bitvalo34/trama3-ccviii/hardware/README.md

# Hardware previsto

Una BBB existente y una placa perforada soldable por nodo, tres transmisores y tres receptores de datos, salida y entrada de reloj. Dos PC817 en total. La BOM original conserva cantidades y presupuesto; no se registra ninguna compra nueva.

Aquí se incorporarán esquemas, distribución, netlist y evidencias en las tareas posteriores. No hay circuito validado para energizar. Las fronteras eléctricas y pines propuestos están en el [ADR-0001](../docs/decisiones/ADR-0001-frontera-nodos-y-reloj.md).

## Inspección de las placas

[T02: inspección y diagnóstico](inspecciones/T02-inspeccion-beaglebone.md). Inicio28/10/2026; ejecución física de Erwin y revisión técnica prevista de Adrián. Informe parcial, sin cambios de configuración.
