bitvalo34/trama3-ccviii/hardware/inventario/Pendientes_2026-11-08.md

# Materiales pendientes al 8 de noviembre de 2026

Esta actualización prevalece sobre las brechas provisionales de T03-conciliacion-materiales.md. No registra compras nuevas como recibidas ni modifica el tracker original.

## Lo que ya está cubierto

Erwin confirma recepción de todos los artículos y variantes del pedido electrónico; también dispone de las tres resistencias de 1 kΩ y dos de 10 kΩ que faltaban. Confirma dos fuentes de 5 V / 2.5 A y casi 2 m de alambre negro 22 AWG. Falta conocer el conector de las fuentes y comprobar tensión/polaridad bajo carga. No se prescriben otras fuentes automáticamente.

MaterialesMedios.docx confirma: 1 m de manguera de media pulgada, caja de resortes, cuatro abrazaderas de una pulgada, 24 tuercas M3 paso 0.5, más de 24 tornillos M3×16, tornillos para abrazaderas, 25 arandelas M3, 100 cinchos, nylon 0.5 mm, 24 armellas, cuatro escuadras de una pulgada, 1 m de PVC eléctrico de una pulgada, espuma y dos bases MDF de 300×200 mm. Las fotos respaldan presencia; no miden diámetro interior ni constante de resorte. No recomprar estos artículos sólo por no estar en el pedido electrónico.

Dos tramos de manguera de 30 cm consumen 60 cm; dos tramos ópticos de 30 cm consumen 60 cm. El metro comprado alcanza en longitud. Comprobar el diámetro interior real de la manguera de media pulgada al acoplar los extremos, sin bloquear el paso de sonido.

## Carrito propuesto por el usuario

| Artículo | Cantidad | Total Q |
|---|---:|---:|
| Kit 65 jumpers | 1 | 32.00 |
| Estaño 18 g 60/40 con flux | 1 | 22.00 |
| Tira hembra de 40 pines | 2 | 6.00 |
| Bornera de 3 vías | 6 | 18.00 |
| Bornera de 2 vías | 12 | 24.00 |
| Zócalo DIP28 estrecho | 2 | 5.00 |
| Placa perforada de una cara 9×15 cm | 2 | 30.00 |
| Total sin envío | | 137.00 |

Es una compra propuesta, no recibida. Erwin ya había mencionado zócalos: si conserva dos DIP28 estrechos de 7.62 mm, quitar este renglón evita duplicar Q5. El estaño también es reposición opcional si el existente alcanza. El kit65 no acredita tener conectores hembra: revisar los extremos.

## Compra residual concreta

Precios públicos consultados el 08/11/2026. No se hizo reserva ni compra. En DIY la ficha permite añadir al carrito, pero no expone número de unidades por variante; no confundirlo con cantidad de stock verificada. Tettsa y OXDEA sí publican disponibilidad. Portes no incluidos.

| Uso | Compra propuesta | Unitario Q | Total Q | Fuente y disponibilidad publicada |
|---|---|---:|---:|---|
| Completar M27 y distinguir positivos/señales del negro | 3 m de alambre unifilar 22 AWG, rojo o color distinto | 2.25 | 6.75 | [DIY alambre 22 AWG](https://www.electronicadiy.com/products/cable-para-protoboard), compra habilitada; confirmar venta por metro al seleccionar |
| M41, conexiones flexibles de actuadores | 2 m de cable multifilar 22 AWG, 1 m rojo y 1 m negro | 2.25 | 4.50 | [DIY cable multifilar por metro](https://www.electronicadiy.com/products/cable-para-protoboard-22awg), compra habilitada |
| Arnés desmontable de señales, si el kit65 es sólo macho-macho | 20 jumpers macho-hembra de 20 cm, paso 2.54 mm | 0.85 | 17.00 | [DIY jumper 20 cm](https://www.electronicadiy.com/products/jumper-20-cm), seleccionar pieza macho-hembra, compra habilitada |
| Conectar servo y arneses a placa | 2 tiras macho rectas de 40 pines, paso 2.54 mm | 3.00 | 6.00 | [DIY pin header](https://www.electronicadiy.com/products/pin-header-40-pines), precio publicado; confirmar variante macho al seleccionar |
| Separar las dos placas soldadas de la base | 8 separadores aislantes nylon M3×15 mm hembra-hembra | 2.00 | 16.00 | [Tettsa separador M3×15](https://tienda.tettsa.gt/producto/separador-plastico-m3x15mm/), ficha indexada muestra 56 disponibles |
| Tornillos cortos para el lado de la placa | 8 tornillos M3×6 mm | 0.50 | 4.00 | [Sigma tornillo M3×6](https://electronicasigma.com.gt/producto/tornillo-m3-x-6mm/), En stock |
| Aislar soldaduras de arneses | 2 m termoencogible negro 3 mm, contracción 2:1 | 3.00 | 6.00 | [OXDEA termoencogible 3 mm](https://oxdea.gt/product/tubo-termoencogible-por-metro-de-3mm-color-negro/), En Existencia |
| Sellar alrededor de los acoples y fijación auxiliar | 4 barras de silicón delgadas, sólo si hay pistola compatible | 1.50 | 6.00 | [Sigma silicón delgado](https://electronicasigma.com.gt/producto/barra-de-silicon-delgada/), En stock |
| Total de estos renglones | | | 66.25 | No incluye portes ni adaptadores aún no identificados |

Carrito Q137 + lista Q66.25 = Q203.25 antes de envío. Es un presupuesto de los renglones indicados, no certificación de montaje completo. Si el kit ya trae los conectores requeridos, descontar Q17. Si ya hay zócalos compatibles, descontar Q5 del carrito. Conservar arandelas existentes, no comprarlas de nuevo.

El alambre unifilar adicional se propone de 3 m porque «casi 2 m» no acredita dos metros completos; así supera la previsión original de 4 m. No confundir alambre rígido con cable multifilar para recorridos que se doblan. Las longitudes finales se verifican antes de cortar.

El montaje de las dos BBB requiere también soportes aislantes si no se tienen: se pueden añadir otros 8 separadores y 8 tornillos cortos (Q20 adicionales en las mismas referencias). No duplicarlos si ya están montadas en soportes. Para fijar al MDF, elegir longitud con su espesor real; no forzar tornillos largos hasta hacer tope dentro de un separador.

Si no hay pistola de silicón, existe [EMTOP ULGGU1401 de 20 W, 110–120 V, barra 11.2 mm, con dos barras de 150 mm](https://ferrecity.com.gt/producto/ulggu1401-pistola-p-silicon-20w-120v/) a Q54, con 221 unidades publicadas. Es alternativa a las barras delgadas de la tabla, que no son compatibles con esa pistola; no sumar ambos sin necesidad. Puede conseguirse prestada.

## Pendientes que no justifican comprar a ciegas

- **Fuentes:** reservar las dos de 5 V/2.5 A para actuadores y mantener BBB por Mini USB durante pruebas de banco, si la alimentación resulta estable. Esto no equivale a una solución autónoma terminada. M34 sigue condicionado a cómo se alimentarán las BBB fuera del banco. Conector de fuentes desconocido: si no es Micro USB, los M28 no encajan. Elegir adaptador después de identificarlo; no cortar cables ni unir las salidas de dos fuentes.
- **Aislamiento óptico:** probar el PVC y las tapas contra luz ambiente. La espuma negra ya comprada puede ayudar en juntas. Un recubrimiento negro mate adicional sólo se compra si el interior produce reflejos problemáticos; no cambiar por fibra comercial.
- **Sensores:** el protocolo matricial no exige reemplazos. Medir primero LDR, detector acústico y mecanismo SG90 a 1 Hz. No se acredita una frecuencia máxima por compra ni por simulación.
- **Instrumentación:** falta acceso a osciloscopio o analizador lógico compatible para reloj/latencias. Puede ser prestado. El multímetro no reemplaza esa medida. No se cotiza como adquisición obligatoria.
- **Acoples:** las borneras deben encajar en la retícula de la placa; 5.08 mm corresponde a dos pasos de 2.54 mm. Confirmar la medida concreta. No forzar componentes al soldar.
- **Protección:** MCP23017 no es aislamiento galvánico ni garantía contra un cableado incorrecto. Verificar niveles en las entradas BBB y drivers según esquemas antes de conectar.

No cerrar T05 únicamente porque los sensores llegaron: queda recibir o confirmar el montaje residual y resolver conectores/alimentación. T03 puede actualizar su inventario con estas declaraciones, sin convertir el carrito en recibido ni dar por verificadas las pruebas eléctricas.
