bitvalo34/trama3-ccviii/hardware/diseno-placas/netlist/redes.csv

red | terminales
+3V3_LOGIC | U1.9; C4.1; R1.1; R2.1; R3.1; J10.1; J5.1; J6.1; R17.1; R18.1; R19.1; R26.1; R31.1; TP3.1
+5V_ACT | J12.2; C1.1; C2.1; J13.1; R6.1; J3.1; D1.2; TP1.1
+5V_FUSED | J14.2; J12.3
+5V_RAW | J1.1; J14.1; J11.1
+5V_SERVO | J13.2; J4.2; R12.1; R15.1; C3.1
AUD_BBB | J10.8; JP5.2
AUD_RAW | J6.3; R18.2; JP11.1; TP6.1
BUZZ_BASE | Q2.2; R7.2; R8.1
BUZZ_NEG | Q2.3; J3.2; D1.1
C0_SEL | JP10.2; R20.1; R23.1
C0_TEST | R20.2; JP4.1
C0_TX | U1.21; R4.1
C1_SEL | JP11.2; R21.1; R24.1
C1_TEST | R21.2; JP5.1
C1_TX | U1.22; R7.1
C2_SEL | JP12.2; R22.1; R25.1
C2_TEST | R22.2; JP6.1
CLK_BASE | Q5.2; R28.2; R29.1
CLK_BBB | J10.10; JP7.2
CLK_REMOTE_A | J8.1; U2.1; D2.2
CLK_REMOTE_K | J8.2; U2.2; D2.1
CLK_RX_RAW | U2.4; R26.2; R27.1; TP8.1
CLK_SEND_A | R31.2; J9.1
CLK_SINK | Q5.3; J9.2
CLK_TEST | R27.2; JP7.1
CLK_TX | J10.6; R28.1; TP10.1
GATE_POL | J12.1; R30.1
GND_ACT | J1.2; R30.2; C1.2; C2.2; NT1.1; J11.2; J13.6; J4.1; Q3.1; Q4.1; R11.2; R14.2; R16.2; C3.2; Q1.1; R5.2; Q2.1; R8.2; TP2.1
GND_LOGIC | NT1.2; U1.10; U1.15; U1.16; U1.17; C4.2; JP1.2; J10.2; J5.2; J6.2; J7.1; C5.2; JP10.3; R23.2; JP11.3; R24.2; JP12.3; R25.2; U2.3; Q5.1; R29.2; TP4.1
I2C_SCL | U1.12; JP2.2; J10.3
I2C_SDA | U1.13; JP3.2; J10.4
LED_A | R6.2; J2.1
LED_BASE | Q1.2; R4.2; R5.1
LED_K | Q1.3; J2.2
MCP_RESET | U1.18; R1.2; JP1.1
MECH_BBB | J10.9; JP6.2
MECH_RAW | J7.2; R19.2; C5.1; JP12.1; TP7.1
OPT_BBB | J10.7; JP4.2
OPT_RAW | J5.3; R17.2; JP10.1; TP5.1
PWM_5V | J13.4; Q4.3; R15.2
PWM_B1 | Q3.2; R10.2; R11.1
PWM_B2 | Q4.2; R13.2; R14.1
PWM_BBB | R10.1; J10.5
PWM_INV | Q3.3; R12.2; R13.1
SCL_PULL | R2.2; JP2.1
SDA_PULL | R3.2; JP3.1
SERVO_SIG | J13.5; J4.3; R16.1; TP9.1
