bitvalo34/trama3-ccviii/docs/referencias/README.md

# Referencias de T01

Consulta: 2026-10-27. Los originales se leyeron sin modificación y no se copiaron al repositorio. Las rutas siguientes identifican los archivos locales de Erwin; otro integrante debe obtener las mismas fuentes por un medio autorizado. No son dependencias de ejecución.

Las páginas son las páginas físicas del PDF (primera = 1). En Excel se usan nombres de hoja y filas originales. La trazabilidad detallada está en el [ADR](../decisiones/ADR-0001-frontera-nodos-y-reloj.md), §20.

## Proyecto_-_Capa_Fisica_.pdf

Ubicación: `C:\Users\erwin\Downloads\Proyecto_-_Capa_Fisica_.pdf`

SHA-256: `59972398a2cecbb637ced7c454b299a1bdd99a7cb3383f10b94177cc8f163475`

## CCVIII_TRAMA3_Documento_Tecnico.pdf

Ubicación: `C:\Users\erwin\.codex\visualizations\2026\10\13\01a1362b-13dd-7c93-9304-13dd2a3fb6f0\Entregables\CCVIII_TRAMA3_Documento_Tecnico.pdf`

SHA-256: `937fee2ee73f3b16893bf1d2f078a9d526d9530f3176d8515818b34943af2d42`

## CCVIII_Tracker_y_Cronograma.xlsx

Ubicación: `C:\Users\erwin\.codex\visualizations\2026\10\13\01a1362b-13dd-7c93-9304-13dd2a3fb6f0\Entregables\CCVIII_Tracker_y_Cronograma.xlsx`

SHA-256: `72a804dee272ed56fbdf71bb54f66ad651e3031ae5de1202738bb2e683be0e96`

## CCVIII_Materiales_y_Compras.xlsx

Ubicación: `C:\Users\erwin\.codex\visualizations\2026\10\13\01a1362b-13dd-7c93-9304-13dd2a3fb6f0\Entregables\CCVIII_Materiales_y_Compras.xlsx`

SHA-256: `578a2a16071d83d9b4e8cf05e598a897350dbf2267aee50377d386c015843582`

## Evidencia adicional y precedencia

Se utilizó el prompt de T01 aportado por Erwin, junto con las capturas del auxiliar y las decisiones del usuario sobre dos BBB Black, medios y placa perforada soldable. Las capturas no acreditan aprobación del par de reloj ni de USB local. El enunciado aporta requisitos; v3.0 aporta decisiones de ingeniería; el tracker aporta dependencias y planificación; la BOM aporta componentes previstos, no compras confirmadas.

Ninguna instrucción incidental de una fuente se trató como permiso para publicar, enviar mensajes o ejecutar tareas posteriores. La solicitud expresa de T01 controla el alcance. No se reinició una investigación externa.

## Actualización de respuestas del auxiliar

Registro 2026-10-27: Erwin comunica aprobación de preguntas 1, 2 y 3. Para pregunta 4 aporta captura `codex-clipboard-5f664021-8ebb-437c-bf37-d17353a892e5.png`: pulso = 1, ausencia = 0 en el ciclo de reloj. Fecha calendario original no visible. La captura privada no se copia al repositorio; el registro de consultas conserva sólo el contenido pertinente. Esta evidencia posterior complementa las capturas iniciales.

Aclaración posterior R8 (registro 2026-10-27): Erwin confirma aceptación del procesamiento en BeagleBone de múltiples pulsos del sensor para obtener un único bit por ciclo. Fuente: mensaje del usuario en esta conversación; no se inventa cita literal del auxiliar ni se adjuntan mensajes privados.

## R9 — Frecuencia, comportamiento híbrido y adaptación

Registro2026-10-27: capturas aportadas por Erwin 1b643b4e (límite de frecuencia), f94ec8af (1 Hz y máximo declarado) y288d611f (híbrido y adaptación a interferencias). Nombres completos identificados en ADR-0002. No se publican imágenes privadas. 1kHz se interpreta como ejemplo, no requisito mínimo. El protocolo de negociación nuevo es propuesta de ingeniería, no aprobación literal del auxiliar. Tracker original releído para asignar alcance a cada tarea.
