bitvalo34/trama3-ccviii/hardware/inspecciones/evidencias/README.md

# Evidencia de T02

Inicio28/10/2026. El [informe](../T02-inspeccion-beaglebone.md) resume consultas Windows Get-NetAdapter, Get-NetIPAddress, Get-PnpDevice y Get-PnpDeviceProperty, ping y conexión TCP22 limitada a2,5s. Posteriormente Erwin compartió captura de su sesión SSH autenticada: Debian10 Buster, kernel4.19.94-ti-r42, armv7l y uptime14min. Se transcriben sólo resultados pertinentes; no se publica la captura, que incluye información de acceso y red.

No se publican números de serie, MAC, identificadores únicos USB, credenciales ni volcado de redes del anfitrión. Se omiten direcciones internas y banner SSH exacto del registro público. No hay fotografías ni evidencia de BBB-B todavía.

Cada nueva evidencia debe indicar fecha, placa, procedimiento, resultado y límites. Antes de publicar revisar identificadores y guardar sólo extractos pertinentes. Distinguir observación física de inferencia.

Evidencia aportada: `codex-clipboard-2fbf805f-1848-42a9-b130-c92d83c231c9.png`, conservada fuera del repositorio público. Confirmación textual de Erwin: Mini USB únicamente y ningún accesorio.

Segunda captura: `codex-clipboard-268b4e4f-0846-452b-a13e-f8ea41f85a08.png`. Se transcriben modelo, RAM, almacenamiento, montaje y0unidades fallidas en el informe. Observación textual asociada: alimentación fija, D2 parpadea y D4 tenue. Captura original no publicada.

Tercera captura: `codex-clipboard-b3606f9c-fe50-412e-a091-e6a684b551ce.png`: tipo MMC, dispositivos remoteproc/I2C/PWM, herramientas presentes y triggers de LEDs. Valores pertinentes transcritos; sin publicar imagen.

Cierre 07/11/2026: el informe consolida las capturas posteriores de B y la confirmación textual de Erwin sobre ambas placas, cables y herramientas. La indicación anterior de ausencia de evidencia de B corresponde sólo al inicio del registro. No se publican las capturas ni credenciales.
