bitvalo34/trama3-ccviii/hardware/diseno-placas/planos/A-inferior.png

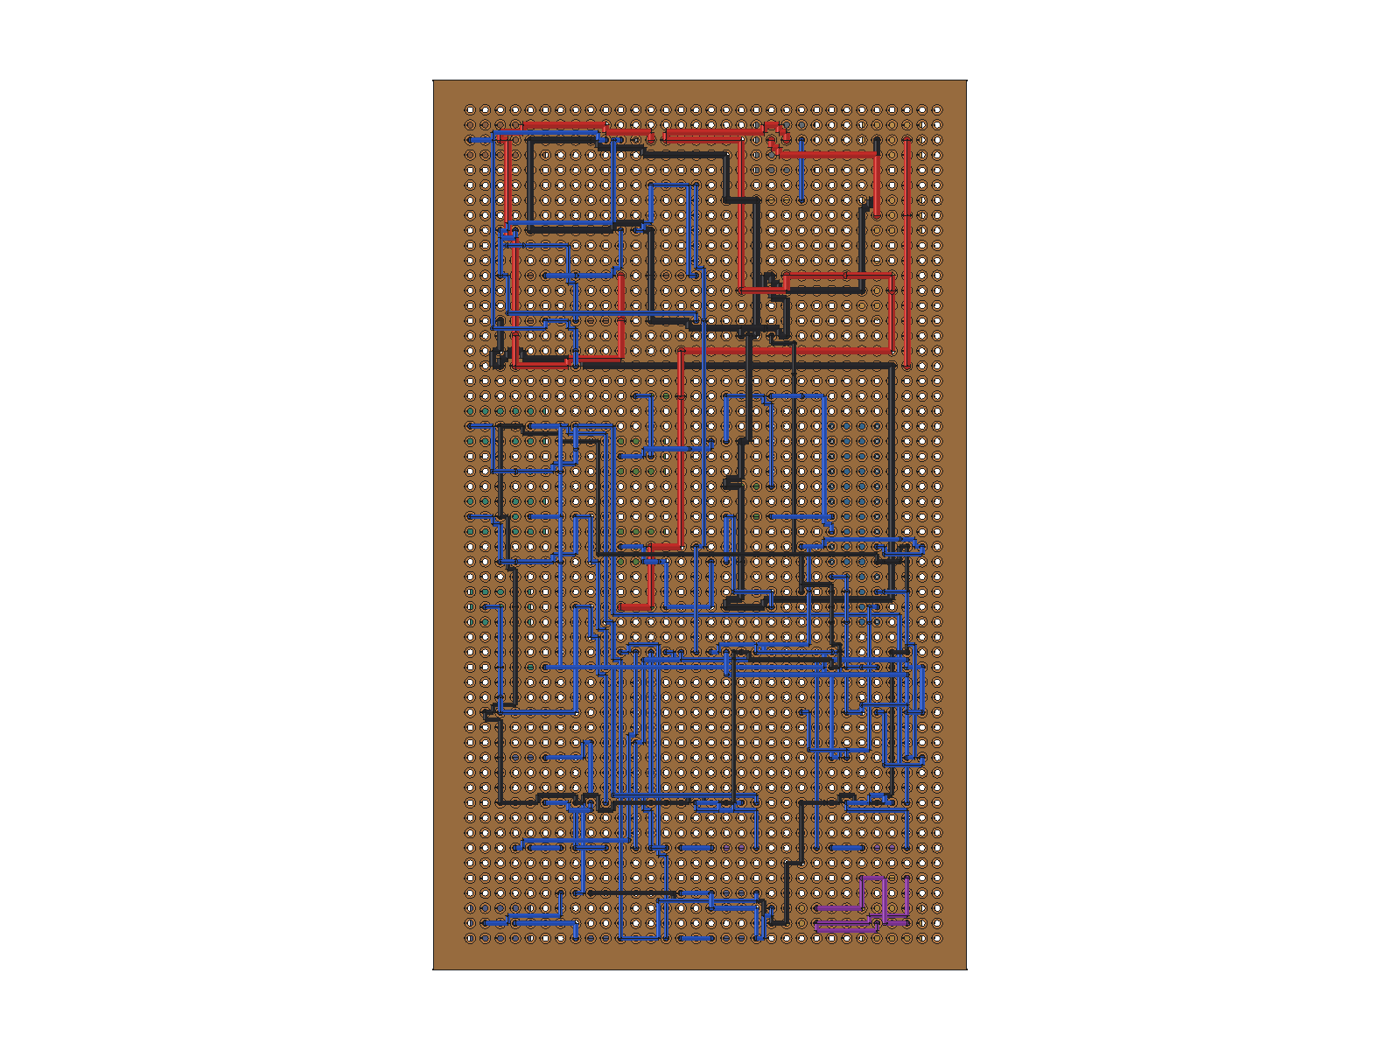
hardware/diseno-placas/planos/A-inferior.png
