bitvalo34/trama3-ccviii/hardware/diseno-placas/planos/A-isometrica.png

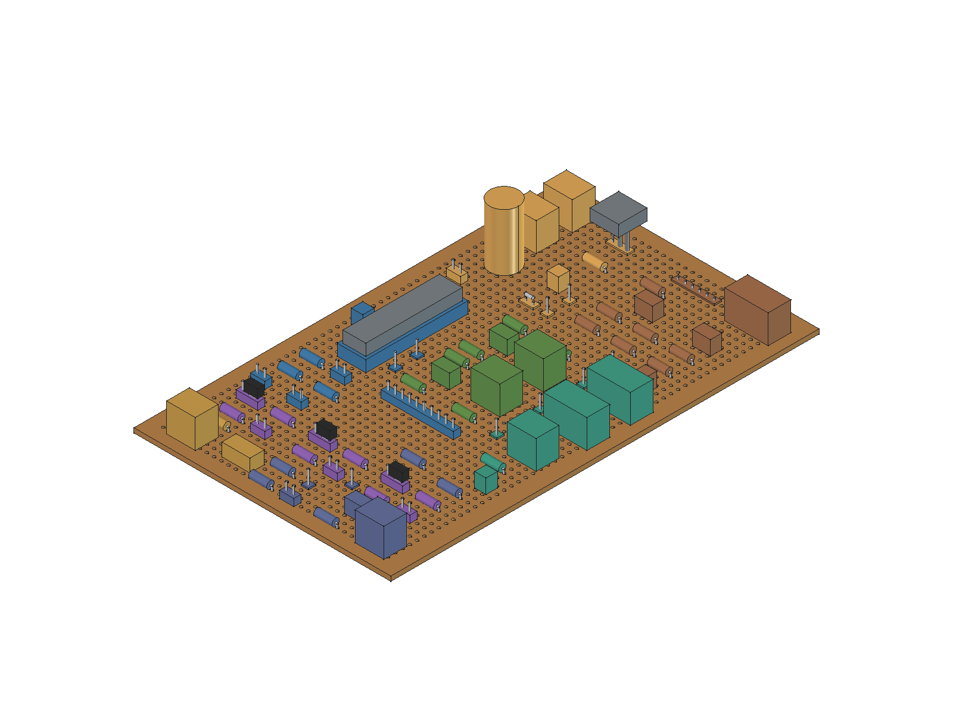
hardware/diseno-placas/planos/A-isometrica.png
