bitvalo34/trama3-ccviii/hardware/diseno-placas/planos/A-lateral.png

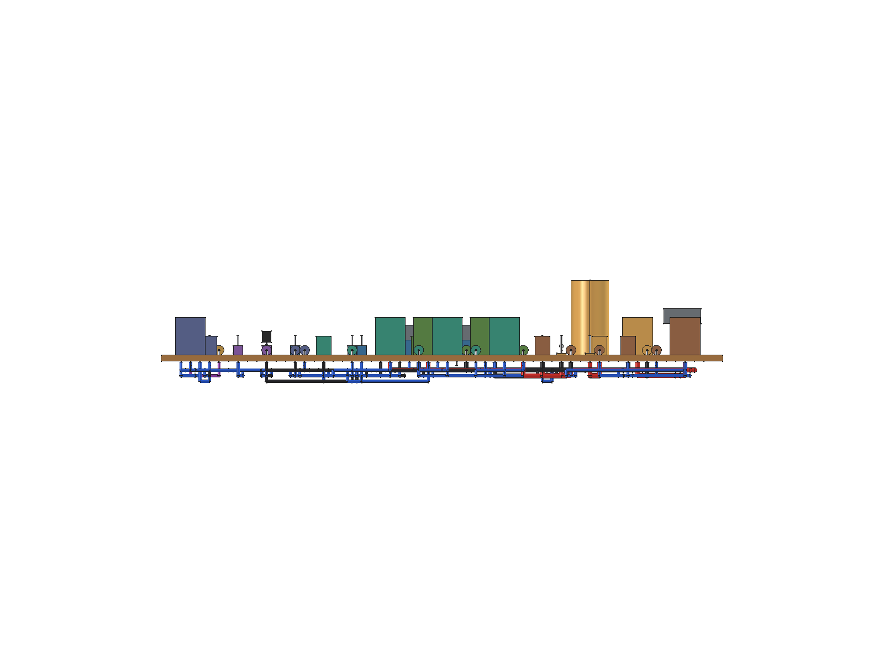
hardware/diseno-placas/planos/A-lateral.png
