bitvalo34/trama3-ccviii/hardware/diseno-placas/planos/A-posterior.png

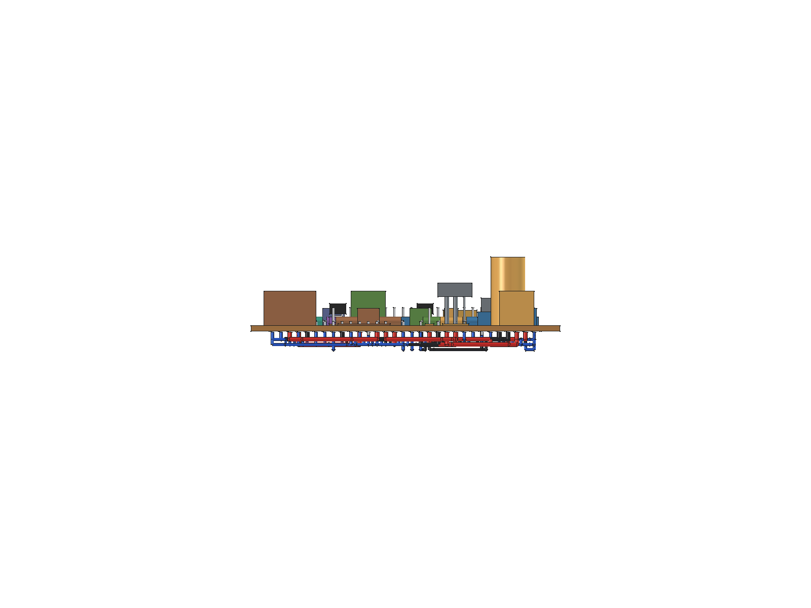
hardware/diseno-placas/planos/A-posterior.png
