bitvalo34/trama3-ccviii/hardware/diseno-placas/planos/A-superior.png

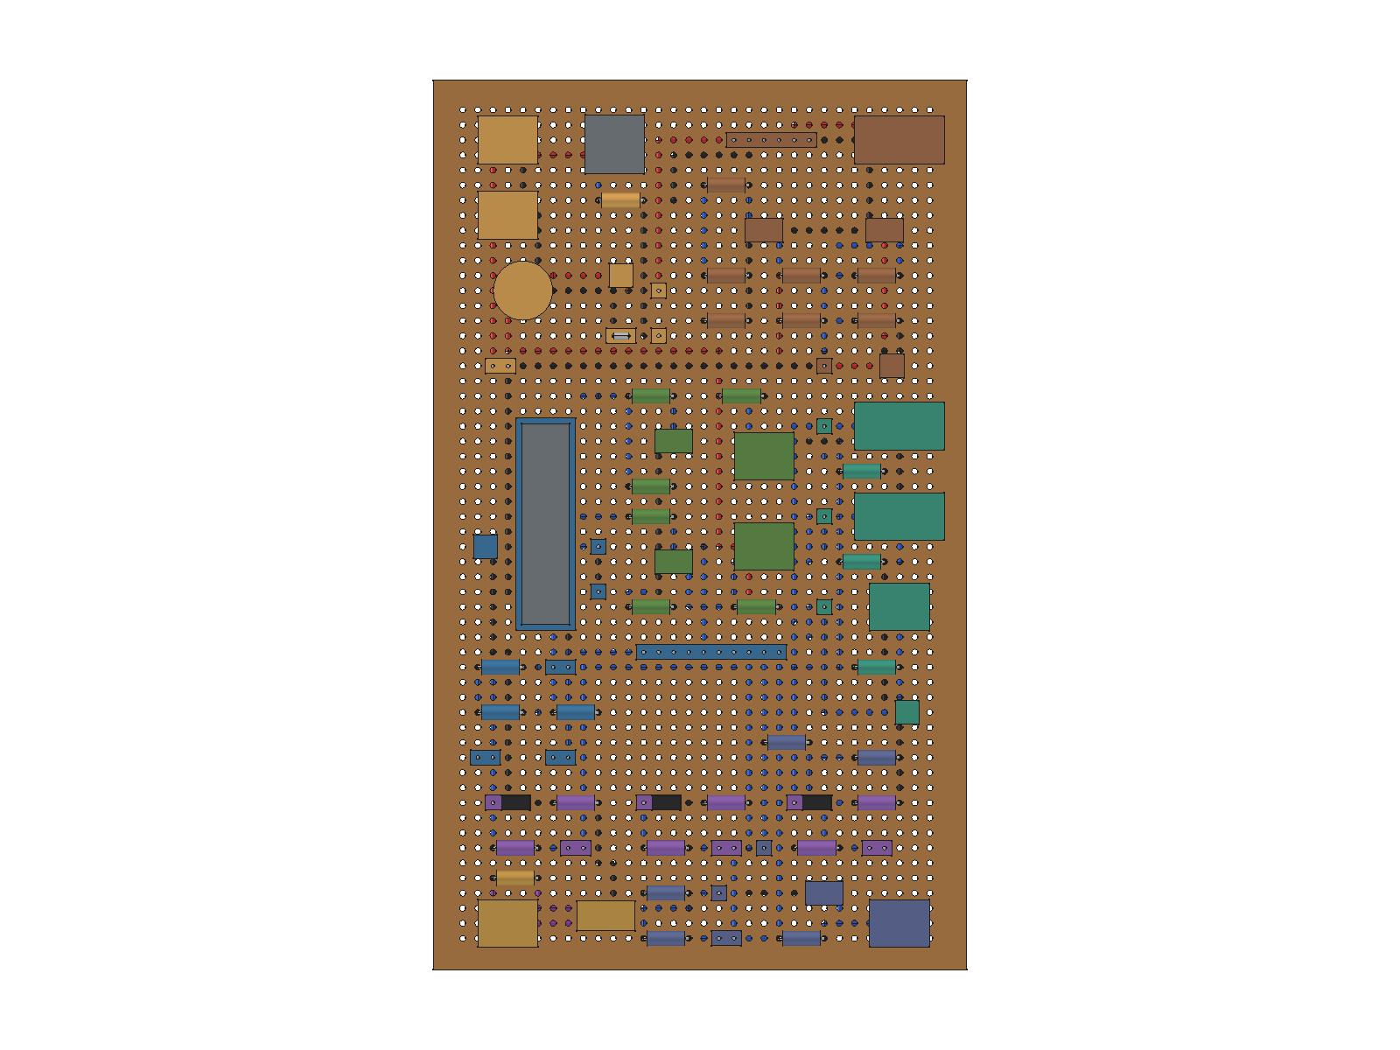
hardware/diseno-placas/planos/A-superior.png
