bitvalo34/trama3-ccviii/hardware/inventario/CCVIII_Materiales_y_Compras_T03.xlsx

Sheet: Dashboard
TRAMA 3 BeagleBone Black Compras v3
Medios elegidos y placa perforada soldable. 2 BBB existentes. Ámbar = editable.
Concepto | Importe o valor | Interpretación | Categoría | Costo sin otros reusos Q
Materiales sin otros reusos | Q 912.00 | BBB existentes Q0; excluye costo de reemplazarlas | Óptico | Q 53.50
Compra con inventario | Q 912.00 | Descuenta existencia declarada o inventario aprobado | Acústico | Q 81.00
Reserva | 10.0% | Porcentaje editable | Mecánico | Q 98.00
Total base con reserva | Q 1003.20 | Incluye montaje soldado y 2 fuentes BBB provisionadas | Protecciones | Q 55.50
Total con inventario y reserva | Q 1003.20 | Presupuesto actual de compra | Compartida | Q 624.00
Gasto pendiente sin reserva | Q 912.00 | Compra menos pagos registrados | Placas | Q 0.00
Objetivo completo | Q 1200.00 | Límite orientativo de desembolso
Margen frente a objetivo | Q 196.80 | Positivo significa dentro del objetivo
Publicado en fichas | Q 588.00 | No equivale a cantidad física confirmada
Provisiones sin cotización | Q 324.00 | Materiales locales, fuentes y montaje
Ahorro adicional por inventario | Q 0.00 | Adicional a las dos BBB ya incluidas a Q0
Presupuesto anterior v2 | Q 918.50 | Referencia con BBB y protoboards
Cambio frente a v2 | Q 84.70 | Positivo = aumento por montaje soldado
Provisiones sin cotización | 8 | No cuenta las BBB declaradas; confirmar 8 partidas
Fecha de revisión | 2026-10-15 | Nuevos precios 15/10; anteriores mantienen fecha en BOM

Sheet: BOM maestra
Materiales para ambos equipos
32 fichas de compra, 8 provisiones y 2 BBB declaradas. Selección confirmada; compra pendiente de registrar.
ID | Categoría | Subsistema | Material | Modelo | Variante | Por TX | Por RX | Por equipo | Total proyecto | Disponible propio | Por comprar | Precio unitario Q | Compra Q | Sin otros reusos Q | Proveedor | Enlace directo | Disponibilidad | Unidades publicadas | Verificado | Alternativa | Prioridad | Observaciones | Base del precio | Pagado Q | Gasto pendiente Q
M01 | Placas | Control | BeagleBone Black existente | BeagleBone Black AM335x | Modelo confirmado por el usuario | 0 | 0 | 1 | 2 | 2 | 0 | Q 0.00 | Q 0.00 | Q 0.00 | Inventario de Erwin y Adrián | Inventario declarado | Existencia confirmada por usuario | 2 placas declaradas; arranque por comprobar | 2026-10-13 |  | Alta | Costo incremental Q0; no es precio de reposición. Verificar revisión, Debian, eMMC, conectores y alimentación. No comprar ESP32. | Reutilizado | Q 0.00 | Q 0.00
M02 | Compartida | GPIO | Expansor GPIO | MCP23017 DIP28 | Variante única | 0 | 0 | 1 | 2 | 0 | 2 | Q 52.00 | Q 104.00 | Q 104.00 | Electrónica DIY | HYPERLINK is not implemented. linkLocation=https://www.electronicadiy.com/products/mcp23017?variant=40473663832246, friendlyName=Abrir variante | Disponible y verificado | No publica cantidad; confirmar lote | 2026-10-13 |  | Alta | VDD 3.3 V; A0 A1 A2 a GND; dirección 0x20. No aislamiento. No usar GPA7/GPB7 de entrada. | Publicado | Q 0.00 | Q 104.00
M03 | Óptico | Luz | LED rojo transparente | LED 5 mm rojo | Rojo | 1 | 0 | 1 | 2 | 0 | 2 | Q 0.75 | Q 1.50 | Q 1.50 | Electrónica DIY | HYPERLINK is not implemented. linkLocation=https://www.electronicadiy.com/products/led-transparente-5mm-diferentes-colores?variant=33522998345867, friendlyName=Abrir variante | Disponible y verificado | No publica cantidad; confirmar lote | 2026-10-13 |  | Alta | Transmisor; resistencia de 330 ohm; no LED intermitente. | Publicado | Q 0.00 | Q 1.50
M04 | Óptico | Luz | Módulo LDR digital | D6 LDR LM393 | Variante única | 0 | 1 | 1 | 2 | 0 | 2 | Q 16.00 | Q 32.00 | Q 32.00 | Electrónica DIY | HYPERLINK is not implemented. linkLocation=https://www.electronicadiy.com/products/sensor-de-luz?variant=33523038847115, friendlyName=Abrir variante | Disponible y verificado | No publica cantidad; confirmar lote | 2026-10-13 |  | Alta | Alimentar a 3.3 V. Confirmar VOH y VOL reales antes de conectar. | Publicado | Q 0.00 | Q 32.00
M05 | Acústico | Sonido | Buzzer activo | Buzzer activo 2 terminales | Activo | 1 | 0 | 1 | 2 | 0 | 2 | Q 3.50 | Q 7.00 | Q 7.00 | Electrónica DIY | HYPERLINK is not implemented. linkLocation=https://www.electronicadiy.com/products/buzzer-sin-modulo?variant=33522945851531, friendlyName=Abrir variante | Disponible y verificado | No publica cantidad; confirmar lote | 2026-10-13 |  | Alta | Exigir variante 5 V y consumo <=30 mA; si no se confirma usar módulo activo como alternativa. | Publicado | Q 0.00 | Q 7.00
M06 | Acústico | Sonido | Detector de sonido | KY037 SKU D14 | Variante única | 0 | 1 | 1 | 2 | 0 | 2 | Q 19.00 | Q 38.00 | Q 38.00 | Electrónica DIY | HYPERLINK is not implemented. linkLocation=https://www.electronicadiy.com/products/sensor-de-sonido-ky-038?variant=33523035799691, friendlyName=Abrir variante | Disponible y verificado | No publica cantidad; confirmar lote | 2026-10-13 |  | Alta | URL dice KY038 y ficha KY037. Confirmar el módulo servido. DO es pulsante; contador de flancos, no lectura única. | Publicado | Q 0.00 | Q 38.00
M07 | Mecánico | Tensión | Servo posicional | SG90 180 grados | Variante única | 1 | 0 | 1 | 2 | 0 | 2 | Q 27.00 | Q 54.00 | Q 54.00 | Electrónica DIY | HYPERLINK is not implemented. linkLocation=https://www.electronicadiy.com/products/micro-servo-sg90-1-6kg-torque?variant=33523024494731, friendlyName=Abrir variante | Disponible y verificado | No publica cantidad; confirmar lote | 2026-10-13 |  | Alta | No aceptar servo continuo 360 grados. Fuente 5 V externa local. Recorrido inicial 20 grados. | Publicado | Q 0.00 | Q 54.00
M08 | Mecánico | Tensión | Final de carrera | SPDT con rueda | Con Rueda | 0 | 1 | 1 | 2 | 0 | 2 | Q 7.00 | Q 14.00 | Q 14.00 | Electrónica DIY | HYPERLINK is not implemented. linkLocation=https://www.electronicadiy.com/products/switch-final-de-carrera?variant=33522901024907, friendlyName=Abrir variante | Disponible y verificado | No publica cantidad; confirmar lote | 2026-10-13 |  | Alta | COM y NO locales al receptor. El único vínculo de datos mecánico es nylon sin metal. | Publicado | Q 0.00 | Q 14.00
M09 | Protecciones | Drivers | Transistor NPN | 2N2222 | 2N2222-NPN | 2 | 0 | 2 | 4 | 0 | 4 | Q 0.75 | Q 3.00 | Q 3.00 | Electrónica DIY | HYPERLINK is not implemented. linkLocation=https://www.electronicadiy.com/products/transistores?variant=33523007357067, friendlyName=Abrir variante | Disponible y verificado | No publica cantidad; confirmar lote | 2026-10-13 |  | Alta | Uno para LED y otro buzzer. Revisar pinout del lote. Base 1k, base a GND 10k. | Publicado | Q 0.00 | Q 3.00
M10 | Protecciones | Servo | Transistor de señal | 2N3904 | 2N3904-NPN | 1 | 0 | 1 | 2 | 0 | 2 | Q 0.75 | Q 1.50 | Q 1.50 | Electrónica DIY | HYPERLINK is not implemented. linkLocation=https://www.electronicadiy.com/products/transistores?variant=33523007422603, friendlyName=Abrir variante | Disponible y verificado | No publica cantidad; confirmar lote | 2026-10-13 |  | Alta | Inversor 3.3 a 5 V para servo. Base 4.7k; pull-up 10k del lado P9_14 a 3.3 V, NO directamente en la base. PWM invertida. | Publicado | Q 0.00 | Q 1.50
M11 | Protecciones | Reloj | Optoacoplador | PC817 DIP4 | Variante única | 0 | 1 | 1 | 2 | 0 | 2 | Q 4.00 | Q 8.00 | Q 8.00 | Electrónica DIY | HYPERLINK is not implemented. linkLocation=https://www.electronicadiy.com/products/optoacoplador-pc817?variant=46738098618626, friendlyName=Abrir variante | Disponible y verificado | No publica cantidad; confirmar lote | 2026-10-13 |  | Alta | 1 ánodo 2 cátodo del emisor remoto; 3 emisor y 4 colector locales. Dos hilos por reloj. | Publicado | Q 0.00 | Q 8.00
M12 | Protecciones | Inductiva | Diodo rueda libre | 1N4148 | Variante única | 1 | 0 | 1 | 2 | 0 | 2 | Q 0.75 | Q 1.50 | Q 1.50 | Electrónica DIY | HYPERLINK is not implemented. linkLocation=https://www.electronicadiy.com/products/diodo-1n4148-recuperacion-rapida-100-v-200-ma?variant=42863743664386, friendlyName=Abrir variante | Disponible y verificado | No publica cantidad; confirmar lote | 2026-10-13 |  | Alta | Paralelo al buzzer si es magnético <=30mA; cátodo a +5 V. No colocar un diodo sobre alimentación del servo. | Publicado | Q 0.00 | Q 1.50
M13 | Protecciones | LED | Resistencia 1/4W | 330 ohm | 330 | 0 | 0 | 1 | 2 | 0 | 2 | Q 0.50 | Q 1.00 | Q 1.00 | Electrónica DIY | HYPERLINK is not implemented. linkLocation=https://www.electronicadiy.com/products/resistencias-por-unidad-1-4w?variant=33598010261643, friendlyName=Abrir variante | Disponible y verificado | No publica cantidad; confirmar lote | 2026-10-13 |  | Alta | Limita LED rojo a aprox 8.5mA desde 5V | Publicado | Q 0.00 | Q 1.00
M14 | Protecciones | Reloj | Resistencia 1/4W | 390 ohm | 390 | 0 | 0 | 1 | 2 | 0 | 2 | Q 0.50 | Q 1.00 | Q 1.00 | Electrónica DIY | HYPERLINK is not implemented. linkLocation=https://www.electronicadiy.com/products/resistencias-por-unidad-1-4w?variant=33598010327179, friendlyName=Abrir variante | Disponible y verificado | No publica cantidad; confirmar lote | 2026-10-13 |  | Alta | LED PC817 aproximadamente 5mA desde GPIO 3.3V | Publicado | Q 0.00 | Q 1.00
M15 | Protecciones | Servo | Resistencia 1/4W | 100 ohm | 100 | 0 | 0 | 1 | 2 | 0 | 2 | Q 0.50 | Q 1.00 | Q 1.00 | Electrónica DIY | HYPERLINK is not implemented. linkLocation=https://www.electronicadiy.com/products/resistencias-por-unidad-1-4w?variant=33598009868427, friendlyName=Abrir variante | Disponible y verificado | No publica cantidad; confirmar lote | 2026-10-13 |  | Alta | Serie en señal 5V del servo | Publicado | Q 0.00 | Q 1.00
M16 | Protecciones | Resistencias | Resistencia 1/4W | 1K ohm | 1K | 0 | 0 | 6 | 12 | 0 | 12 | Q 0.50 | Q 6.00 | Q 6.00 | Electrónica DIY | HYPERLINK is not implemented. linkLocation=https://www.electronicadiy.com/products/copia-de-resistencias-por-unidad-kilo-ohms-1-4w?variant=33598149427339, friendlyName=Abrir variante | Disponible y verificado | No publica cantidad; confirmar lote | 2026-10-13 |  | Alta | Bases LED/buzzer, entradas óptico/acústico/mecánico/reloj | Publicado | Q 0.00 | Q 6.00
M17 | Protecciones | Resistencias | Resistencia 1/4W | 4.7K ohm | 4.7K | 0 | 0 | 5 | 10 | 0 | 10 | Q 0.50 | Q 5.00 | Q 5.00 | Electrónica DIY | HYPERLINK is not implemented. linkLocation=https://www.electronicadiy.com/products/copia-de-resistencias-por-unidad-kilo-ohms-1-4w?variant=33598149918859, friendlyName=Abrir variante | Disponible y verificado | No publica cantidad; confirmar lote | 2026-10-13 |  | Alta | 2 pull-up I2C, base y colector servo, colector PC817 | Publicado | Q 0.00 | Q 5.00
M18 | Protecciones | Resistencias | Resistencia 1/4W | 10K ohm | 10K | 0 | 0 | 5 | 10 | 0 | 10 | Q 0.50 | Q 5.00 | Q 5.00 | Electrónica DIY | HYPERLINK is not implemented. linkLocation=https://www.electronicadiy.com/products/copia-de-resistencias-por-unidad-kilo-ohms-1-4w?variant=33598150181003, friendlyName=Abrir variante | Disponible y verificado | No publica cantidad; confirmar lote | 2026-10-13 |  | Alta | 2 bases a GND, P9_14 a 3.3 V antes de resistencia de base, switch pull-up, RESET MCP. | Publicado | Q 0.00 | Q 5.00
M19 | Protecciones | Desacoplo | Capacitor cerámico | 100 nF | 100 nF | 0 | 0 | 4 | 8 | 0 | 8 | Q 0.75 | Q 6.00 | Q 6.00 | Electrónica DIY | HYPERLINK is not implemented. linkLocation=https://www.electronicadiy.com/products/capacitores-ceramicos-monoliticos-nanofaradios?variant=44462606745858, friendlyName=Abrir variante | Disponible y verificado | No publica cantidad; confirmar lote | 2026-10-13 |  | Alta | MCP, sensor óptico, sensor acústico y switch. Un capacitor de switch crea filtro aprox 1ms. | Publicado | Q 0.00 | Q 6.00
M20 | Protecciones | Alimentación | Capacitor electrolítico | 1000uF 16V | 1000uF | 0 | 0 | 1 | 2 | 0 | 2 | Q 3.50 | Q 7.00 | Q 7.00 | Electrónica DIY | HYPERLINK is not implemented. linkLocation=https://www.electronicadiy.com/products/capacitores-electroliticos-16v?variant=33522920063115, friendlyName=Abrir variante | Disponible y verificado | No publica cantidad; confirmar lote | 2026-10-13 |  | Alta | Junto al servo, polaridad correcta. | Publicado | Q 0.00 | Q 7.00
M21 | Protecciones | Alimentación | Fusible | 5x20mm 1A | 1A | 0 | 0 | 1 | 2 | 0 | 2 | Q 0.75 | Q 1.50 | Q 1.50 | Electrónica DIY | HYPERLINK is not implemented. linkLocation=https://www.electronicadiy.com/products/fusible-de-vidrio-5x20mm?variant=35648890175639, friendlyName=Abrir variante | Disponible y verificado | No publica cantidad; confirmar lote | 2026-10-13 |  | Alta | En rama actuadores 5 V. Validar corriente de arranque sin puentear fusible. | Publicado | Q 0.00 | Q 1.50
M22 | Protecciones | Alimentación | Portafusible | 5x20mm con cable | Variante única | 0 | 0 | 1 | 2 | 0 | 2 | Q 4.00 | Q 8.00 | Q 8.00 | Electrónica DIY | HYPERLINK is not implemented. linkLocation=https://www.electronicadiy.com/products/porta-fusible-5x20mm-con-cable?variant=44265218146562, friendlyName=Abrir variante | Disponible y verificado | No publica cantidad; confirmar lote | 2026-10-13 |  | Alta |  | Publicado | Q 0.00 | Q 8.00
M23 | Compartida | Alimentación | Fuente cerrada | 5V 2.5A | Variante única | 0 | 0 | 1 | 2 | 0 | 2 | Q 55.00 | Q 110.00 | Q 110.00 | Electrónica DIY | HYPERLINK is not implemented. linkLocation=https://www.electronicadiy.com/products/adaptador-110vac-raspberry-pi-5v?variant=33522949914763, friendlyName=Abrir variante | Disponible y verificado | No publica cantidad; confirmar lote | 2026-10-13 |  | Alta | Fuente de actuadores con salida MICRO USB; usar breakout M28. No alimentar el servo desde P9. Separada de la fuente BBB M34. | Publicado | Q 0.00 | Q 110.00
M24 | Compartida | Conexiones | Cable USB local | USB A a Mini USB B de datos | Arduino NANO (Mini USB) | 0 | 0 | 1 | 2 | 0 | 2 | Q 10.00 | Q 20.00 | Q 20.00 | Electrónica DIY | HYPERLINK is not implemented. linkLocation=https://www.electronicadiy.com/products/cables-usb-para-arduino?variant=33523010371723, friendlyName=Abrir variante | Disponible y verificado | No publica cantidad; confirmar lote | 2026-10-13 |  | Alta | Terminal PC a su BBB por USB gadget/SSH local. Mini USB, no Micro ni USB C. Confirmar si ya tienen estos cables. | Publicado | Q 0.00 | Q 20.00
M25 | Compartida | Montaje | Placa perforada soldable | Una cara 9x15 cm | 9x15cm | 0 | 0 | 1 | 2 | 0 | 2 | Q 15.00 | Q 30.00 | Q 30.00 | Electrónica DIY | HYPERLINK is not implemented. linkLocation=https://www.electronicadiy.com/products/placa-perforada?variant=33522900238475, friendlyName=Abrir variante | Disponible y verificado | Disponible publicado; cantidad de lote por confirmar | 2026-10-15 |  | Alta | Una por nodo. Sustituye protoboard. Verificar paso 2.54 mm, islas y huellas antes de soldar; BBB externa en soportes. Variante 10x15 cm agotada al consultar. | Publicado | Q 0.00 | Q 30.00
M26 | Compartida | Montaje | Jumpers internos | Kit 65 | Variante única | 0 | 0 | 0.5 | 1 | 0 | 1 | Q 32.00 | Q 32.00 | Q 32.00 | Electrónica DIY | HYPERLINK is not implemented. linkLocation=https://www.electronicadiy.com/products/kit-65-jumpers?variant=33523009028235, friendlyName=Abrir variante | Disponible y verificado | No publica cantidad; confirmar lote | 2026-10-13 |  | Alta | Un kit compartido. Conecta headers BBB a tiras hembra de placa; fijar y etiquetar. No conducir corriente del servo por Dupont. | Publicado | Q 0.00 | Q 32.00
M27 | Compartida | Montaje | Alambre interno | 22 AWG unifilar | Negro | 0 | 0 | 2 | 4 | 0 | 4 | Q 2.25 | Q 9.00 | Q 9.00 | Electrónica DIY | HYPERLINK is not implemented. linkLocation=https://www.electronicadiy.com/products/cable-para-protoboard?variant=34500933058711, friendlyName=Abrir variante | Disponible y verificado | No publica cantidad; confirmar lote | 2026-10-13 |  | Alta | 4 m de alambre para puentes soldados de señal y pares de reloj; no confundir nombre comercial con uso de protoboard. Retorno de actuadores separado con M41. | Publicado | Q 0.00 | Q 9.00
M28 | Compartida | Montaje | Breakout alimentación actuadores | Micro USB hembra a DIP2.54 | VBUS y GND; datos sin conectar | 0 | 0 | 1 | 2 | 0 | 2 | Q 3.00 | Q 6.00 | Q 6.00 | Electrónica DIY | HYPERLINK is not implemented. linkLocation=https://www.electronicadiy.com/products/modulo-micro-usb-hembra-a-dip2-54?variant=36889173295255, friendlyName=Abrir variante | Disponible y verificado | No publica cantidad; confirmar lote | 2026-10-13 |  | Alta | Recibe la fuente Micro USB M23; llevar VBUS al fusible de 1 A y GND a retorno actuadores. No transportar corriente del servo por carril débil; comprobar caída y calentamiento. | Publicado | Q 0.00 | Q 6.00
M29 | Óptico | Óptico | Tubo opaco y soportes | Tubo cartón/PVC 30 cm, interior negro; sin fibra comercial | Tubo cartón/PVC 30 cm, interior negro; sin fibra comercial | 0 | 0 | 1 | 2 | 0 | 2 | Q 10.00 | Q 20.00 | Q 20.00 | Ferretería local por confirmar | Sin cotización | Pendiente de confirmación | Sin cotización | 2026-10-13 | Reutilizar tras inspección | Alta | Provisión de planificación, no precio publicado ni disponibilidad verificada. | Estimado | Q 0.00 | Q 20.00
M30 | Acústico | Acústico | Manguera acústica y espuma | Manguera PVC 30 cm DI 10-12 mm; extremos sellados con espuma | Manguera PVC 30 cm DI 10-12 mm; extremos sellados con espuma | 0 | 0 | 1 | 2 | 0 | 2 | Q 18.00 | Q 36.00 | Q 36.00 | Ferretería local por confirmar | Sin cotización | Pendiente de confirmación | Sin cotización | 2026-10-13 | Reutilizar tras inspección | Alta | Provisión de planificación, no precio publicado ni disponibilidad verificada. | Estimado | Q 0.00 | Q 36.00
M31 | Mecánico | Mecánico | Nylon y resortes | Nylon monofilamento 0.4-0.6 mm, 0.5 m por canal, resorte ligero | Nylon monofilamento 0.4-0.6 mm, 0.5 m por canal, resorte ligero | 0 | 0 | 1 | 2 | 0 | 2 | Q 15.00 | Q 30.00 | Q 30.00 | Ferretería local por confirmar | Sin cotización | Pendiente de confirmación | Sin cotización | 2026-10-13 | Reutilizar tras inspección | Alta | Provisión de planificación, no precio publicado ni disponibilidad verificada. | Estimado | Q 0.00 | Q 30.00
M32 | Compartida | Compartida | Base rígida y fijaciones | Base MDF 30x20 cm, tornillos, silicón, espuma antivibración | Base MDF 30x20 cm, tornillos, silicón, espuma antivibración | 0 | 0 | 1 | 2 | 0 | 2 | Q 20.00 | Q 40.00 | Q 40.00 | Ferretería local por confirmar | Sin cotización | Pendiente de confirmación | Sin cotización | 2026-10-13 | Reutilizar tras inspección | Alta | Bases para BBB y transductores, soportes mecánicos y espuma. Separadores de las placas de interfaz se presupuestan en M40. | Estimado | Q 0.00 | Q 40.00
M33 | Compartida | Compartida | Envíos o traslado | Provisión local; sustituir por cotización final | Provisión local; sustituir por cotización final | 0 | 0 | 0.5 | 1 | 0 | 1 | Q 40.00 | Q 40.00 | Q 40.00 | Ferretería local por confirmar | Sin cotización | Pendiente de confirmación | Sin cotización | 2026-10-13 | Reutilizar tras inspección | Alta | Provisión de planificación, no precio publicado ni disponibilidad verificada. | Estimado | Q 0.00 | Q 40.00
M34 | Compartida | Alimentación BBB | Fuente cerrada para BeagleBone Black | 5 V regulados, 2 A, centro positivo | Jack 5.5x2.1 mm; comprobar polaridad | 0 | 0 | 1 | 2 | 0 | 2 | Q 60.00 | Q 120.00 | Q 120.00 | Ferretería local por confirmar | Sin cotización | Pendiente de confirmación | Sin cotización | 2026-10-13 | Reutilizar tras inspección | Alta | Provisión de Q60 por fuente, sin cotización cerrada. No se confirmó que las placas existentes incluyan fuentes. Registrar inventario para descontar. No usar fuente 9 o 12 V. | Estimado | Q 0.00 | Q 120.00
M35 | Compartida | Montaje soldado | Zócalo reemplazable para MCP | DIP28 angosto 7.62 mm | 28 PINES | 0 | 0 | 1 | 2 | 0 | 2 | Q 2.50 | Q 5.00 | Q 5.00 | Electrónica DIY | HYPERLINK is not implemented. linkLocation=https://www.electronicadiy.com/products/base-para-circuito-integrado-16-18-28-40-pines?variant=33522884575371, friendlyName=Abrir variante | Disponible y verificado | Disponible publicado; cantidad de lote por confirmar | 2026-10-15 | Reutilizar tras inspección | Alta | Uno por placa; confirmar encapsulado del MCP23017. Soldar zócalo vacío; insertar integrado tras continuidad y tensiones. | Publicado | Q 0.00 | Q 5.00
M36 | Compartida | Montaje soldado | Bornera de dos polos | Paso a verificar contra placa | 2 Pines | 0 | 0 | 6 | 12 | 0 | 12 | Q 2.00 | Q 24.00 | Q 24.00 | Electrónica DIY | HYPERLINK is not implemented. linkLocation=https://www.electronicadiy.com/products/terminal-de-bornera-de-2-y-3-pines?variant=33522943918219, friendlyName=Abrir variante | Disponible y verificado | Disponible publicado; cantidad de lote por confirmar | 2026-10-15 | Reutilizar tras inspección | Alta | 6 por nodo: entrada 5 V actuadores, reloj TX, reloj RX, LED, buzzer y switch. Confirmar paso 5.08 mm o montar en adaptador sujeto. | Publicado | Q 0.00 | Q 24.00
M37 | Compartida | Montaje soldado | Bornera de tres polos | Paso a verificar contra placa | 3 Pines | 0 | 0 | 3 | 6 | 0 | 6 | Q 3.00 | Q 18.00 | Q 18.00 | Electrónica DIY | HYPERLINK is not implemented. linkLocation=https://www.electronicadiy.com/products/terminal-de-bornera-de-2-y-3-pines?variant=33522943950987, friendlyName=Abrir variante | Disponible y verificado | Disponible publicado; cantidad de lote por confirmar | 2026-10-15 | Reutilizar tras inspección | Alta | 3 por nodo: servo, sensor óptico y sensor acústico. Rotular VCC, señal y GND según cada módulo; AO sin conectar. | Publicado | Q 0.00 | Q 18.00
M38 | Compartida | Montaje soldado | Soldadura con flux para electrónica | Tubo 18 g 60/40 de 1 mm | Variante única | 0 | 0 | 0.5 | 1 | 0 | 1 | Q 22.00 | Q 22.00 | Q 22.00 | Electrónica DIY | HYPERLINK is not implemented. linkLocation=https://www.electronicadiy.com/products/tubo-de-estano-18g-60-40-con-flux?variant=50549344141570, friendlyName=Abrir variante | Disponible y verificado | Disponible publicado; cantidad de lote por confirmar | 2026-10-15 | Reutilizar tras inspección | Alta | Tubo compartido. Ventilar, no comer en la mesa y lavarse las manos tras manipular soldadura con plomo. No usar flux ácido. | Publicado | Q 0.00 | Q 22.00
M39 | Compartida | Montaje soldado | Tira hembra para señales de BBB | 40 contactos paso 2.54 mm | Hembra / Negro | 0 | 0 | 1 | 2 | 0 | 2 | Q 3.00 | Q 6.00 | Q 6.00 | Electrónica DIY | HYPERLINK is not implemented. linkLocation=https://www.electronicadiy.com/products/pin-header-40-pines?variant=39807839666358, friendlyName=Abrir variante | Disponible y verificado | Disponible publicado; cantidad de lote por confirmar | 2026-10-15 | Reutilizar tras inspección | Alta | Una por placa; usar al menos 10 contactos rotulados para 3.3 V, GND, I2C, PWM y señales PRU. Sin insertar placa sobre BBB. | Publicado | Q 0.00 | Q 6.00
M40 | Compartida | Montaje soldado | Fijación y terminaciones de placa | Kit por nodo de separadores, tornillos, aislante y terminales | Kit por nodo de separadores, tornillos, aislante y terminales | 0 | 0 | 1 | 2 | 0 | 2 | Q 15.00 | Q 30.00 | Q 30.00 | Ferretería local por confirmar | Sin cotización | Pendiente de confirmación | Sin cotización | 2026-10-15 | Reutilizar tras inspección | Alta | Provisión sin cotizar: 4 separadores de placa, tornillos, sujeción de arnés, termorretráctil y conectores compatibles para módulos/servo. Separado de soportes de medios M32. | Estimado | Q 0.00 | Q 30.00
M41 | Compartida | Montaje soldado | Cable flexible para actuadores | 22 AWG cobre mínimo como propuesta; medir caída y corriente | 22 AWG cobre mínimo como propuesta; medir caída y corriente | 0 | 0 | 1 | 2 | 0 | 2 | Q 4.00 | Q 8.00 | Q 8.00 | Ferretería local por confirmar | Sin cotización | Pendiente de confirmación | Sin cotización | 2026-10-15 | Reutilizar tras inspección | Alta | 2 m compartidos para 5 V y GND de actuadores. Provisión por metro; recorrido corto, retorno en estrella. No usar cadenas de islas/puentes finos para corriente del servo. | Estimado | Q 0.00 | Q 8.00

Sheet: Compras prioritarias
Primera validación física
Incluir placa, zócalos y conexiones soldadas. No se ha confirmado ninguna compra.
ID | Componente | Total a conseguir | Costo compra Q | Disponibilidad | Acción antes del 16/10
M01 | BeagleBone Black existente | 0 | Q 0.00 | Existencia confirmada por usuario | Ya tienen 2 BBB; inspeccionar, no comprar
M02 | Expansor GPIO | 2 | Q 104.00 | Disponible y verificado | Confirmar lote y recoger para primera prueba
M03 | LED rojo transparente | 2 | Q 1.50 | Disponible y verificado | Confirmar lote y recoger para primera prueba
M04 | Módulo LDR digital | 2 | Q 32.00 | Disponible y verificado | Confirmar lote y recoger para primera prueba
M05 | Buzzer activo | 2 | Q 7.00 | Disponible y verificado | Confirmar lote y recoger para primera prueba
M06 | Detector de sonido | 2 | Q 38.00 | Disponible y verificado | Confirmar KY037 real y DO a 3.3 V
M07 | Servo posicional | 2 | Q 54.00 | Disponible y verificado | Exigir posicional 180 grados
M08 | Final de carrera | 2 | Q 14.00 | Disponible y verificado | Confirmar lote y recoger para primera prueba
M11 | Optoacoplador | 2 | Q 8.00 | Disponible y verificado | Confirmar lote y recoger para primera prueba
M23 | Fuente cerrada | 2 | Q 110.00 | Disponible y verificado | Confirmar lote y recoger para primera prueba
M24 | Cable USB local | 2 | Q 20.00 | Disponible y verificado | Confirmar lote y recoger para primera prueba
M28 | Breakout alimentación actuadores | 2 | Q 6.00 | Disponible y verificado | Confirmar lote y recoger para primera prueba
M29 | Tubo opaco y soportes | 2 | Q 20.00 | Pendiente de confirmación | Confirmar lote y recoger para primera prueba
M30 | Manguera acústica y espuma | 2 | Q 36.00 | Pendiente de confirmación | Confirmar lote y recoger para primera prueba
M31 | Nylon y resortes | 2 | Q 30.00 | Pendiente de confirmación | Confirmar lote y recoger para primera prueba
M34 | Fuente cerrada para BeagleBone Black | 2 | Q 120.00 | Pendiente de confirmación | Confirmar fuentes propias antes de cotizar
M25 | Placa perforada soldable | 2 | Q 30.00 | Disponible y verificado | Placa 9x15: verificar islas y espacio antes de soldar
M35 | Zócalo reemplazable para MCP | 2 | Q 5.00 | Disponible y verificado | DIP28 angosto compatible con MCP
M36 | Bornera de dos polos | 12 | Q 24.00 | Disponible y verificado | Confirmar lote y recoger para primera prueba
M37 | Bornera de tres polos | 6 | Q 18.00 | Disponible y verificado | Confirmar lote y recoger para primera prueba
M38 | Soldadura con flux para electrónica | 1 | Q 22.00 | Disponible y verificado | Confirmar lote y recoger para primera prueba
M39 | Tira hembra para señales de BBB | 2 | Q 6.00 | Disponible y verificado | Confirmar lote y recoger para primera prueba
M40 | Fijación y terminaciones de placa | 2 | Q 30.00 | Pendiente de confirmación | Confirmar lote y recoger para primera prueba
M41 | Cable flexible para actuadores | 2 | Q 8.00 | Pendiente de confirmación | Confirmar lote y recoger para primera prueba

Sheet: Comparación proveedores
Opciones comerciales contrastadas
Comparaciones previas al 13/10/2026; nuevas piezas de montaje verificadas en BOM el 15/10.
ID BOM | Modelo | Compatibilidad | Proveedor | Precio Q | Estado publicado | Enlace | Nota de disponibilidad
M07 | SG90 180 grados | Mismo mecanismo; confirmar 2 unidades | La Electrónica | Q 31.00 | Pendiente de confirmación | HYPERLINK is not implemented. linkLocation=https://laelectronica.com.gt/products/motor-servo-sg90-de-180-grados-18-kg-cm, friendlyName=Abrir ficha | Texto 231 unidades y etiqueta Agotado contradictoria; confirmar
M06 | LM393-M 5V | Requiere adaptación de nivel; no conexión directa a 3.3V | Electrónica Alpha | Q 25.00 | Disponible y verificado | HYPERLINK is not implemented. linkLocation=https://electronicaalpha.com/sensores/sensores-de-sonido/modulo-sensor-de-sonido-lm393/, friendlyName=Abrir ficha | 85 unidades publicadas; 5 V no compatible directo
M05 | Módulo buzzer activo | Confirmar polaridad entrada y 3.3V de control | Electrónica DIY | Q 12.00 | Disponible y verificado | HYPERLINK is not implemented. linkLocation=https://www.electronicadiy.com/products/modulo-buzzer, friendlyName=Abrir ficha | Cantidad no publicada
M02 | Waveshare MCP23017 paquete 2 | Importación; no depender de plazo para 17/10 | Kemik | Q 297.00 | Disponible y verificado | HYPERLINK is not implemented. linkLocation=https://www.kemik.gt/placa-de-expansion-io-waveshare-mcp23017-interfaz-i2c-expande-16-pines-i_o-compatible-con-niveles-de-3_3v-5v-paquete-de-2-2_0mm-paquete-d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 friendlyName=Abrir ficha | Pedido internacional; plazo sin confirmar
M02 | MCP23017 módulo | Agotado; referencia únicamente | Kemik | Q 106.00 | Agotado | HYPERLINK is not implemented. linkLocation=https://www.kemik.gt/modulo-ic-expansor-de-e_s-i2c-de-16-bits-mcp23017, friendlyName=Abrir ficha | Pedido internacional; plazo sin confirmar
M07 | MG90S 180 grados | Más caro; misma validación de carrera/corriente | Electrónica DIY | Q 50.00 | Disponible y verificado | HYPERLINK is not implemented. linkLocation=https://www.electronicadiy.com/products/micro-servo-mg90s, friendlyName=Abrir ficha | Cantidad no publicada

Sheet: Alternativas y repuestos
Respaldo antes de sustituir piezas
Los repuestos no están incluidos en el presupuesto base; exigir equivalencia técnica.
Repuesto | Cantidad sugerida | Precio unitario Q | Provisión Q | Cuándo utilizar | Condición
SG90 posicional | 1 | Q 27.00 | Q 27.00 | Fallo mecánico | Confirmar mismo recorrido; no incluido en base
MCP23017 | 1 | Q 52.00 | Q 52.00 | Fallo de expander | Sin sobretensión ni corto persistente antes de reemplazar
LED rojo | 2 | Q 0.75 | Q 1.50 | Óptica | Misma polaridad y corriente limitada
PC817 | 2 | Q 4.00 | Q 8.00 | Reloj | Verificar CTR y pinout
Módulo buzzer activo | 2 | Q 12.00 | Q 24.00 | Buzzer sin ficha eléctrica | Revisar alimentación y señal, sustituye M05
MG90S 180 grados | 2 | Q 50.00 | Q 100.00 | No hay SG90 | Recalibrar fuerza, recorrido y consumo

Sheet: Materiales disponibles
Inventario confirmado por el equipo
2 BBB confirmadas por el usuario. Existencia confirmada no significa inspección eléctrica aprobada.
ID BOM | Material | Cantidad confirmada | Unidad | Quién confirma | Fecha | Estado de inspección | Observaciones
M01 | BeagleBone Black existente | 2 | unidades | Usuario | 2026-10-13 | Existencia confirmada | Dos BeagleBone Black declaradas. Pendientes revisión, arranque, Debian y fuentes.
M02 | Expansor GPIO | 0 | unidades |  |  | Sin verificar
M03 | LED rojo transparente | 0 | unidades |  |  | Sin verificar
M04 | Módulo LDR digital | 0 | unidades |  |  | Sin verificar
M05 | Buzzer activo | 0 | unidades |  |  | Sin verificar
M06 | Detector de sonido | 0 | unidades |  |  | Sin verificar
M07 | Servo posicional | 0 | unidades |  |  | Sin verificar
M08 | Final de carrera | 0 | unidades |  |  | Sin verificar
M09 | Transistor NPN | 0 | unidades |  |  | Sin verificar
M10 | Transistor de señal | 0 | unidades |  |  | Sin verificar
M11 | Optoacoplador | 0 | unidades |  |  | Sin verificar
M12 | Diodo rueda libre | 0 | unidades |  |  | Sin verificar
M13 | Resistencia 1/4W | 0 | unidades |  |  | Sin verificar
M14 | Resistencia 1/4W | 0 | unidades |  |  | Sin verificar
M15 | Resistencia 1/4W | 0 | unidades |  |  | Sin verificar
M16 | Resistencia 1/4W | 0 | unidades |  |  | Sin verificar
M17 | Resistencia 1/4W | 0 | unidades |  |  | Sin verificar
M18 | Resistencia 1/4W | 0 | unidades |  |  | Sin verificar
M19 | Capacitor cerámico | 0 | unidades |  |  | Sin verificar
M20 | Capacitor electrolítico | 0 | unidades |  |  | Sin verificar
M21 | Fusible | 0 | unidades |  |  | Sin verificar
M22 | Portafusible | 0 | unidades |  |  | Sin verificar
M23 | Fuente cerrada | 0 | unidades |  |  | Sin verificar
M24 | Cable USB local | 0 | unidades |  |  | Sin verificar
M25 | Placa perforada soldable | 0 | unidades |  |  | Sin verificar
M26 | Jumpers internos | 0 | kits |  |  | Sin verificar
M27 | Alambre interno | 0 | metros |  |  | Sin verificar
M28 | Breakout alimentación actuadores | 0 | unidades |  |  | Sin verificar
M29 | Tubo opaco y soportes | 0 | unidades |  |  | Sin verificar
M30 | Manguera acústica y espuma | 0 | unidades |  |  | Sin verificar
M31 | Nylon y resortes | 0 | unidades |  |  | Sin verificar
M32 | Base rígida y fijaciones | 0 | unidades |  |  | Sin verificar
M33 | Envíos o traslado | 0 | unidades |  |  | Sin verificar
M34 | Fuente cerrada para BeagleBone Black | 0 | unidades |  |  | Sin verificar
M35 | Zócalo reemplazable para MCP | 0 | unidades |  |  | Sin verificar
M36 | Bornera de dos polos | 0 | unidades |  |  | Sin verificar
M37 | Bornera de tres polos | 0 | unidades |  |  | Sin verificar
M38 | Soldadura con flux para electrónica | 0 | unidades |  |  | Sin verificar
M39 | Tira hembra para señales de BBB | 0 | unidades |  |  | Sin verificar
M40 | Fijación y terminaciones de placa | 0 | unidades |  |  | Sin verificar
M41 | Cable flexible para actuadores | 0 | metros |  |  | Sin verificar

Sheet: Conciliacion T03
Inventario T03 — 08/11/2026
Pedido consultado: Q309.50. Recepción del pedido confirmada; conteo y otras compras pendientes. Blancos = desconocido.
Las otras hojas conservan el presupuesto histórico; no representan el inventario conciliado.
Fuente: pedido Electrónica DIY consultado; BOM histórica; disponibilidad declarada en T02. Sin datos privados.
ID | Modelo previsto | Plan | Pedido consultado | Recibido del pedido | Verificado del pedido | Reuso confirmado | Otras compras | Brecha provisional | Precio histórico Q | Gasto pedido Q | Estimado brecha Q | Observación
M01 | BeagleBone Black AM335x | 2 | 0 |  |  | 2 |  | 0 | Q 0.00 | Q 0.00 | Q 0.00 | Reutilización declarada en T02
M02 | MCP23017 DIP28 | 2 | 2 | 2 |  | 0 |  | 0 | Q 52.00 | Q 104.00 | Q 0.00 | Recibido declarado; revisar conteo/variante
M03 | LED 5 mm rojo | 2 | 2 | 2 |  | 0 |  | 0 | Q 0.75 | Q 1.50 | Q 0.00 | Recibido declarado; revisar conteo/variante
M04 | D6 LDR LM393 | 2 | 2 | 2 |  | 0 |  | 0 | Q 16.00 | Q 32.00 | Q 0.00 | Recibido declarado; revisar conteo/variante
M05 | Buzzer activo 2 terminales | 2 | 2 | 2 |  | 0 |  | 0 | Q 3.50 | Q 7.00 | Q 0.00 | Recibido declarado; revisar conteo/variante
M06 | KY037 SKU D14 | 2 | 2 | 2 |  | 0 |  | 0 | Q 19.00 | Q 38.00 | Q 0.00 | Título KY-037; enlace KY-038. Revisar lote
M07 | SG90 180 grados | 2 | 2 | 2 |  | 0 |  | 0 | Q 27.00 | Q 54.00 | Q 0.00 | Recibido declarado; revisar conteo/variante
M08 | SPDT con rueda | 2 | 2 | 2 |  | 0 |  | 0 | Q 7.00 | Q 14.00 | Q 0.00 | Recibido declarado; revisar conteo/variante
M09 | 2N2222 | 4 | 4 | 4 |  | 0 |  | 0 | Q 0.75 | Q 3.00 | Q 0.00 | Recibido declarado; revisar conteo/variante
M10 | 2N3904 | 2 | 2 | 2 |  | 0 |  | 0 | Q 0.75 | Q 1.50 | Q 0.00 | Recibido declarado; revisar conteo/variante
M11 | PC817 DIP4 | 2 | 2 | 2 |  | 0 |  | 0 | Q 4.00 | Q 8.00 | Q 0.00 | Recibido declarado; revisar conteo/variante
M12 | 1N4148 | 2 | 2 | 2 |  | 0 |  | 0 | Q 0.75 | Q 1.50 | Q 0.00 | Recibido declarado; revisar conteo/variante
M13 | 330 ohm | 2 | 2 | 2 |  | 0 |  | 0 | Q 0.50 | Q 1.00 | Q 0.00 | Recibido declarado; revisar conteo/variante
M14 | 390 ohm | 2 | 2 | 2 |  | 0 |  | 0 | Q 0.50 | Q 1.00 | Q 0.00 | Recibido declarado; revisar conteo/variante
M15 | 100 ohm | 2 | 2 | 2 |  | 0 |  | 0 | Q 0.50 | Q 1.00 | Q 0.00 | Recibido declarado; revisar conteo/variante
M16 | 1K ohm | 12 | 9 | 9 |  | 0 |  | 3 | Q 0.50 | Q 4.50 | Q 1.50 | Recibido declarado; revisar conteo/variante
M17 | 4.7K ohm | 10 | 10 | 10 |  | 0 |  | 0 | Q 0.50 | Q 5.00 | Q 0.00 | Recibido declarado; revisar conteo/variante
M18 | 10K ohm | 10 | 8 | 8 |  | 0 |  | 2 | Q 0.50 | Q 4.00 | Q 1.00 | Recibido declarado; revisar conteo/variante
M19 | 100 nF | 8 | 8 | 8 |  | 0 |  | 0 | Q 0.75 | Q 6.00 | Q 0.00 | Recibido declarado; revisar conteo/variante
M20 | 1000uF 16V | 2 | 2 | 2 |  | 0 |  | 0 | Q 3.50 | Q 7.00 | Q 0.00 | Recibido declarado; revisar conteo/variante
M21 | 5x20mm 1A | 2 | 2 | 2 |  | 0 |  | 0 | Q 0.75 | Q 1.50 | Q 0.00 | Recibido declarado; revisar conteo/variante
M22 | 5x20mm con cable | 2 | 2 | 2 |  | 0 |  | 0 | Q 4.00 | Q 8.00 | Q 0.00 | Recibido declarado; revisar conteo/variante
M23 | 5V 2.5A | 2 | 0 |  |  | 0 |  | 2 | Q 55.00 | Q 0.00 | Q 110.00 | Consultar compras externas
M24 | USB A a Mini USB B de datos | 2 | 0 |  |  | 2 |  | 0 | Q 10.00 | Q 0.00 | Q 0.00 | Reutilización declarada en T02
M25 | Una cara 9x15 cm | 2 | 0 |  |  | 0 |  | 2 | Q 15.00 | Q 0.00 | Q 30.00 | Consultar compras externas
M26 | Kit 65 | 1 | 0 |  |  | 0 |  | 1 | Q 32.00 | Q 0.00 | Q 32.00 | Consultar compras externas
M27 | 22 AWG unifilar | 4 | 0 |  |  | 0 |  | 4 | Q 2.25 | Q 0.00 | Q 9.00 | Consultar compras externas
M28 | Micro USB hembra a DIP2.54 | 2 | 2 | 2 |  | 0 |  | 0 | Q 3.00 | Q 6.00 | Q 0.00 | Recibido declarado; revisar conteo/variante
M29 | Tubo cartón/PVC 30 cm, interior negro; sin fibra comercial | 2 | 0 |  |  | 0 |  | 2 | Q 10.00 | Q 0.00 | Q 20.00 | Compra externa confirmada; cantidad pendiente
M30 | Manguera PVC 30 cm DI 10-12 mm; extremos sellados con espuma | 2 | 0 |  |  | 0 |  | 2 | Q 18.00 | Q 0.00 | Q 36.00 | Compra externa confirmada; cantidad pendiente
M31 | Nylon monofilamento 0.4-0.6 mm, 0.5 m por canal, resorte ligero | 2 | 0 |  |  | 0 |  | 2 | Q 15.00 | Q 0.00 | Q 30.00 | Compra externa confirmada; cantidad pendiente
M32 | Base MDF 30x20 cm, tornillos, silicón, espuma antivibración | 2 | 0 |  |  | 0 |  | 2 | Q 20.00 | Q 0.00 | Q 40.00 | Consultar compras externas
M33 | Provisión local; sustituir por cotización final | 1 | 0 |  |  | 0 |  | 1 | Q 40.00 | Q 0.00 | Q 40.00 | Consultar compras externas
M34 | 5 V regulados, 2 A, centro positivo | 2 | 0 |  |  | 0 |  | 2 | Q 60.00 | Q 0.00 | Q 120.00 | Consultar compras externas
M35 | DIP28 angosto 7.62 mm | 2 | 0 |  |  | 0 |  | 2 | Q 2.50 | Q 0.00 | Q 5.00 | Compra externa confirmada; cantidad pendiente
M36 | Paso a verificar contra placa | 12 | 0 |  |  | 0 |  | 12 | Q 2.00 | Q 0.00 | Q 24.00 | Consultar compras externas
M37 | Paso a verificar contra placa | 6 | 0 |  |  | 0 |  | 6 | Q 3.00 | Q 0.00 | Q 18.00 | Consultar compras externas
M38 | Tubo 18 g 60/40 de 1 mm | 1 | 0 |  |  | 0 |  | 1 | Q 22.00 | Q 0.00 | Q 22.00 | Hay estaño; cantidad/composición pendientes
M39 | 40 contactos paso 2.54 mm | 2 | 0 |  |  | 0 |  | 2 | Q 3.00 | Q 0.00 | Q 6.00 | Consultar compras externas
M40 | Kit por nodo de separadores, tornillos, aislante y terminales | 2 | 0 |  |  | 0 |  | 2 | Q 15.00 | Q 0.00 | Q 30.00 | Consultar compras externas
M41 | 22 AWG cobre mínimo como propuesta; medir caída y corriente | 2 | 0 |  |  | 0 |  | 2 | Q 4.00 | Q 0.00 | Q 8.00 | Consultar compras externas
Totales Q |  |  |  |  |  |  |  |  |  | Q 309.50 | Q 582.50
Brecha descuenta pedido y reuso, no disponibilidad física. Otras compras vacías aún no se descuentan.
No comprar automáticamente. Gasto de otras compras y pendiente definitivo siguen sin confirmar.
M29/M30/M31/M35 comprados aparte: no recomprar hasta completar cantidades y precios.
