bitvalo34/trama3-ccviii/hardware/diseno-placas/cad/placa-A/TRAMA3_Interfaz_A.step

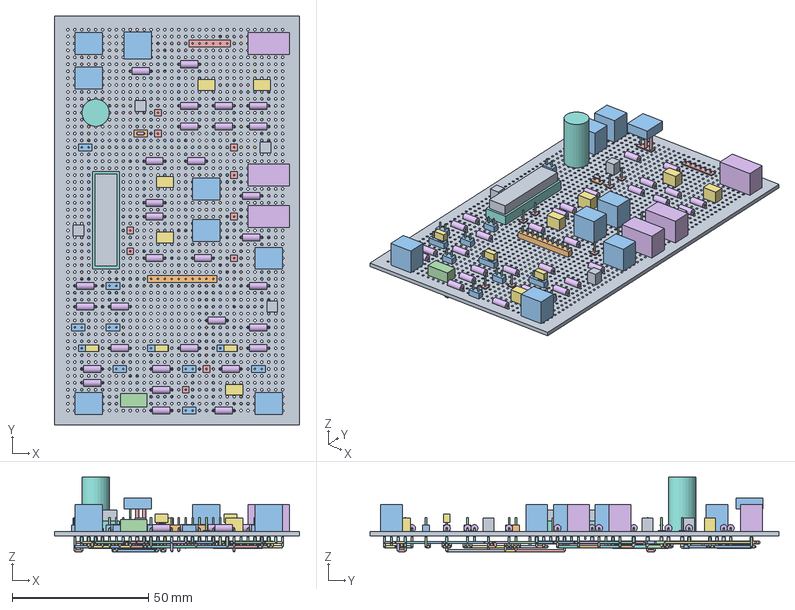
[picture p14: CAD file, 2026-11-09]
hardware/diseno-placas/cad/placa-A/TRAMA3_Interfaz_A.step
90.0 x 150.0 x 27.4 mm
