bitvalo34/trama3-ccviii/(list of files, cad)

Other CAD files:
hardware/diseno-placas/cad/placa-B/TRAMA3_Interfaz_B.step
hardware/diseno-placas/cad/placa-A/TRAMA3_Interfaz_A.FCStd
hardware/diseno-placas/cad/placa-B/TRAMA3_Interfaz_B.FCStd
