bitvalo34/trama3-ccviii/hardware/diseno-placas/verificaciones/revision-final.md

# Revisión de entrega T51-P1

9 de noviembre de 2026. Revisión documental y automática del autor; no constituye la revisión independiente de Adrián.

| Comprobación | Resultado y alcance |
|---|---|
| Referencia funcional | Revisión 102 conservada; no cambia el protocolo ni su simulador |
| Modelo por nodo | 79 referencias, 200 terminales ocupados, 134 cables inferiores, 47 redes |
| Geometría nominal | 90×150×1.6 mm; 1,792 perforaciones; sin conflictos detectados por el comprobador geométrico |
| Conectividad | Exportación XML de KiCad coincide con el manifiesto utilizado por CAD y tablas |
| KiCad ERC | Cero infracciones; símbolos documentales, varias terminales pasivas; no acredita voltajes, fusible ni comportamiento analógico |
| Cableado | Tres alturas; sin intersección entre aislamientos de redes distintas bajo el modelo; holgura mínima calculada 0.27 mm |
| Selectores | 216 lecturas DC resistivas calculadas; cero fallos. Incluye todas las máscaras EN y puentes retirados |
| CAD | 306 sólidos por nodo; sin formas inválidas informadas por FreeCAD |
| Revisión visual | Inspección de vistas CAD, planos y dossier renderizado; orientación inferior reflejada y tablas legibles. Esquema separado en siete hojas funcionales más índice |
| Pruebas físicas | Ninguna: no se conectó ni energizó hardware durante esta tarea |

Los cuerpos simplificados, radios de doblado, acceso real del cautín y soldaduras deben comprobarse sobre las piezas. El margen geométrico de 0.27 mm no es una tolerancia de fabricación garantizada. R2/R3 se muestran como reserva DNP. Las rutas propuestas requieren cable con el diámetro exterior indicado.

Pendientes para T07/T08/T52: retícula real de la placa; pasos y orientación de conectores; pinout de transistores y módulos; funcionamiento de sensores a 3.3 V; corriente del servo y buzzer; selección del fusible, PMOS/adaptador y DPDT; prueba de PWM/I2C; tiempos del PC817; revisión cruzada de cada isla, retorno, puente y arnés por Adrián.

Estado: **paquete T51 preparado para revisión; T52 pendiente; no autorizado para soldar**. El tracker permanece sin cambios. Las simulaciones de este paquete son de circuitos selectores y comprobaciones de conectividad/geometría; no simulan motores, sensores reales ni el protocolo completo.
