bitvalo34/trama3-ccviii/software/simulador/evidencias/pruebas_motor.txt

✔ 16 pares de frecuencias y cuatro CRC con mensajes simultáneos (466.2182ms)
✔ ACK lento respeta el período del retorno, sin timeout prematuro (7.5225ms)
✔ Bajada de A conserva la velocidad de B y la identidad del pendiente (11.6616ms)
✔ Asimetría, cortes parciales y control corrupto no duplican entrega (76.8374ms)
✔ Negociación de B, pérdidas de gestión y parámetros inválidos (15.3597ms)
✔ 64 combinaciones independientes de medios de ida y de vuelta, desde HELLO (371.5725ms)
✔ Los seis cortes parciales antes y durante DATA en ambos sentidos; bloqueo fijo alto o bajo (188.0487ms)
✔ Recuperación temporal y escalonada sin mezclar copias ni entregar bytes dos veces (7.5417ms)
✔ Pérdida total temporal vuelve si se recupera dentro de los intentos; permanente es acotada (8.5246ms)
✔ Retorno perdido después de END: emisor incierto, receptor entrega exactamente una vez (5.2983ms)
✔ Bajada en pleno mensaje, sin resetear intentos, con tráfico inverso (36.4486ms)
✔ Cabecera, reloj, READY, ACK de otro SID/SEQ, ACK final y sensores (21.5521ms)
✔ Versión, perfil rechazado y reinicio con nueva sesión sin reenvío implícito (6.3909ms)
✔ Todos los mapas y reportes: control de 17 bits, CRC y versiones (2.6386ms)
✔ Los cuatro CRC y 256 bytes llegan en 18/27/54 pulsos sin prefijo (200.5472ms)
✔ RX aprende el mapa del reloj y retiene muestras previas a recibirlo (0.337ms)
✔ Pulsos dudosos, CRC de reloj, inicio, relleno, faltantes y extras se rechazan (4.2696ms)
✔ Tolerancia del pulso y del período en los extremos (0.5113ms)
✔ Al recuperarse el reloj se busca un inicio tras guarda; no se empalman intentos (0.2189ms)
✔ Cada error PWM inyectado produce recuperación sin doble entrega (33.9392ms)
✔ Tres medios cortados impiden entregar texto aunque el control de reloj llegue (1.0199ms)
✔ Variar el ancho no cambia el período ni agrega los antiguos ciclos de prefijo (4.8832ms)
✔ Umbral virtual del opto y jitter controlados; nunca declara éxito con control inválido (14.1339ms)
✔ Cuatro CRC contra vectores de referencia, incluido AUTOSAR oficial (0.9957ms)
✔ 256 bytes × 4 CRC: 54 bits, 18 tripletas, campos cruzados y todo error simple del cuerpo (32.5365ms)
✔ SYN/SFD dañados y reloj ausente se rechazan antes del CRC (0.1894ms)
✔ UTF-8 de 1,2,3,4 bytes y CP1252 estricta (0.6281ms)
✔ Fragmentos de período completos, duplicados y q inválido (0.2589ms)
✔ Limpio bidireccional con todos los CRC y codificaciones (69.9124ms)
✔ Bit alterado provoca CRC → NACK → reintento → ACK sin duplicados (2.6269ms)
✔ ACK perdido: timeout y deduplicación sin duplicar bytes ni mensaje (9.3538ms)
✔ Reloj perdido: error explícito y recuperación por timeout (3.5966ms)
✔ Bloqueo de nylon en DATA cambia a luz y sonido y entrega una sola vez (4.6259ms)
✔ Cambio previo al mensaje: 1→4 Hz, todos los CRC y pérdidas de gestión (125.1595ms)
✔ Nylon tardío se excluye a 4 Hz por su cabecera ilegible (7.1713ms)
✔ SEQ da vuelta sin confundir bytes repetidos con duplicados (63.663ms)
✔ Modelo reproducible, validaciones de entrada y límite de mensaje (8.717ms)
✔ HTML autónomo carga y sus controles recorren el ensayo (21.5084ms)
✔ Interfaz aplica fallos, valida codificación y presenta texto como texto (85.8899ms)
✔ HTML sin dependencias externas y scripts con sintaxis válida (0.4185ms)
✔ Selector de cortes y salto al cambio enseñan la línea superviviente (27.7285ms)
✔ Comparador reproduce el límite hipotético de las tres líneas (77.3745ms)
ℹ tests 42
ℹ suites 0
ℹ pass 42
ℹ fail 0
ℹ cancelled 0
ℹ skipped 0
ℹ todo 0
ℹ duration_ms 735.2577
