bitvalo34/trama3-ccviii/hardware/diseno-placas/verificaciones/selectores-DC.csv

puentes_retirados | mask | raw | canal | V_GPIO | V_esperado | pasa
False | 000 | 000 | 0 | 0.0 | 0 | True
False | 000 | 000 | 1 | 0.0 | 0 | True
False | 000 | 000 | 2 | 0.0 | 0 | True
False | 000 | 001 | 0 | 0.0 | 0 | True
False | 000 | 001 | 1 | 0.0 | 0 | True
False | 000 | 001 | 2 | 0.0 | 0 | True
False | 000 | 010 | 0 | 0.0 | 0 | True
False | 000 | 010 | 1 | 0.0 | 0 | True
False | 000 | 010 | 2 | 0.0 | 0 | True
False | 000 | 011 | 0 | 0.0 | 0 | True
False | 000 | 011 | 1 | 0.0 | 0 | True
False | 000 | 011 | 2 | 0.0 | 0 | True
False | 000 | 100 | 0 | 0.0 | 0 | True
False | 000 | 100 | 1 | 0.0 | 0 | True
False | 000 | 100 | 2 | 0.0 | 0 | True
False | 000 | 101 | 0 | 0.0 | 0 | True
False | 000 | 101 | 1 | 0.0 | 0 | True
False | 000 | 101 | 2 | 0.0 | 0 | True
False | 000 | 110 | 0 | 0.0 | 0 | True
False | 000 | 110 | 1 | 0.0 | 0 | True
False | 000 | 110 | 2 | 0.0 | 0 | True
False | 000 | 111 | 0 | 0.0 | 0 | True
False | 000 | 111 | 1 | 0.0 | 0 | True
False | 000 | 111 | 2 | 0.0 | 0 | True
False | 001 | 000 | 0 | 0.0 | 0 | True
False | 001 | 000 | 1 | 0.0 | 0 | True
False | 001 | 000 | 2 | 0.0 | 0 | True
False | 001 | 001 | 0 | 3.3 | 3.3 | True
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
