bitvalo34/trama3-ccviii/hardware/diseno-placas/esquematicos/TRAMA3_T51_Esquematico.pdf

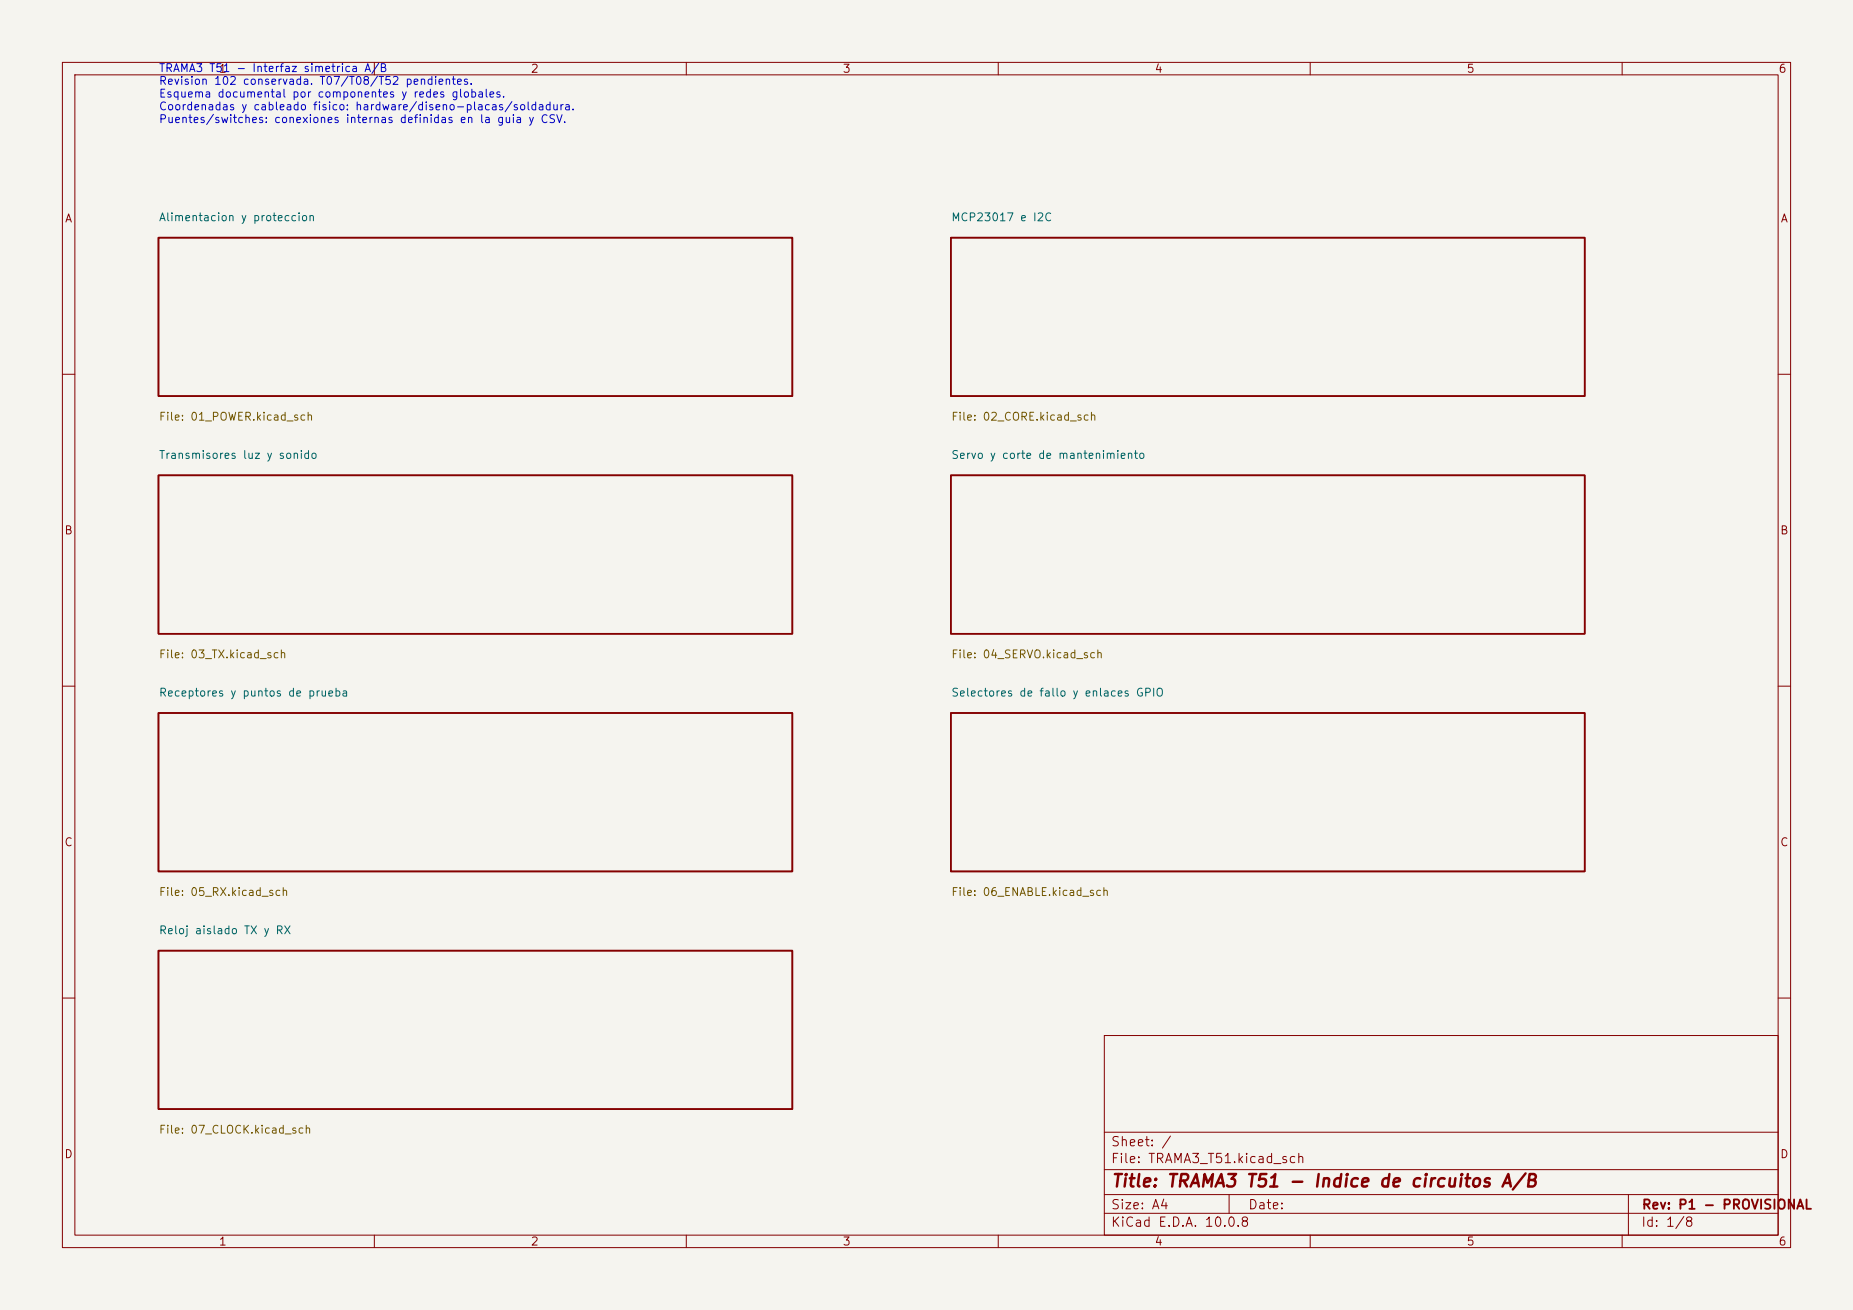
[picture p26: page 1]

TRAMA3 T51 - Interfaz simetrica A/B
Revision 102 conservada. T07/T08/T52 pendientes.
Esquema documental por componentes y redes globales. Coordenadas y cableado fisico: hardware/diseno-placas/soldadura.

Puentes/switches: conexiones internas definidas en la guia y CSV.

Receptores y puntos de prueba

File: 06_ENABLE.kicad_sch Reloj aislado TX y RX

Sheet: /
File: TRAMA3_T51.kicad_sch
Title: TRAMA3 T51 - Indice de circuitos A/B

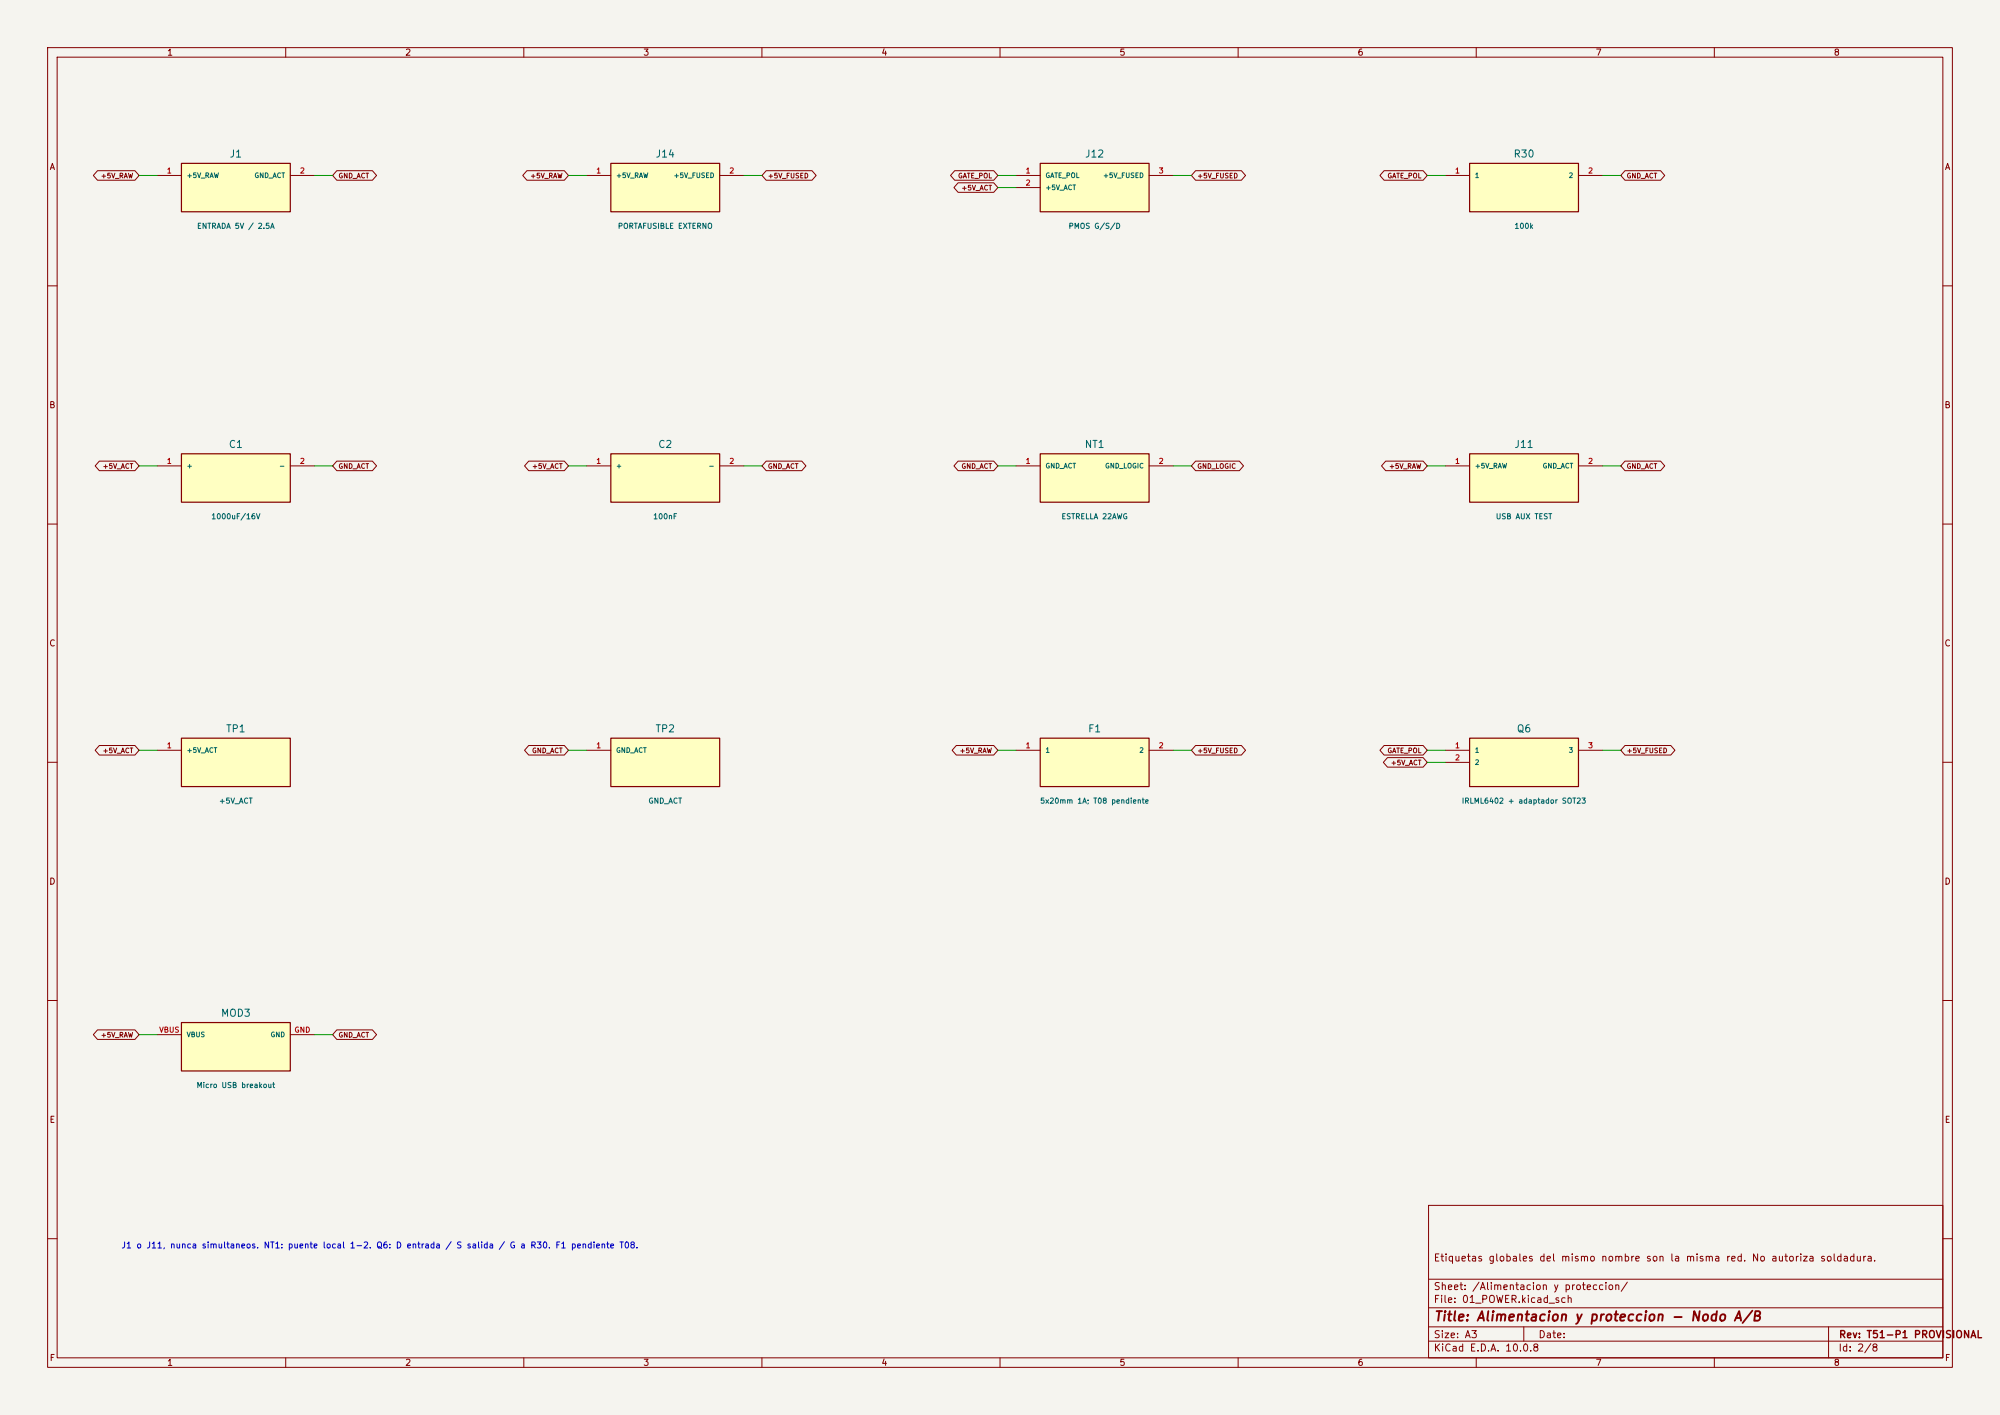
[picture p27: page 2]

J1 o J11, nunca simultaneos. NT1: puente local 1-2. Q6: D entrada / S salida / G a R30. F1 pendiente T08.

Etiquetas globales del mismo nombre son la misma red. No autoriza soldadura.

Sheet: /Alimentacion y proteccion/
File: 01_POWER.kicad_sch
Title: Alimentacion y proteccion - Nodo A/B

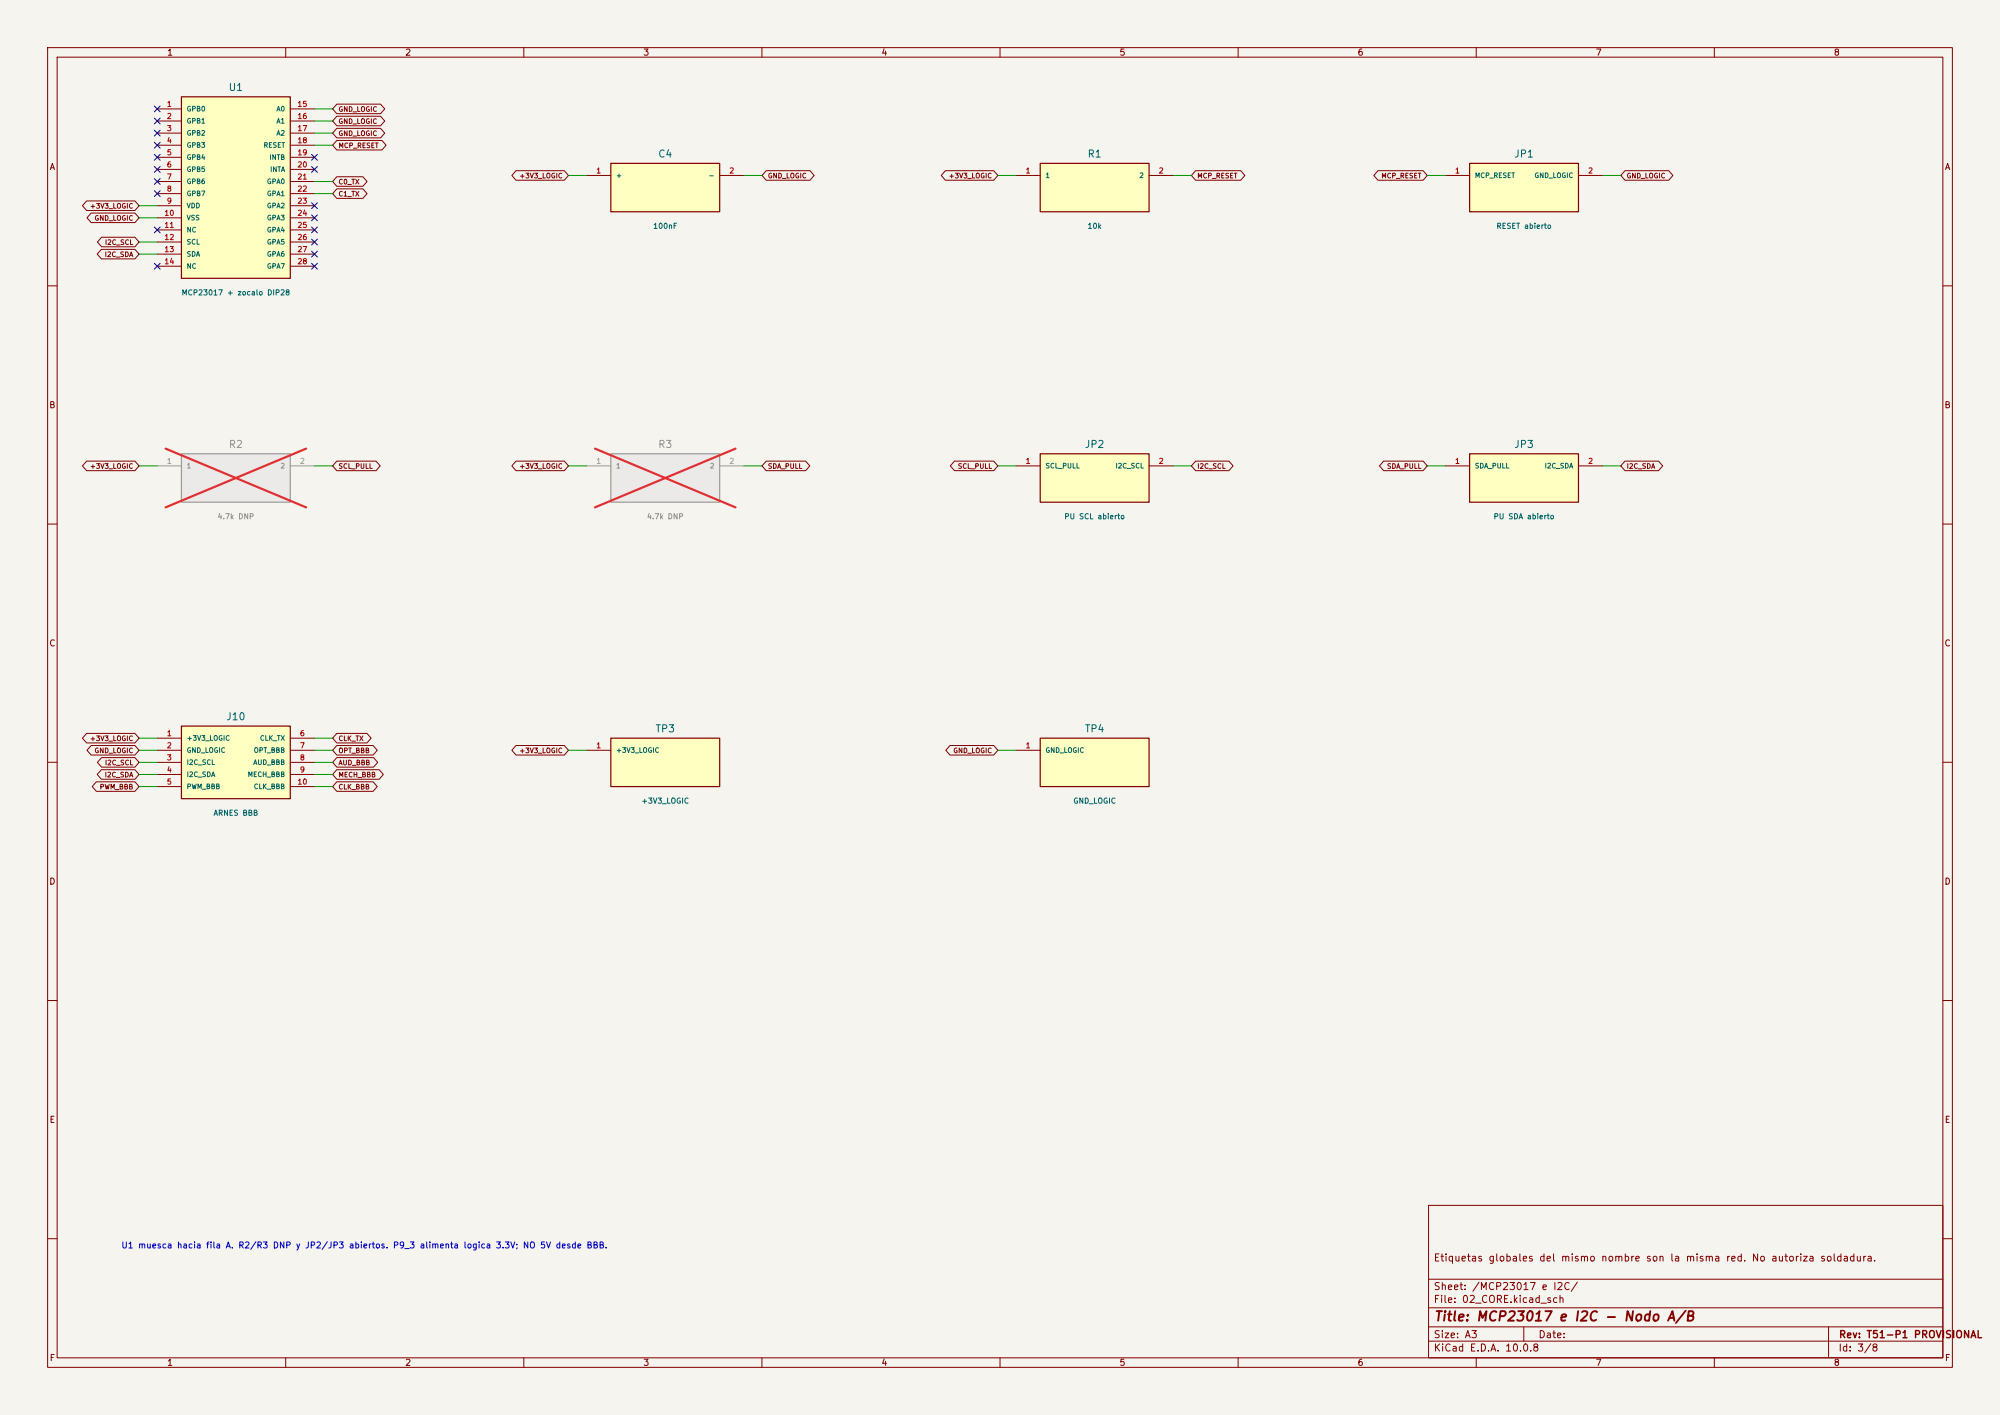
[picture p28: page 3]

U1 muesca hacia fila A. R2/R3 DNP y JP2/JP3 abiertos. P9_3 alimenta logica 3.3V; NO 5V desde BBB.

Etiquetas globales del mismo nombre son la misma red. No autoriza soldadura.

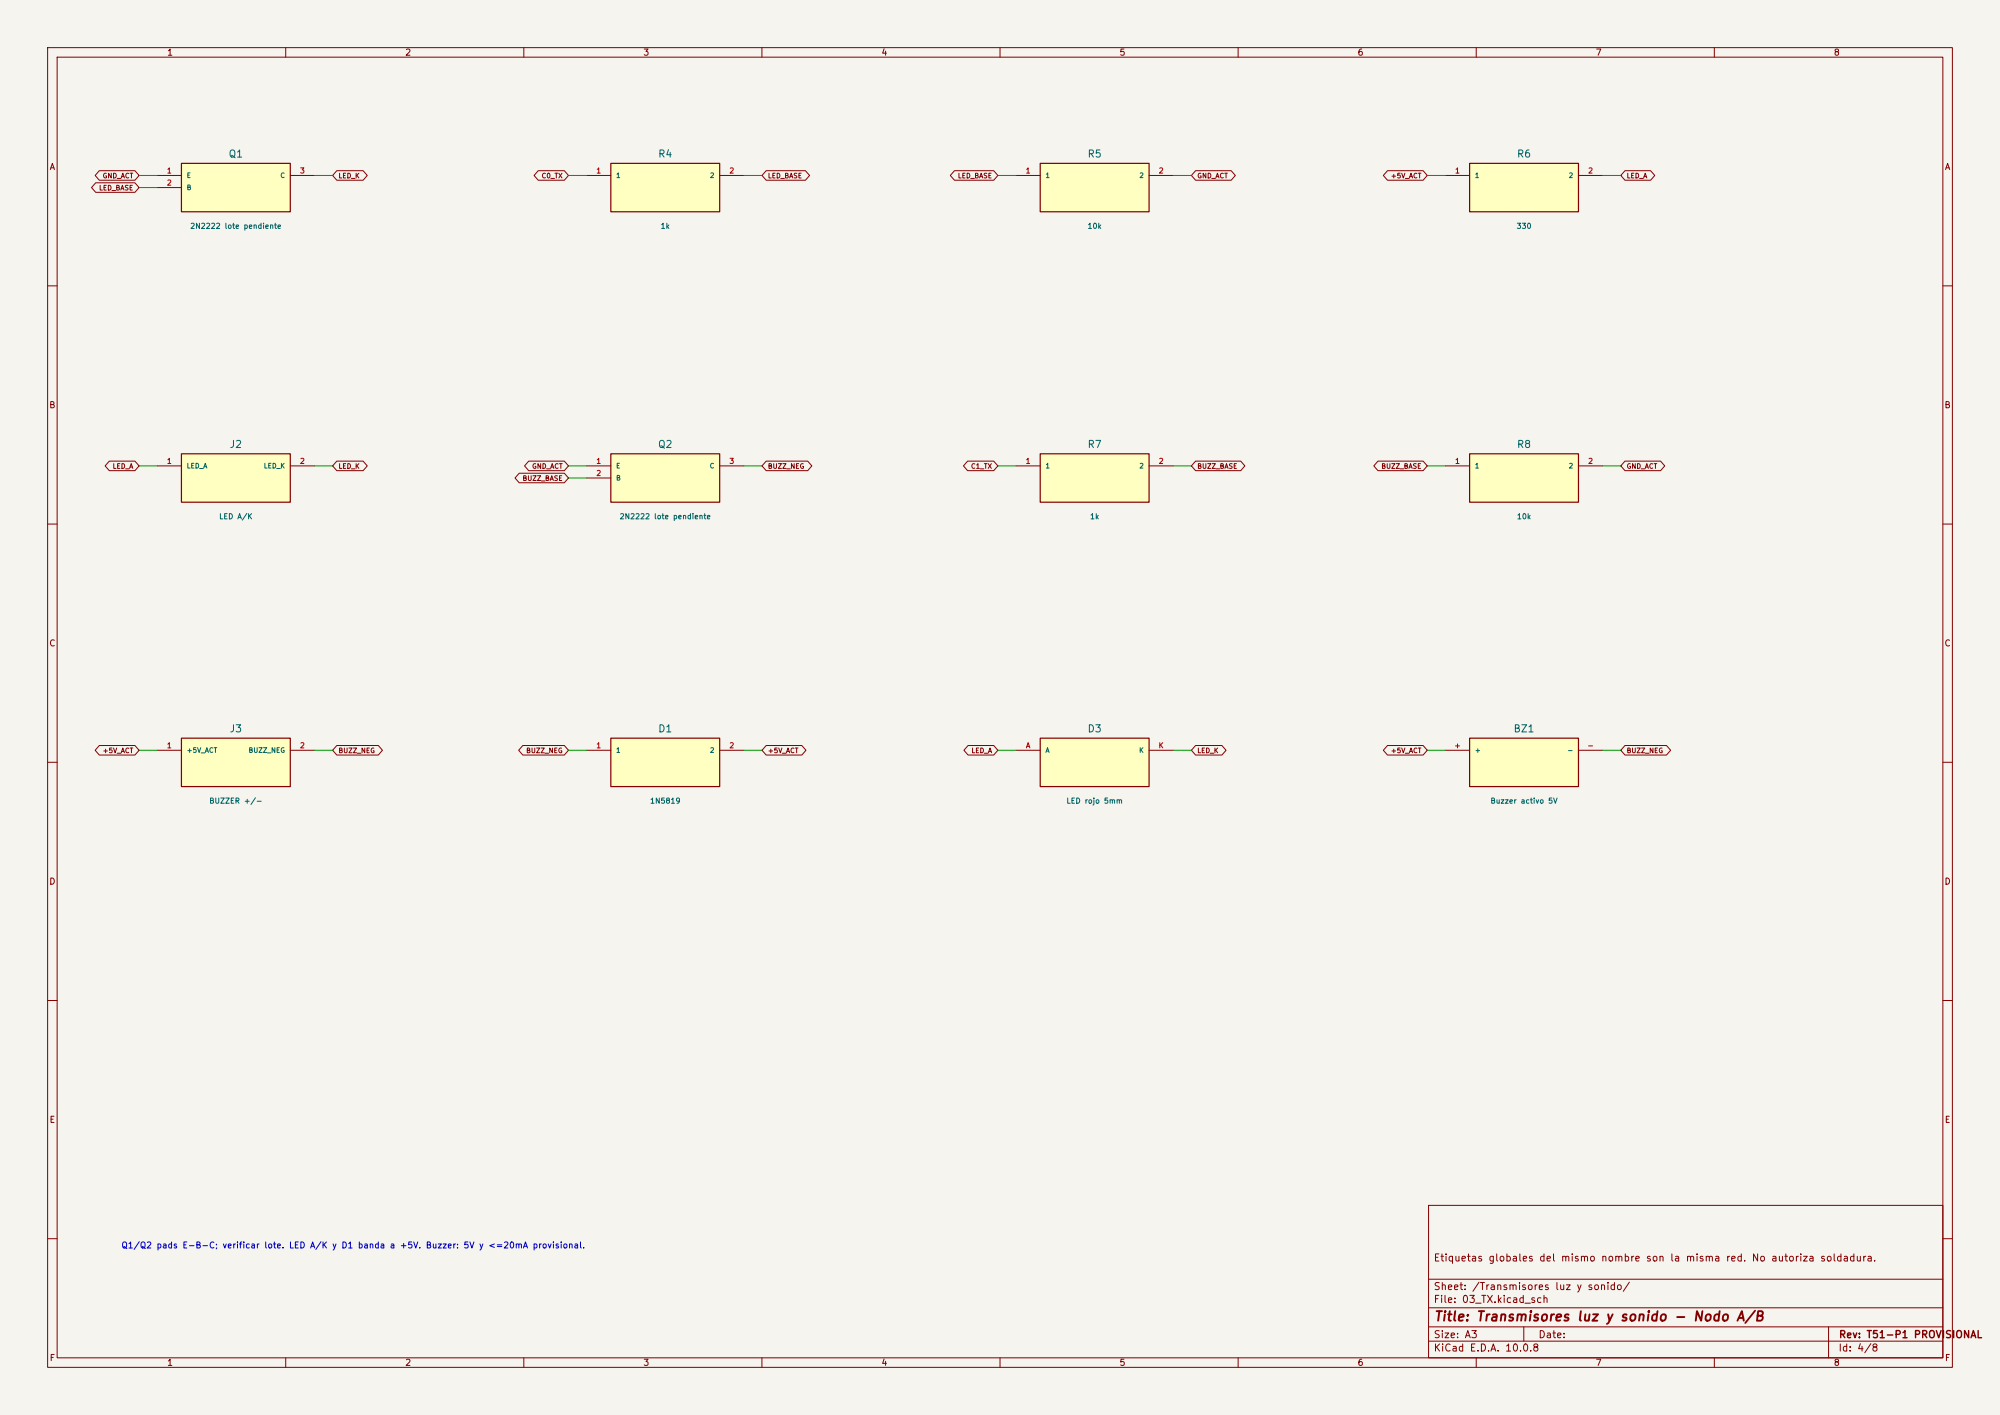
[picture p29: page 4]

Q1/Q2 pads E-B-C; verificar lote. LED A/K y D1 banda a +5V. Buzzer: 5V y <=20mA provisional.

Etiquetas globales del mismo nombre son la misma red. No autoriza soldadura.

Sheet: /Transmisores luz y sonido/
File: 03_TX.kicad_sch
Title: Transmisores luz y sonido - Nodo A/B

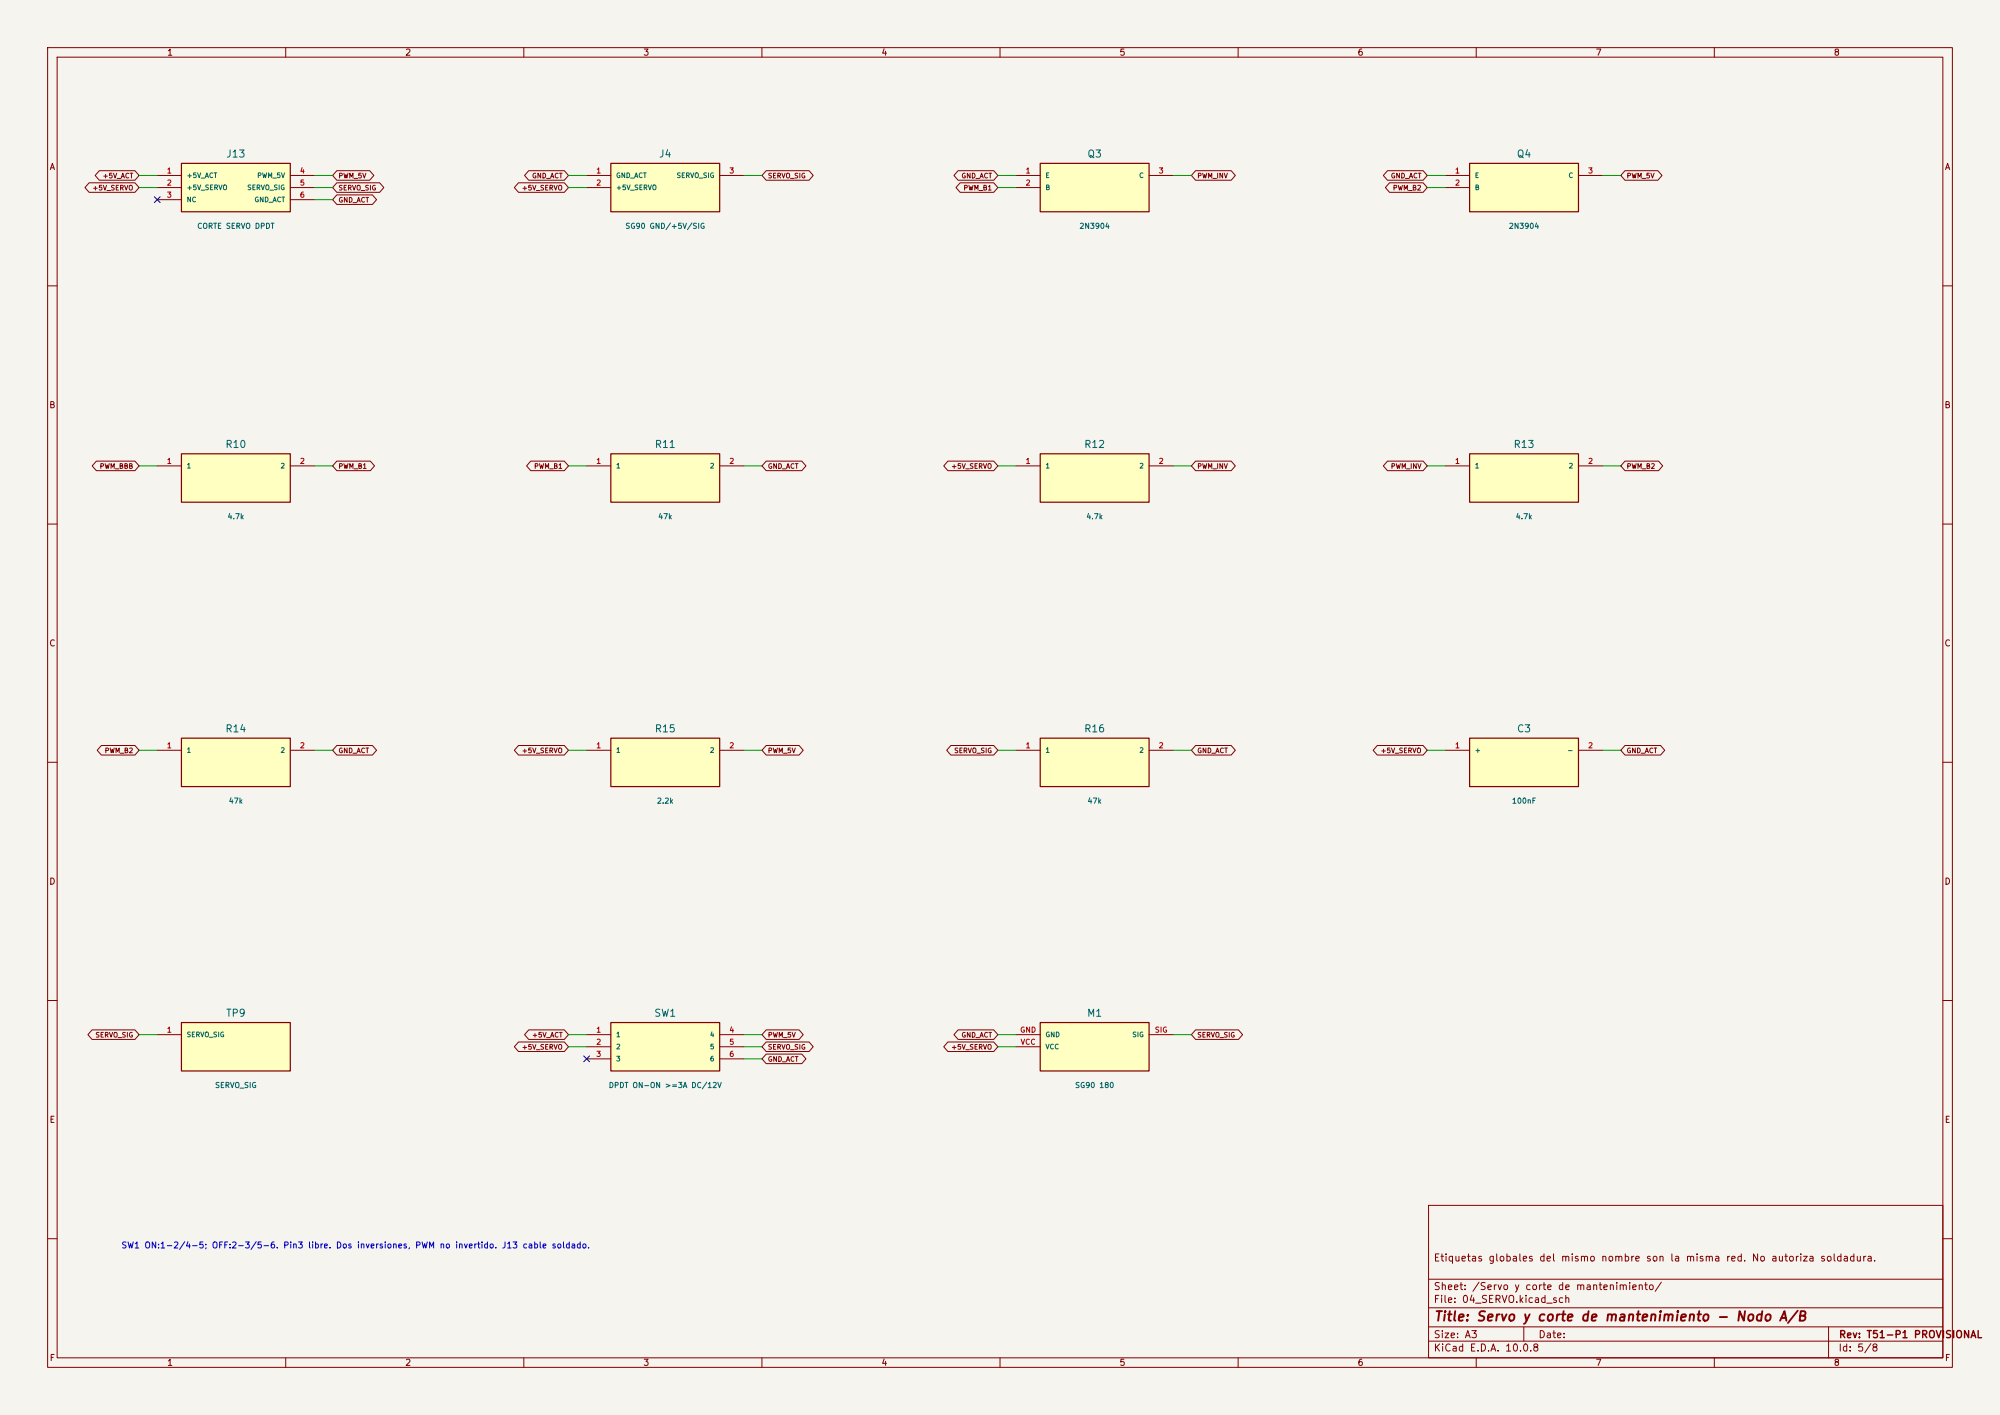
[picture p30: page 5]

DPDT ON-ON >=3A DC/12V

SW1 ON:1-2/4-5; OFF:2-3/5-6. Pin3 libre. Dos inversiones, PWM no invertido. J13 cable soldado.

Etiquetas globales del mismo nombre son la misma red. No autoriza soldadura.

Sheet: /Servo y corte de mantenimiento/
File: 04_SERVO.kicad_sch
Title: Servo y corte de mantenimiento - Nodo A/B

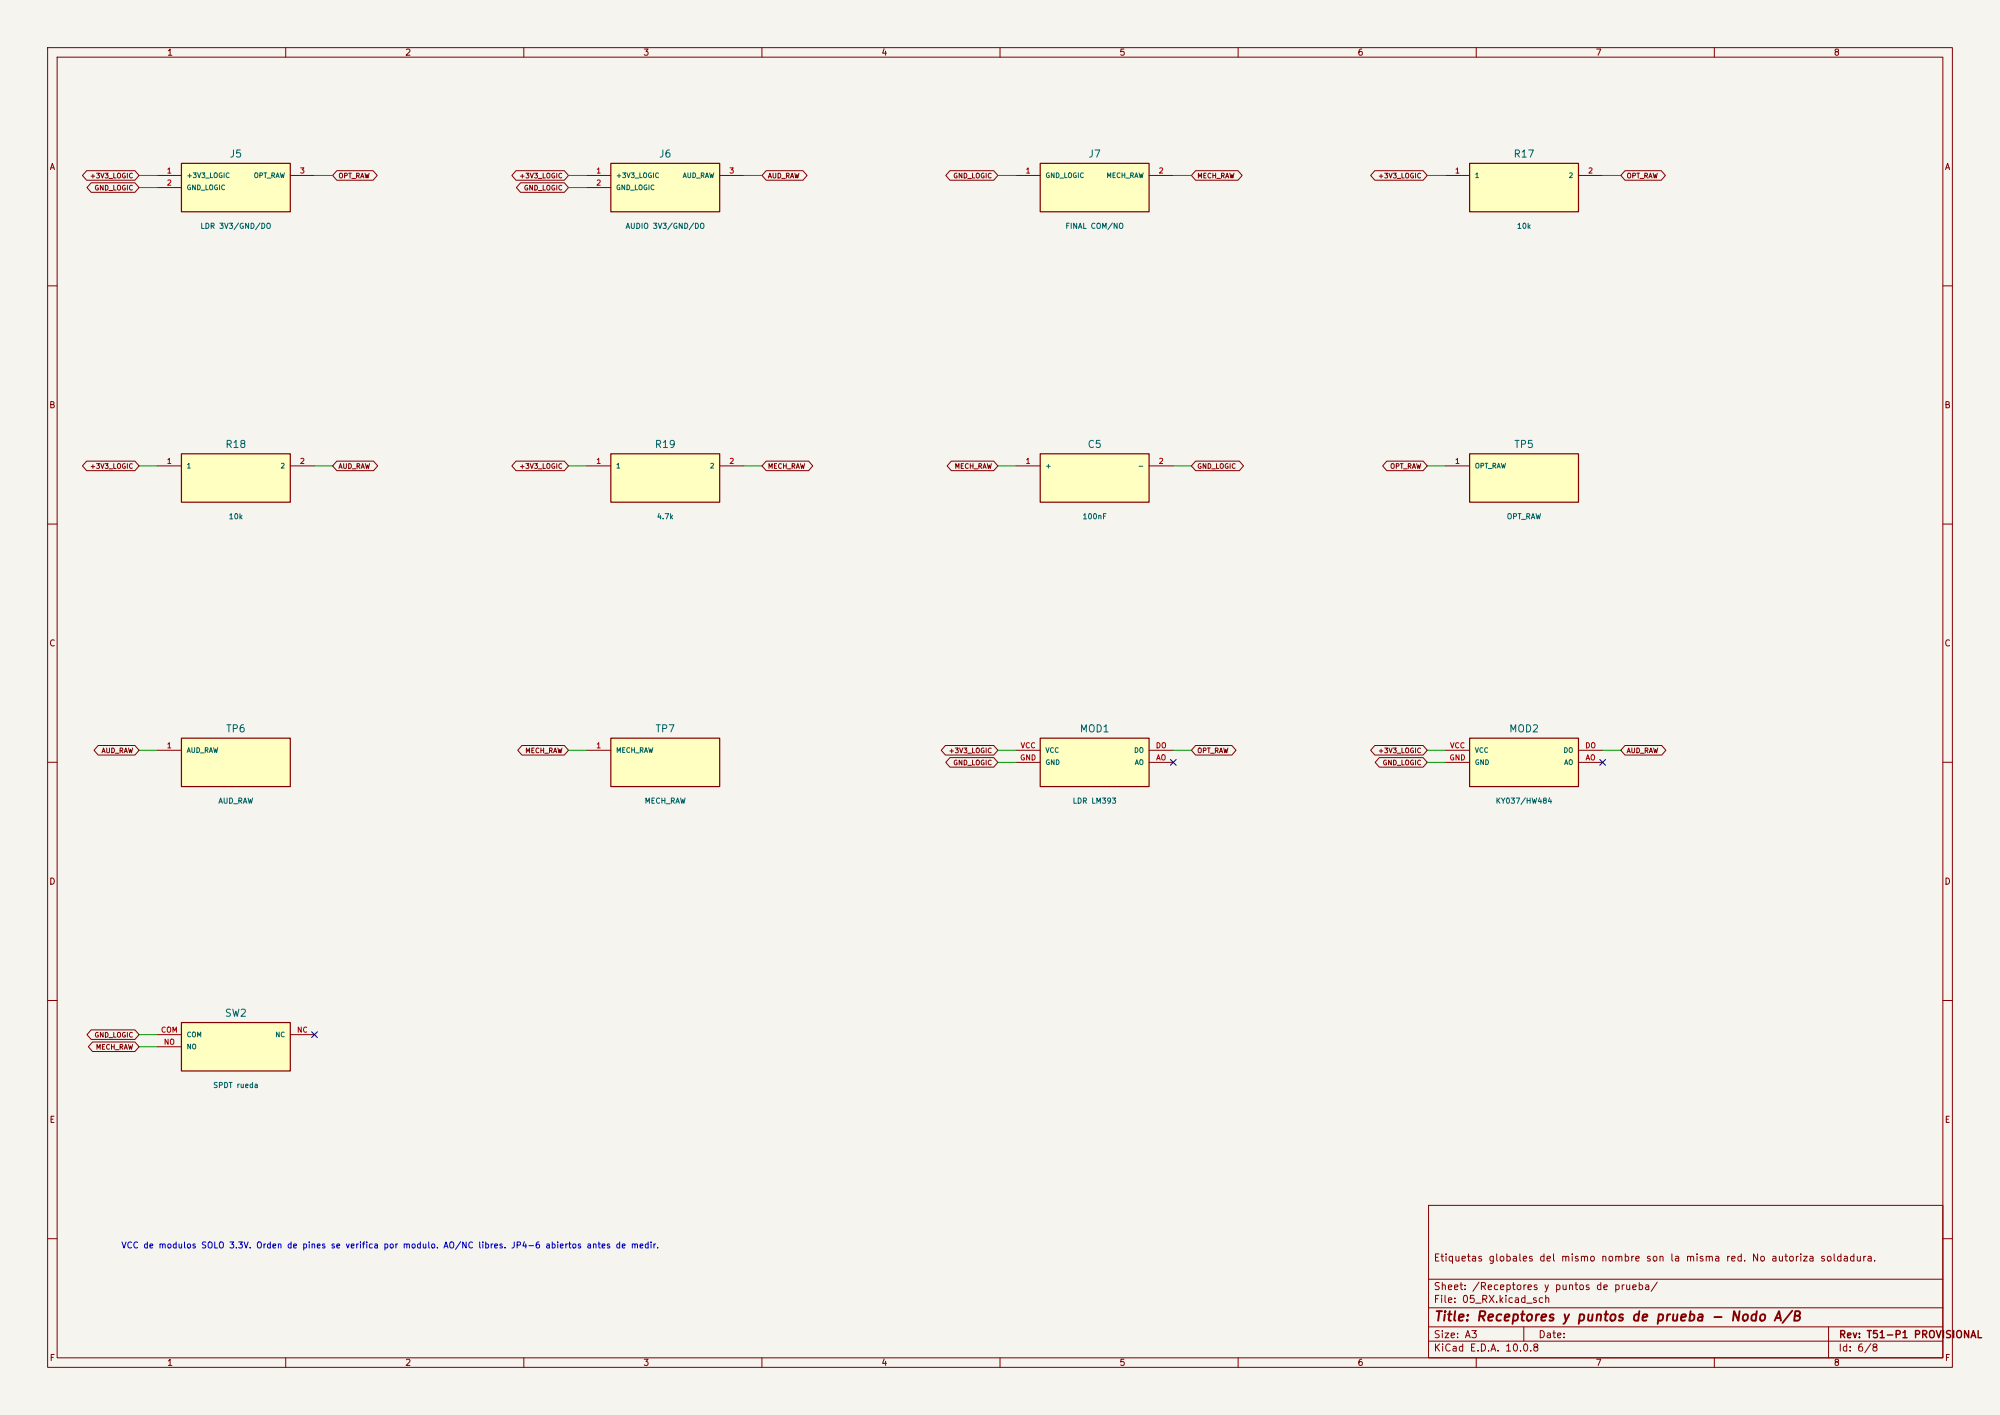
[picture p31: page 6]

VCC de modulos SOLO 3.3V. Orden de pines se verifica por modulo. AO/NC libres. JP4-6 abiertos antes de medir.

Etiquetas globales del mismo nombre son la misma red. No autoriza soldadura.

Sheet: /Receptores y puntos de prueba/
File: 05_RX.kicad_sch
Title: Receptores y puntos de prueba - Nodo A/B

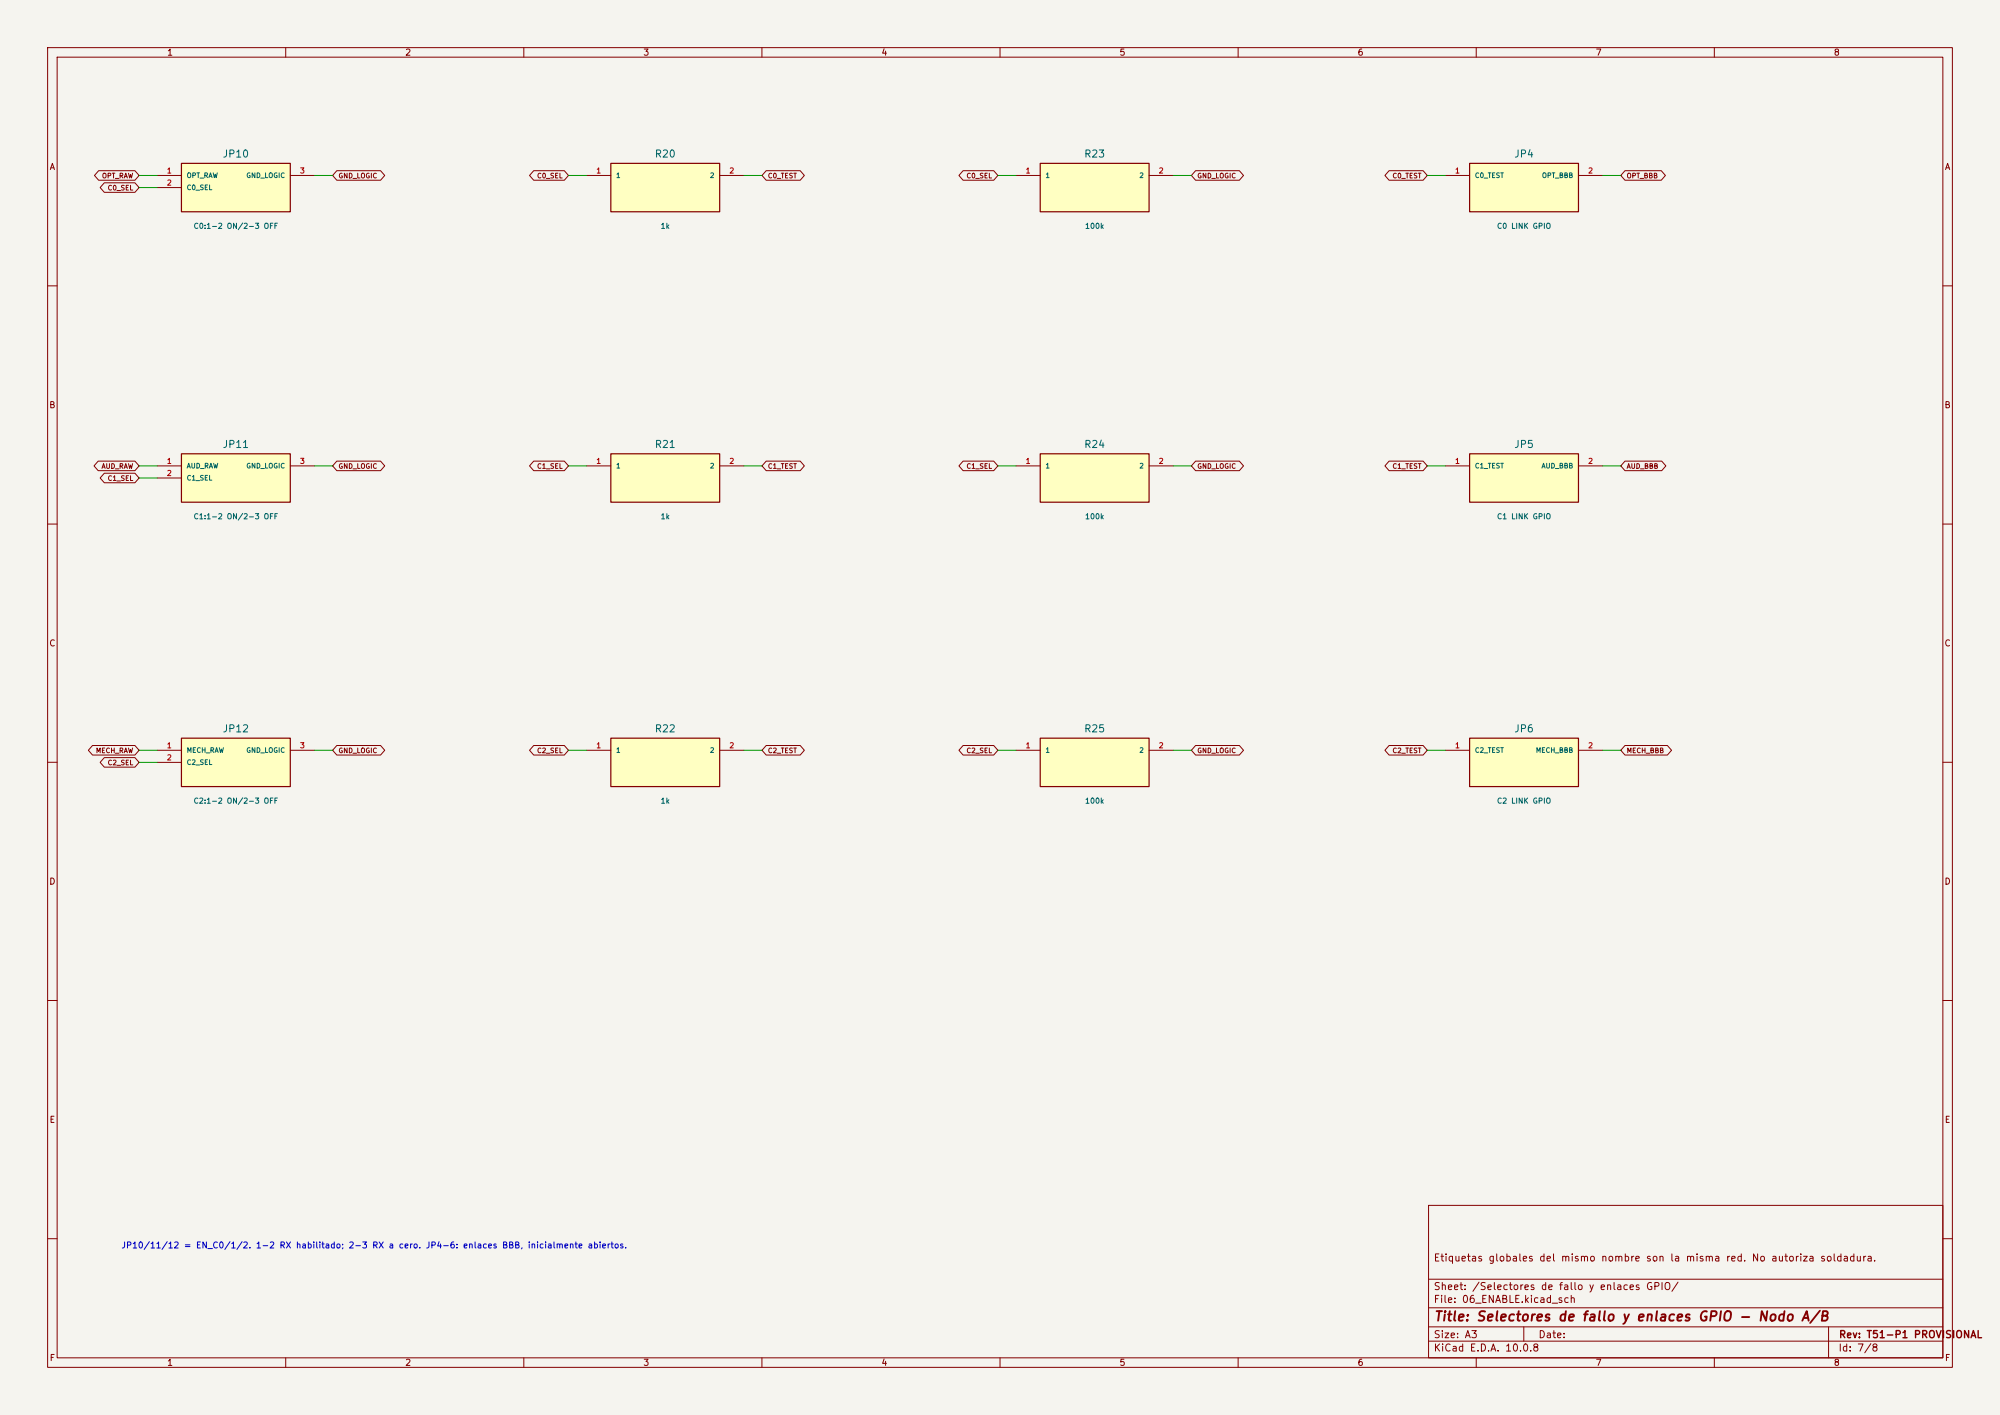
[picture p32: page 7]

JP10/11/12 = EN_C0/1/2. 1-2 RX habilitado; 2-3 RX a cero. JP4-6: enlaces BBB, inicialmente abiertos.

Etiquetas globales del mismo nombre son la misma red. No autoriza soldadura.

Sheet: /Selectores de fallo y enlaces GPIO/
File: 06_ENABLE.kicad_sch
Title: Selectores de fallo y enlaces GPIO - Nodo A/B

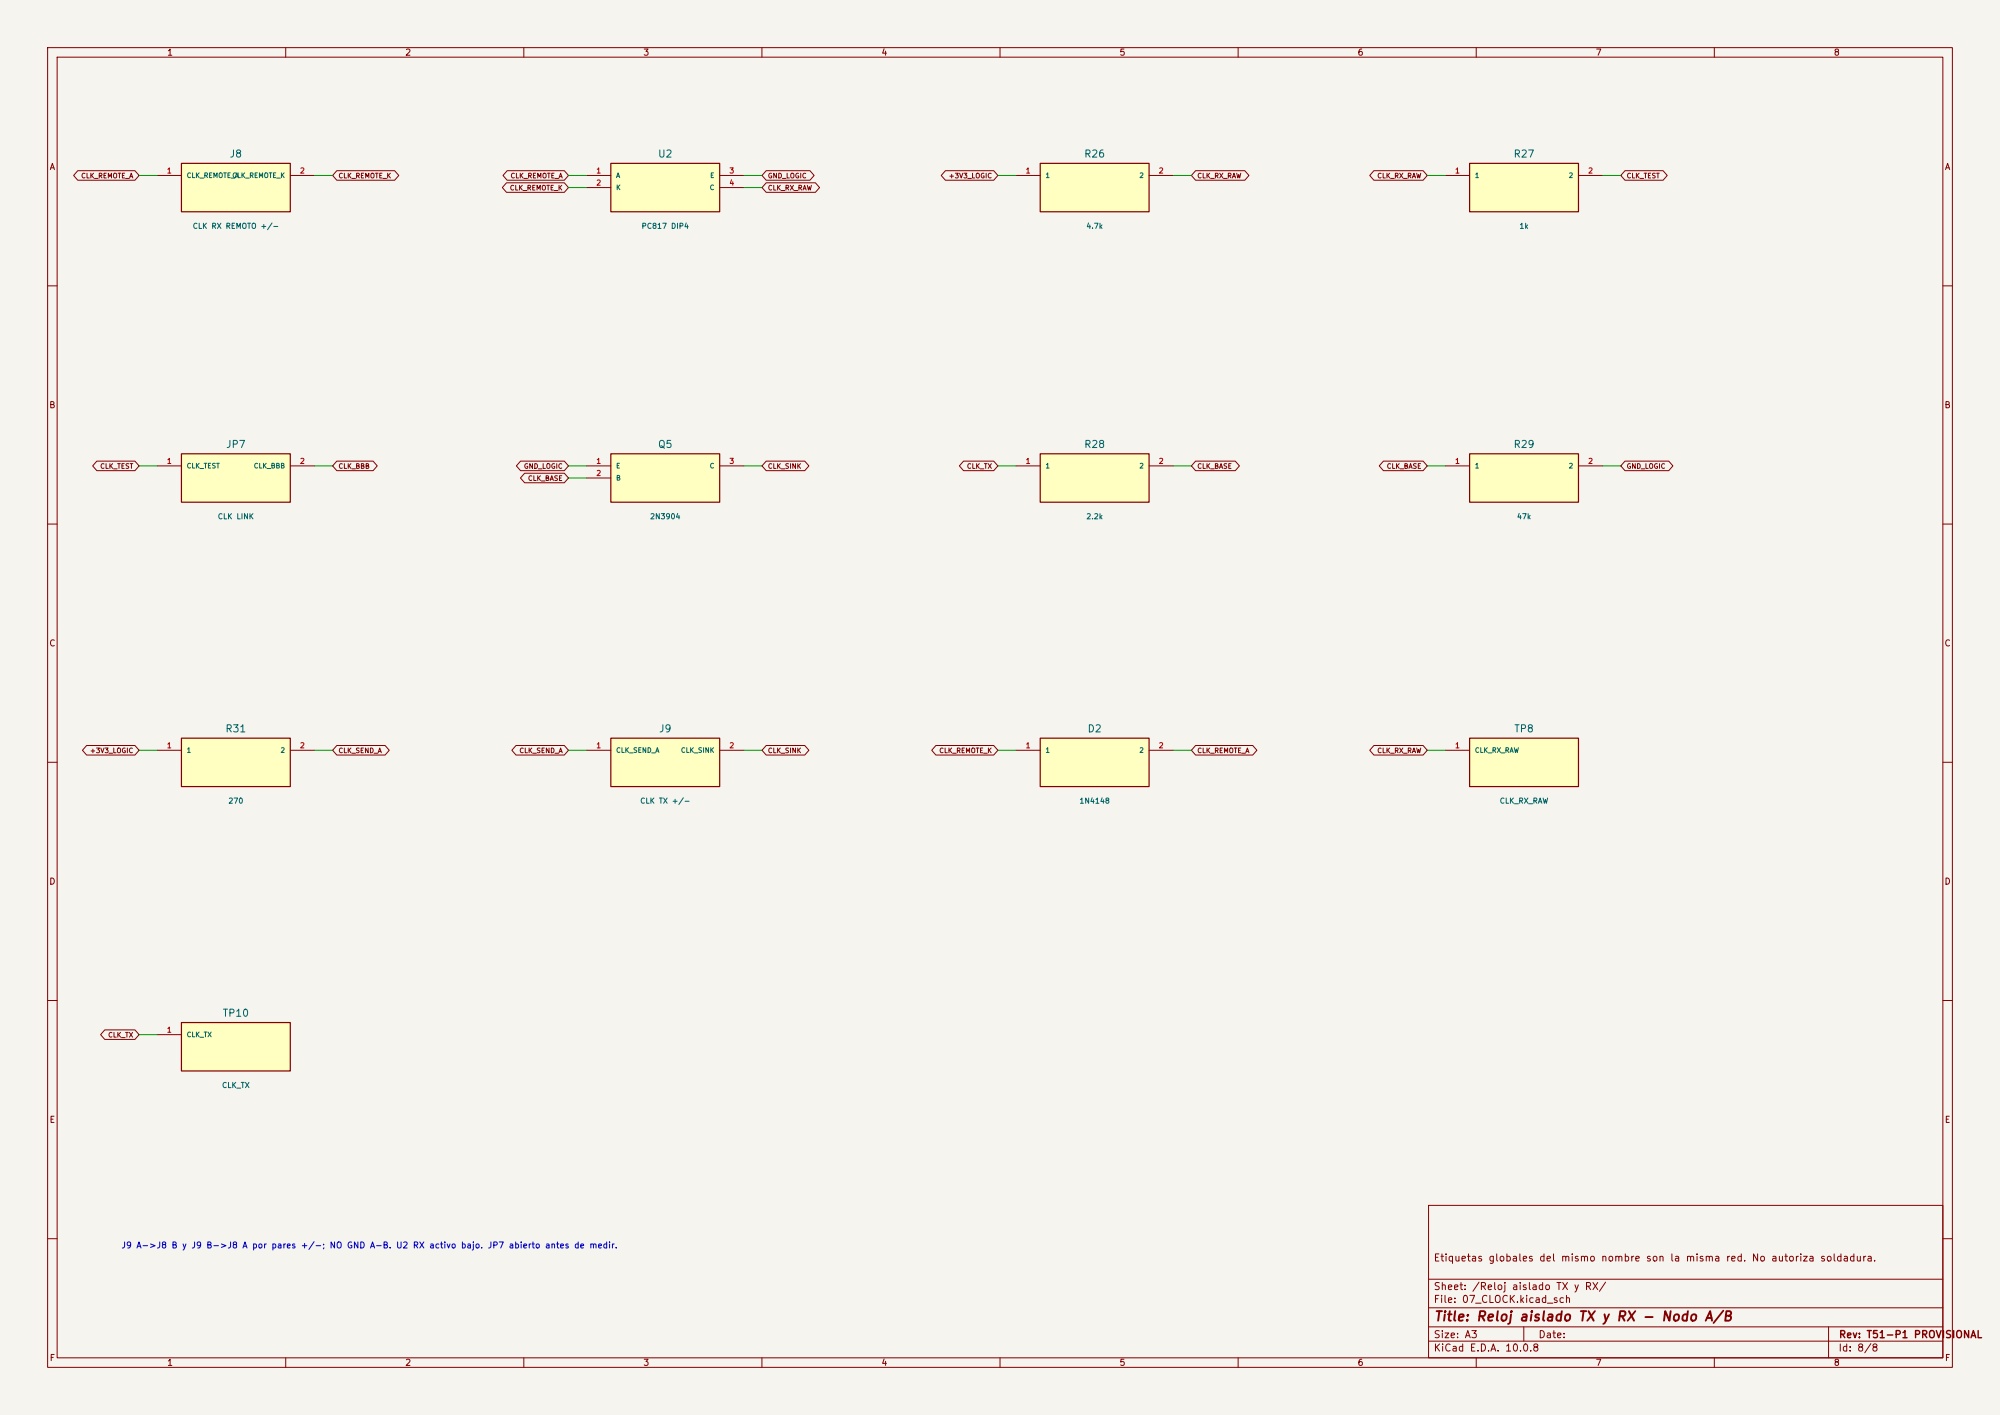
[picture p33: page 8]

J9 A->J8 B y J9 B->J8 A por pares +/-; NO GND A-B. U2 RX activo bajo. JP7 abierto antes de medir.

Etiquetas globales del mismo nombre son la misma red. No autoriza soldadura.

Sheet: /Reloj aislado TX y RX/
File: 07_CLOCK.kicad_sch
Title: Reloj aislado TX y RX - Nodo A/B
