bitvalo34/trama3-ccviii/hardware/diseno-placas/esquematicos/01_POWER.kicad_sch

## KiCad design hardware/diseno-placas/esquematicos/01_POWER.kicad_sch (2026-11-09)

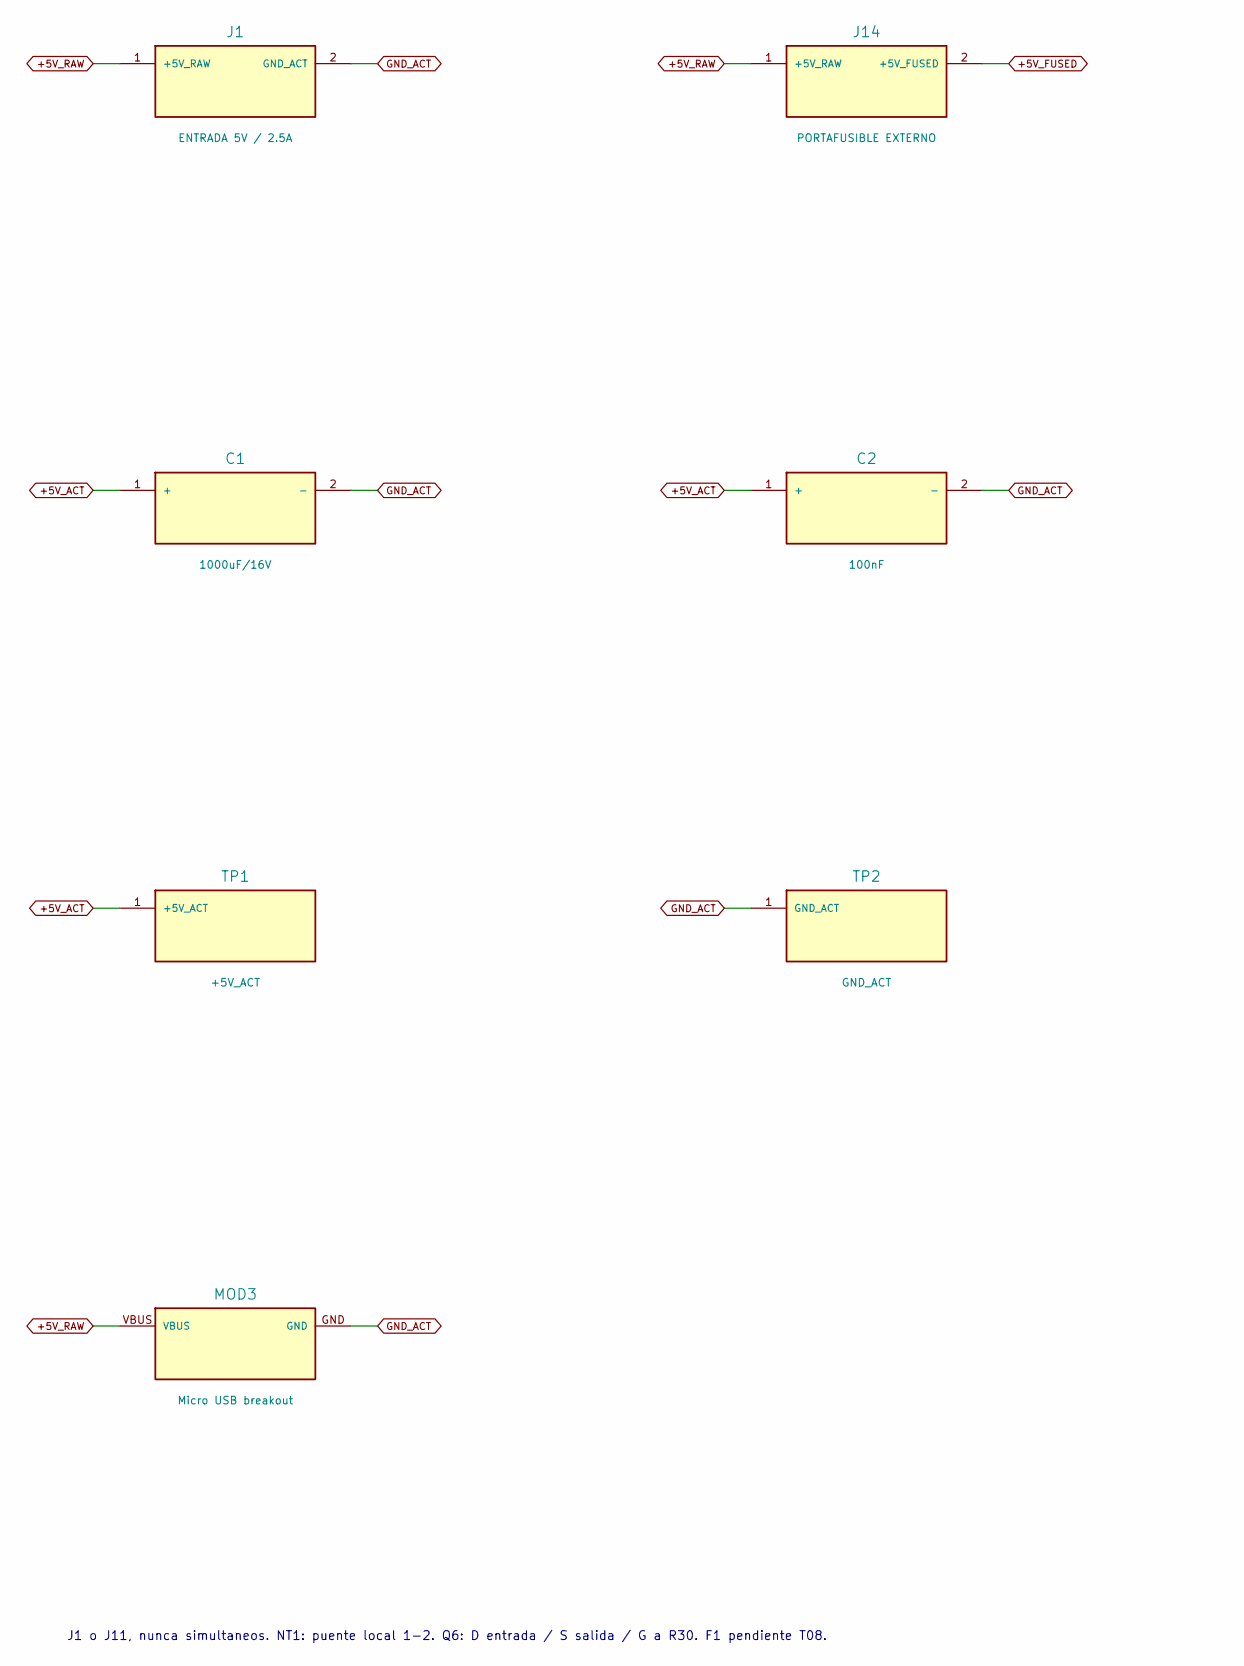
[picture p34: schematic 01_POWER.kicad_sch, part in row 1, column 1]

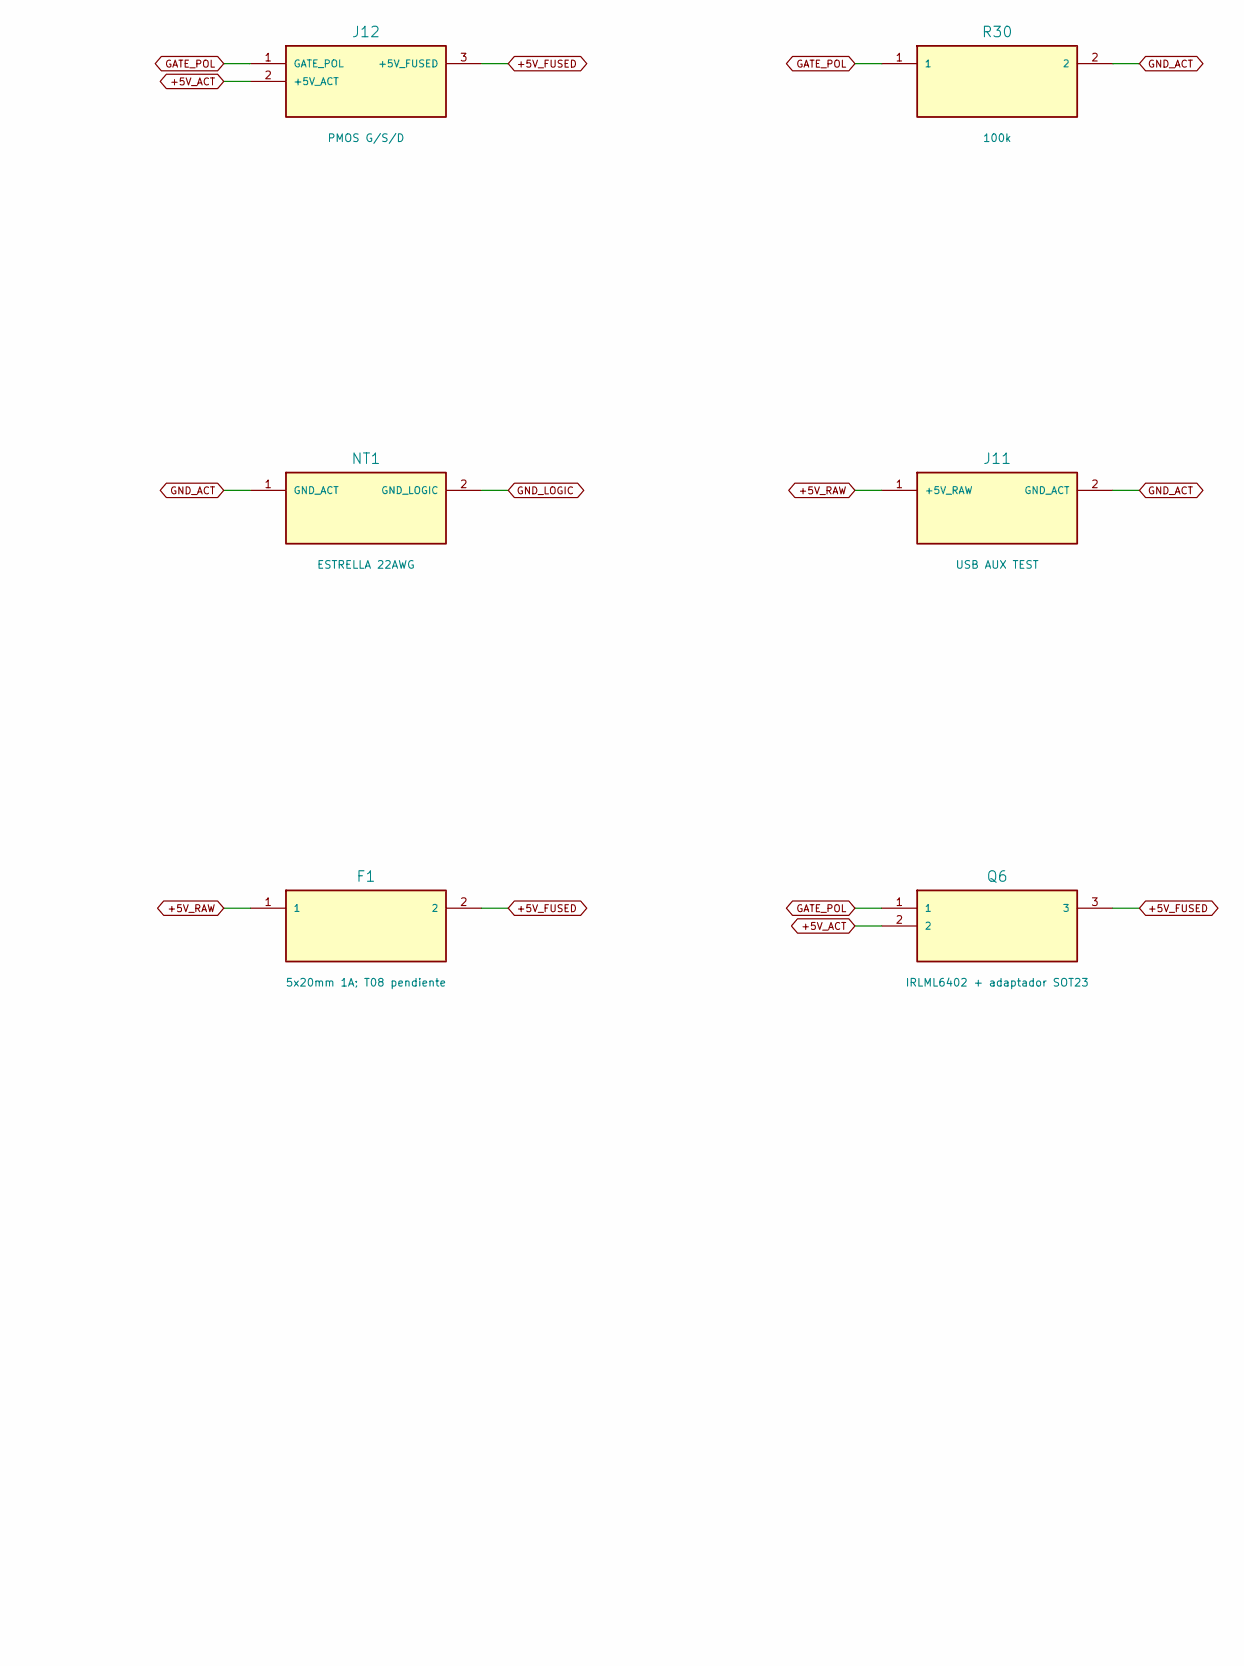
[picture p35: schematic 01_POWER.kicad_sch, part in row 1, column 2]

Parts:
C1: 1000uF/16V
C2: 100nF
F1: 5x20mm 1A; T08 pendiente
J1: ENTRADA 5V / 2.5A
J11: USB AUX TEST
J12: PMOS G/S/D
J14: PORTAFUSIBLE EXTERNO
MOD3: Micro USB breakout
NT1: ESTRELLA 22AWG
Q6: IRLML6402 + adaptador SOT23
R30: 100k
TP1: +5V_ACT
TP2: GND_ACT

Connections:
+5V_ACT: C1.1 (+), C2.1 (+), J12.2 (+5V_ACT), Q6.2, TP1.1
+5V_FUSED: F1.2, J12.3 (+5V_FUSED), J14.2 (+5V_FUSED), Q6.3
+5V_RAW: F1.1, J1.1 (+5V_RAW), J11.1 (+5V_RAW), J14.1 (+5V_RAW), MOD3.VBUS
GATE_POL: J12.1 (GATE_POL), Q6.1, R30.1
GND_ACT: C1.2 (-), C2.2 (-), J1.2 (GND_ACT), J11.2 (GND_ACT), MOD3.GND, NT1.1 (GND_ACT), R30.2, TP2.1
GND_LOGIC: NT1.2 (GND_LOGIC)

Notes on the sheet:
J1 o J11, nunca simultaneos. NT1: puente local 1-2. Q6: D entrada / S salida / G a R30. F1 pendiente T08.
