bitvalo34/trama3-ccviii/hardware/diseno-placas/esquematicos/02_CORE.kicad_sch

## KiCad design hardware/diseno-placas/esquematicos/02_CORE.kicad_sch (2026-11-09)

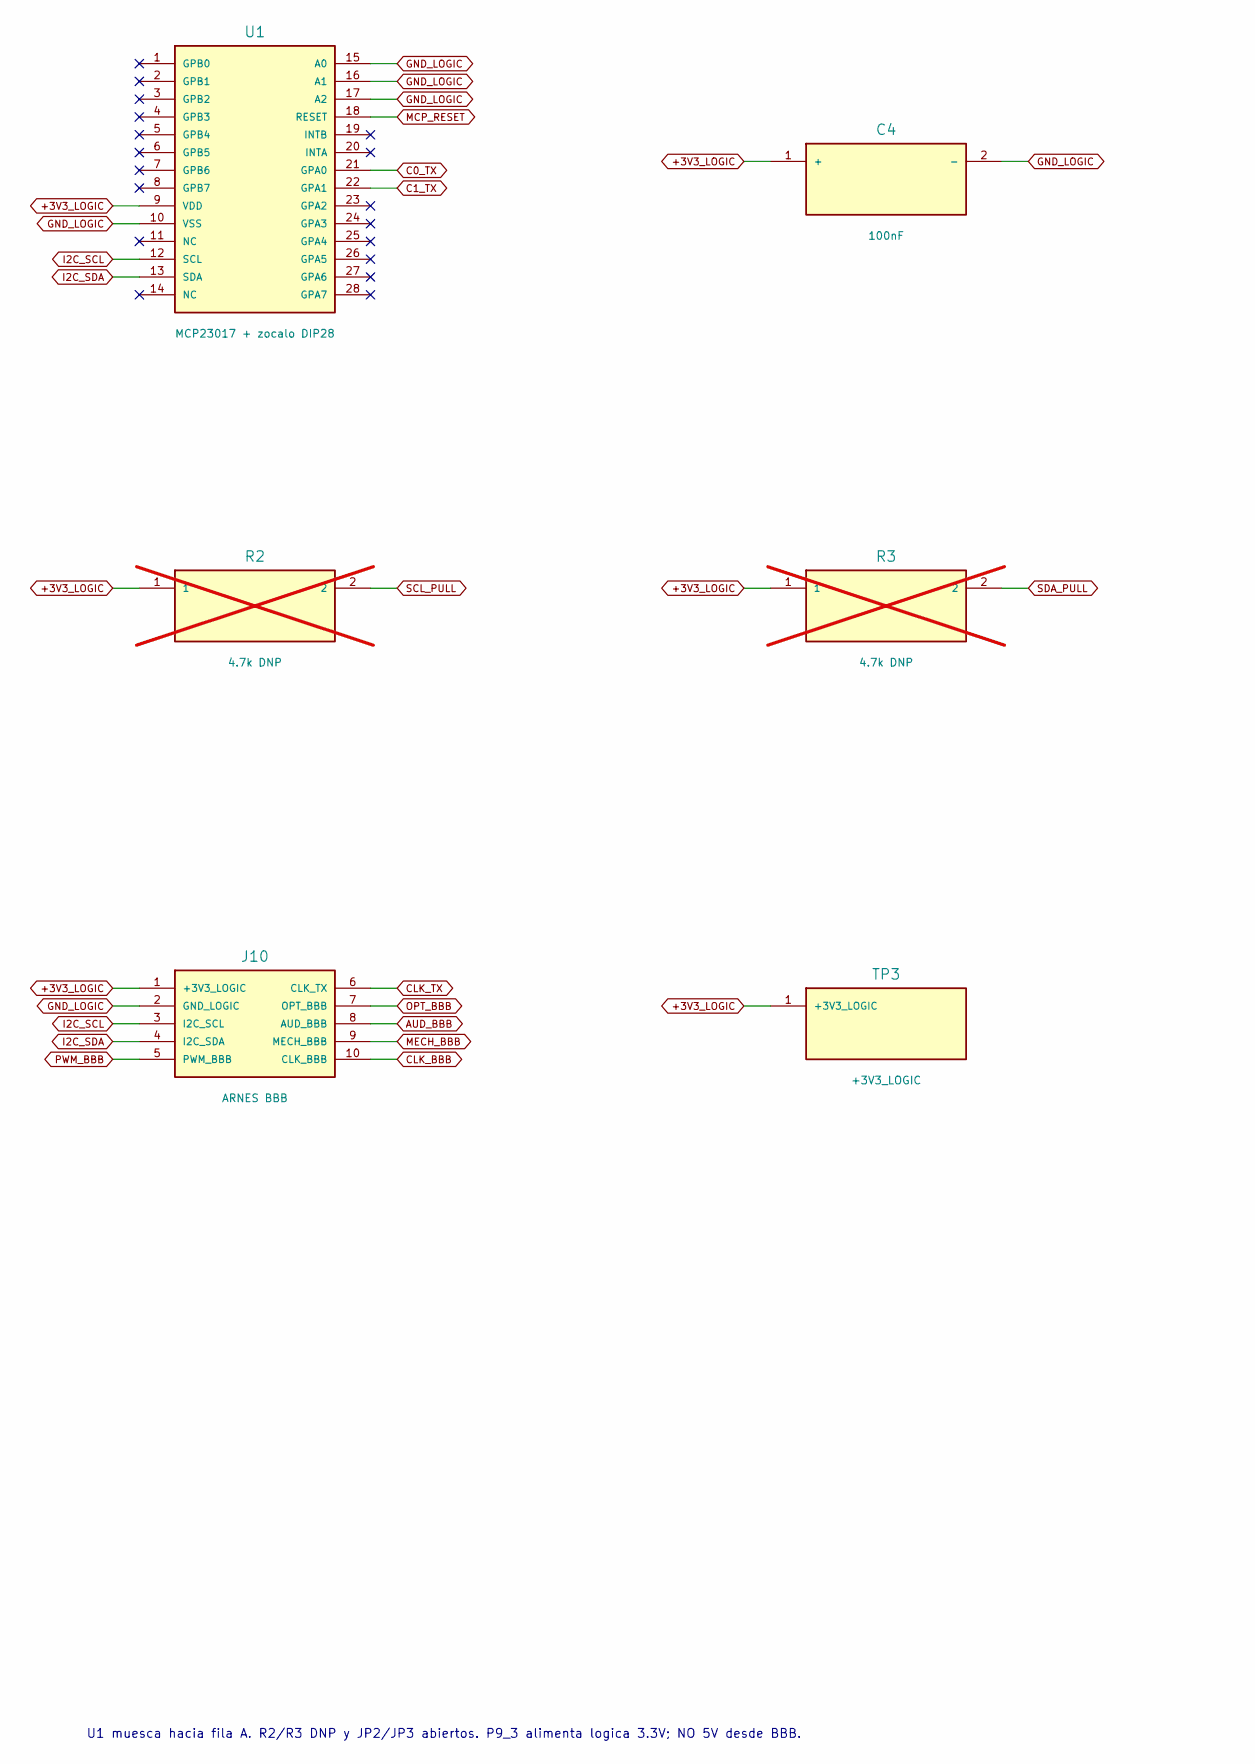
[picture p36: schematic 02_CORE.kicad_sch, part in row 1, column 1]

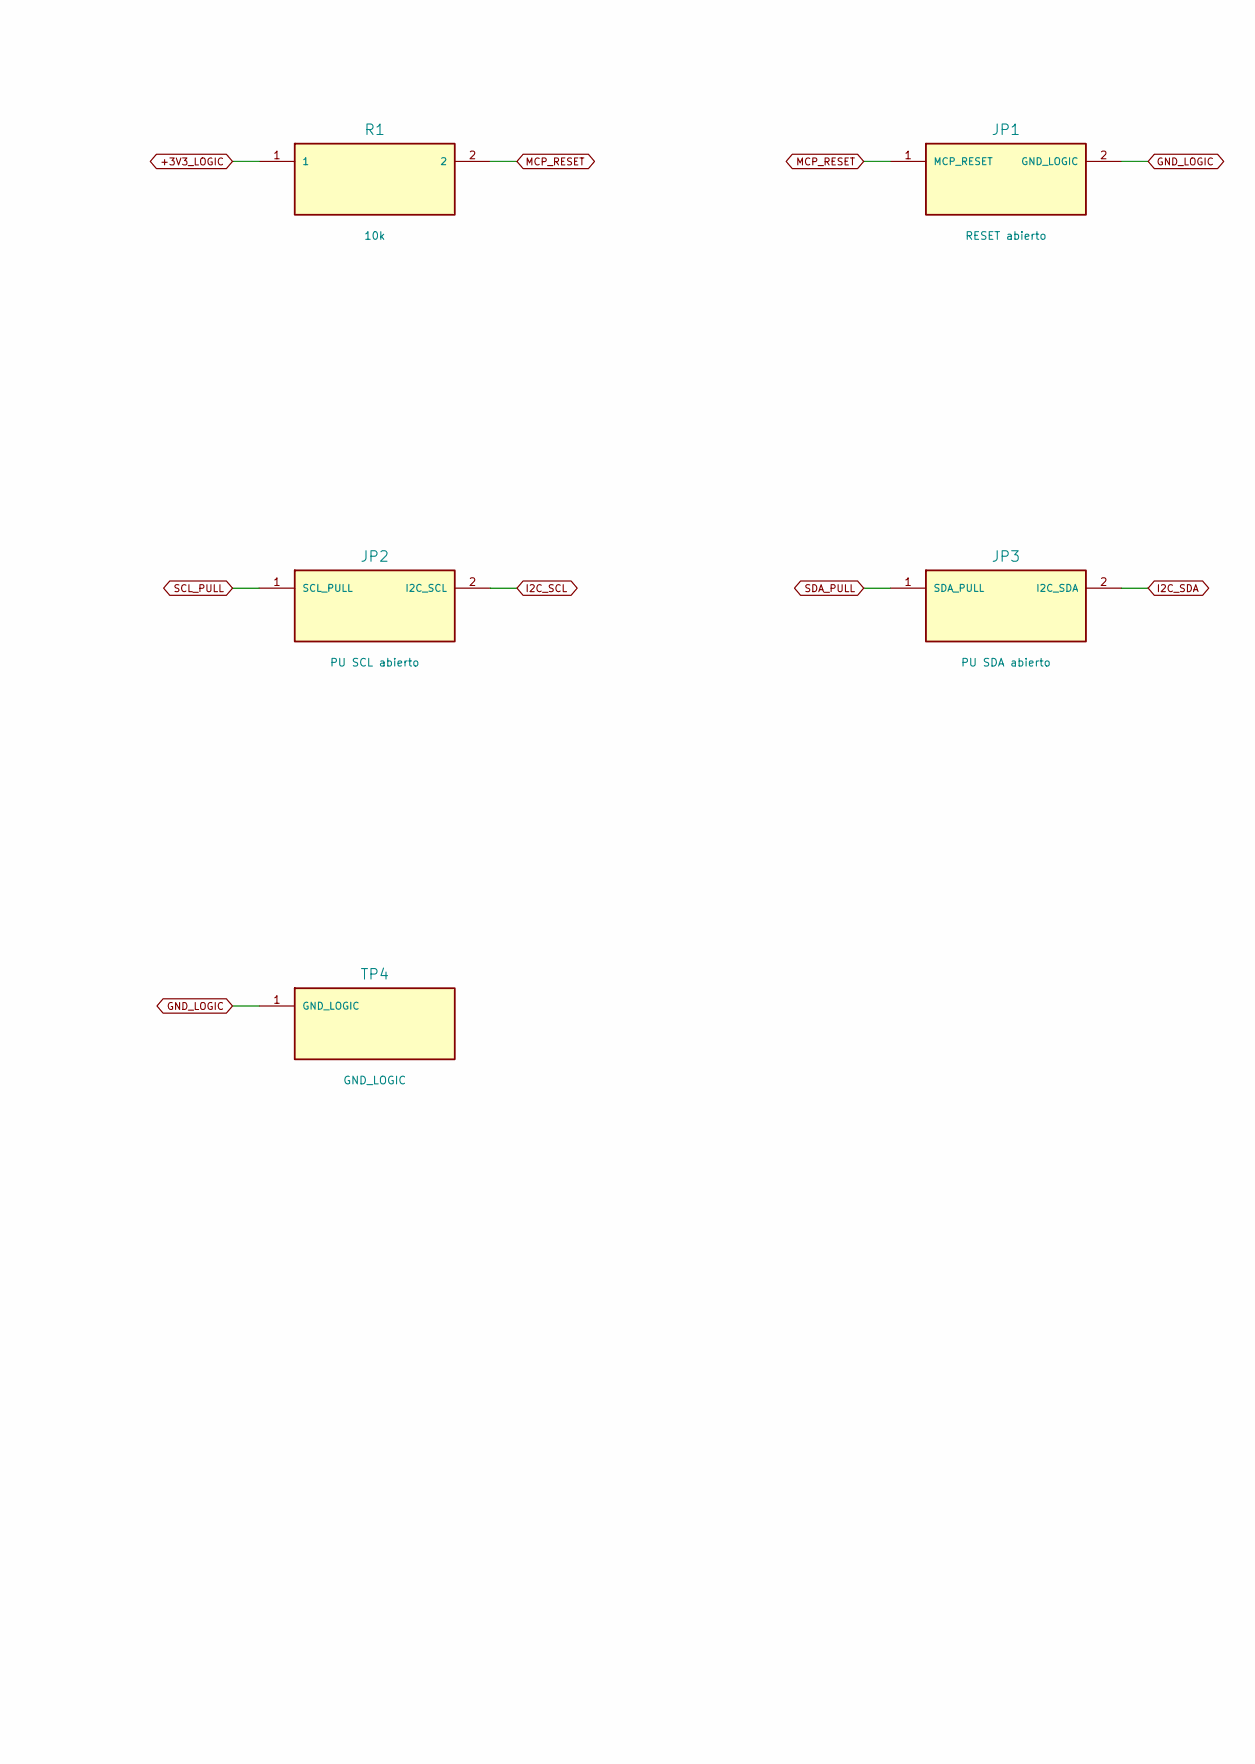
[picture p37: schematic 02_CORE.kicad_sch, part in row 1, column 2]

Parts:
C4: 100nF
J10: ARNES BBB
JP1: RESET abierto
JP2: PU SCL abierto
JP3: PU SDA abierto
R1: 10k
R2, R3: 4.7k DNP; not fitted
TP3: +3V3_LOGIC
TP4: GND_LOGIC
U1: MCP23017 + zocalo DIP28

Connections:
+3V3_LOGIC: C4.1 (+), J10.1 (+3V3_LOGIC), R1.1, R2.1, R3.1, TP3.1, U1.9 (VDD)
AUD_BBB: J10.8 (AUD_BBB)
C0_TX: U1.21 (GPA0)
C1_TX: U1.22 (GPA1)
CLK_BBB: J10.10 (CLK_BBB)
CLK_TX: J10.6 (CLK_TX)
GND_LOGIC: C4.2 (-), J10.2 (GND_LOGIC), JP1.2 (GND_LOGIC), TP4.1, U1.10 (VSS), U1.15 (A0), U1.16 (A1), U1.17 (A2)
I2C_SCL: J10.3 (I2C_SCL), JP2.2 (I2C_SCL), U1.12 (SCL)
I2C_SDA: J10.4 (I2C_SDA), JP3.2 (I2C_SDA), U1.13 (SDA)
MCP_RESET: JP1.1 (MCP_RESET), R1.2, U1.18 (RESET)
MECH_BBB: J10.9 (MECH_BBB)
OPT_BBB: J10.7 (OPT_BBB)
PWM_BBB: J10.5 (PWM_BBB)
SCL_PULL: JP2.1 (SCL_PULL), R2.2
SDA_PULL: JP3.1 (SDA_PULL), R3.2

Notes on the sheet:
U1 muesca hacia fila A. R2/R3 DNP y JP2/JP3 abiertos. P9_3 alimenta logica 3.3V; NO 5V desde BBB.
