bitvalo34/trama3-ccviii/hardware/diseno-placas/esquematicos/03_TX.kicad_sch

## KiCad design hardware/diseno-placas/esquematicos/03_TX.kicad_sch (2026-11-09)

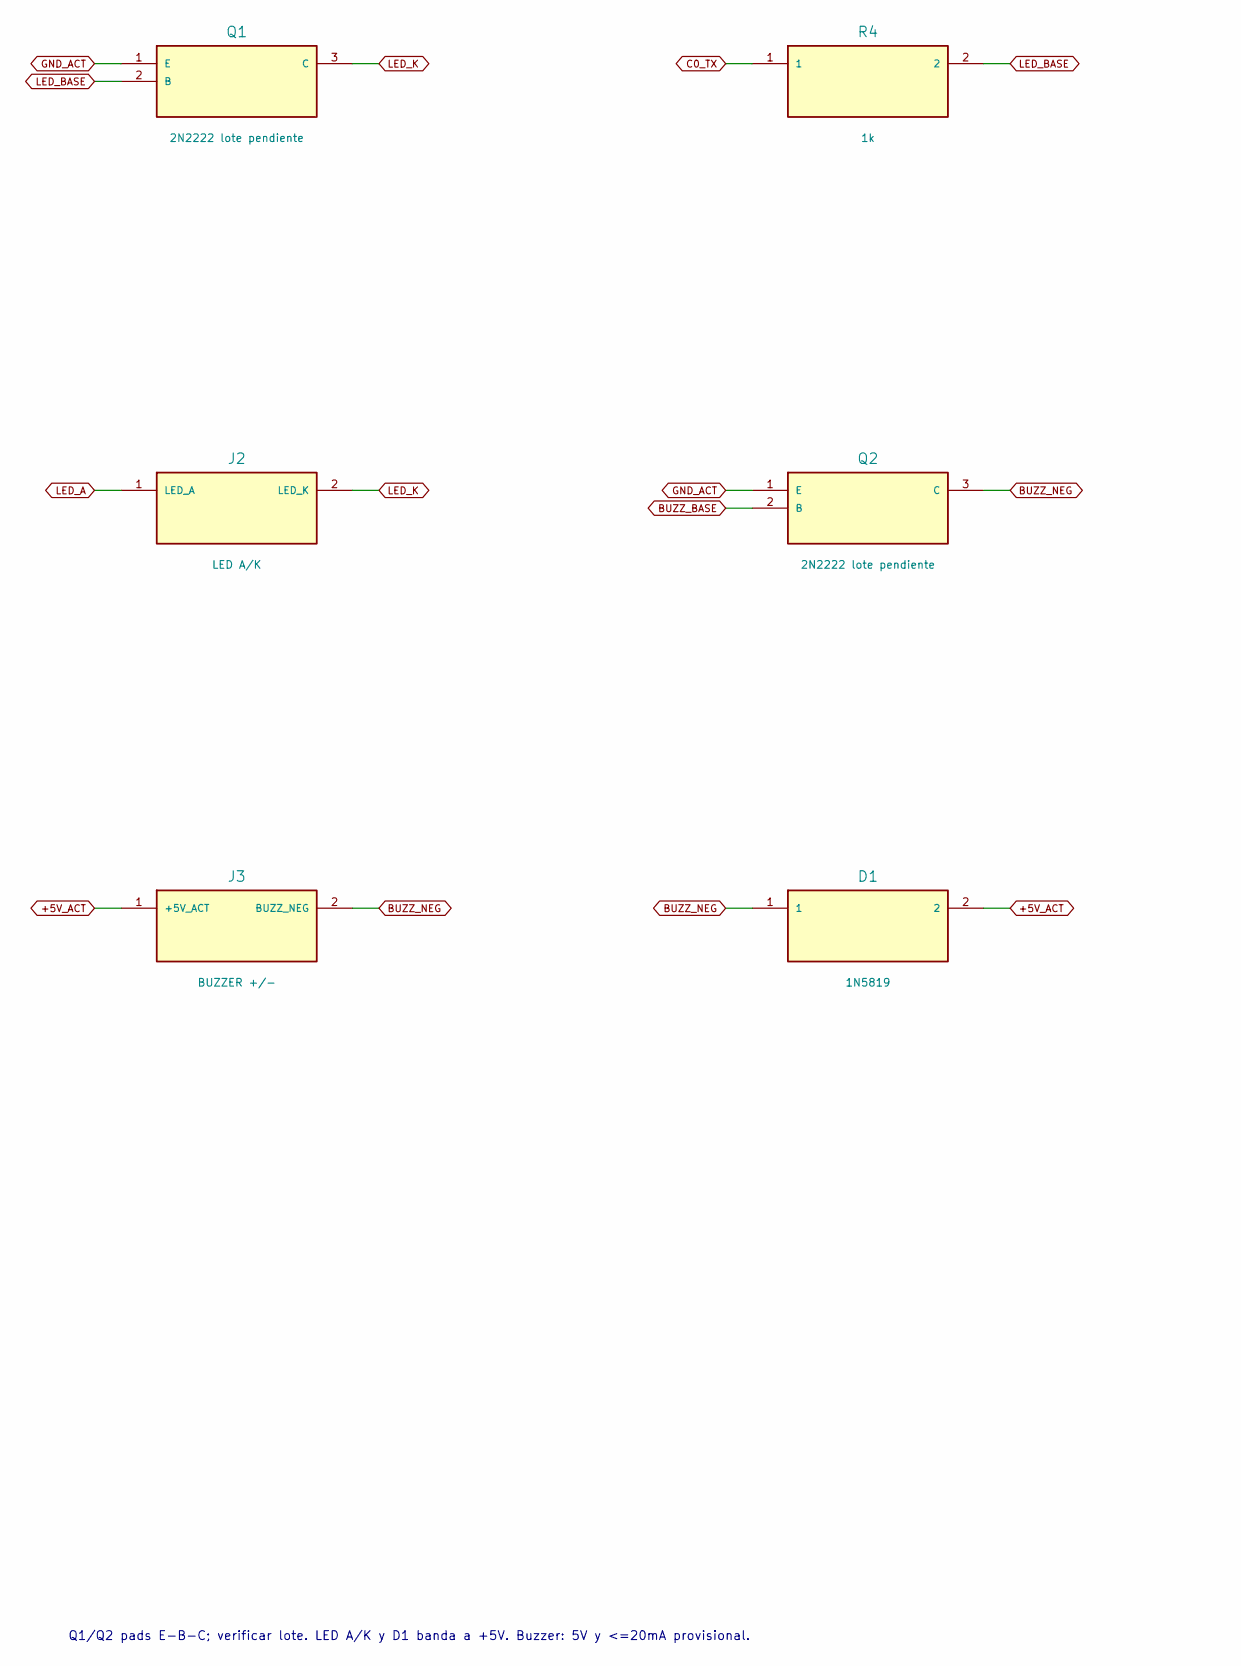
[picture p38: schematic 03_TX.kicad_sch, part in row 1, column 1]

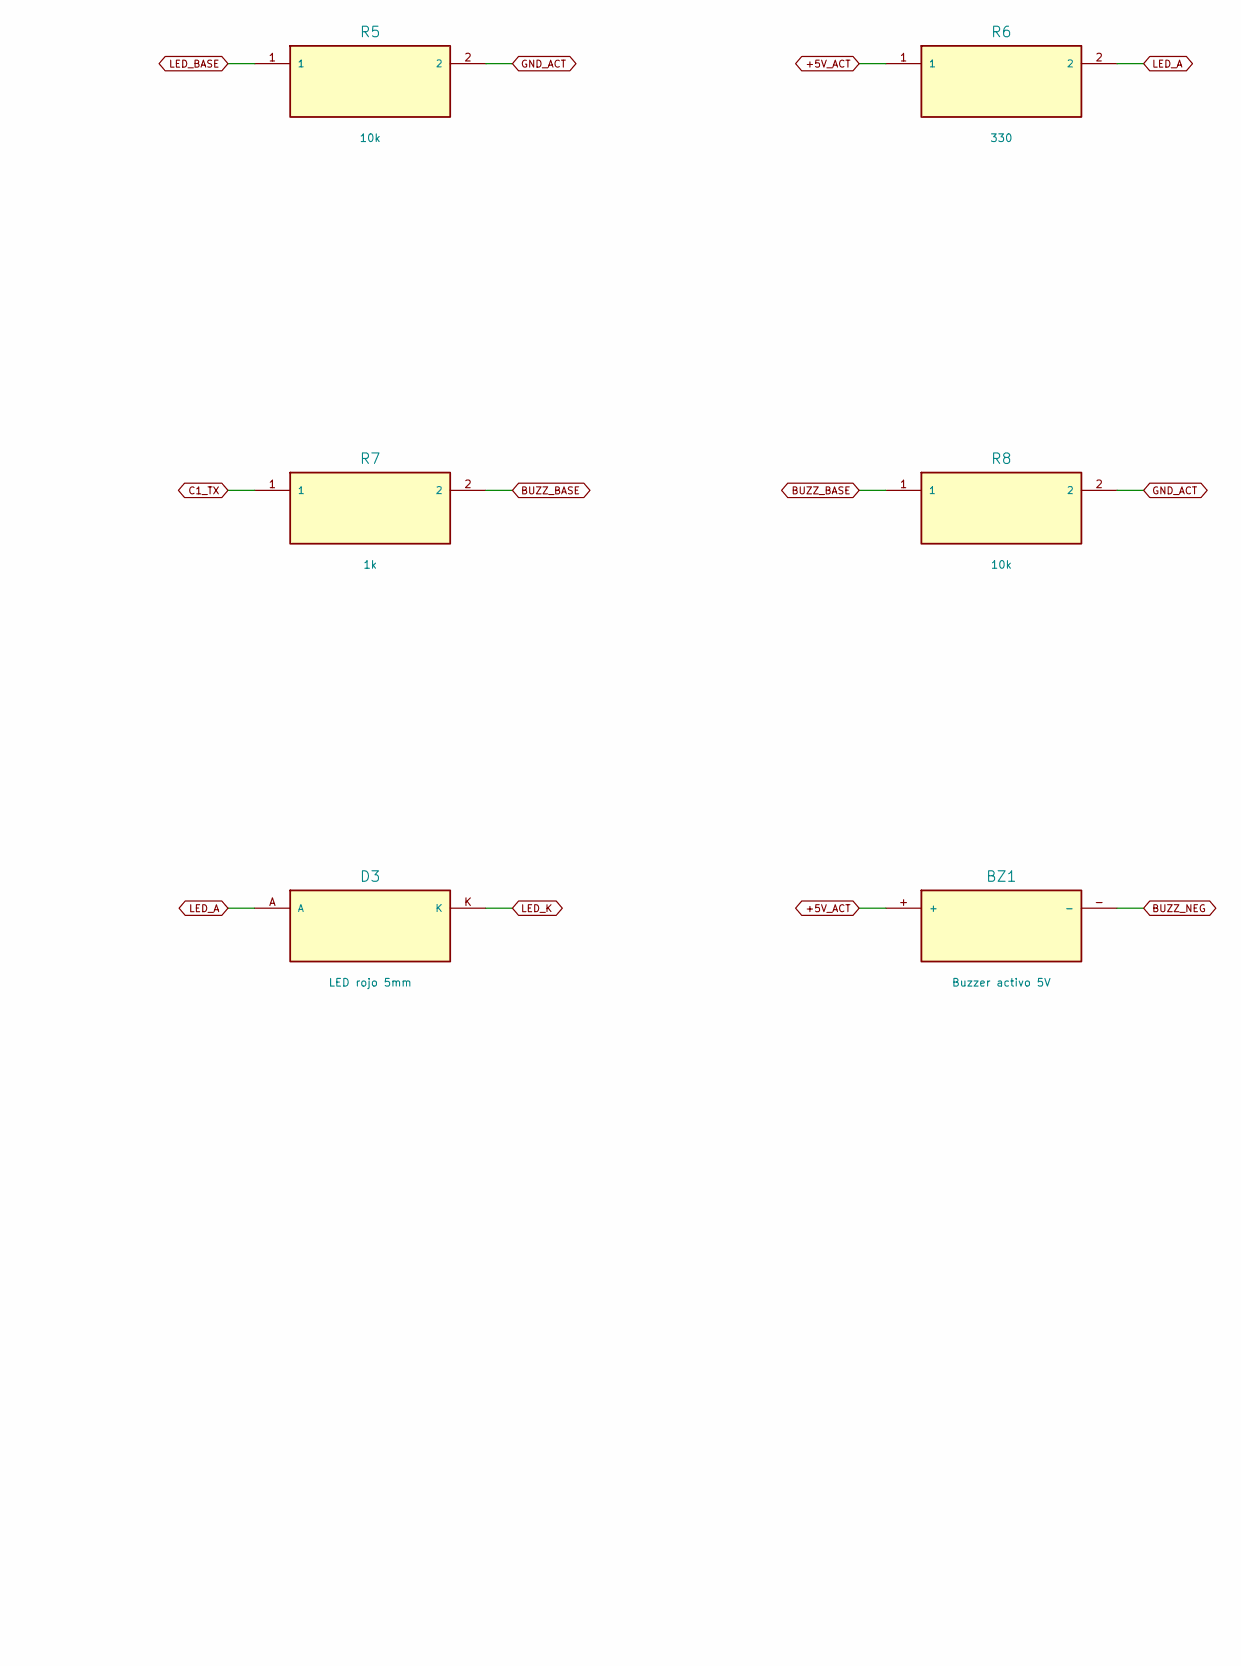
[picture p39: schematic 03_TX.kicad_sch, part in row 1, column 2]

Parts:
BZ1: Buzzer activo 5V
D1: 1N5819
D3: LED rojo 5mm
J2: LED A/K
J3: BUZZER +/-
Q1, Q2: 2N2222 lote pendiente
R4, R7: 1k
R5, R8: 10k
R6: 330

Connections:
+5V_ACT: BZ1.+, D1.2, J3.1 (+5V_ACT), R6.1
BUZZ_BASE: Q2.2 (B), R7.2, R8.1
BUZZ_NEG: BZ1.-, D1.1, J3.2 (BUZZ_NEG), Q2.3 (C)
C0_TX: R4.1
C1_TX: R7.1
GND_ACT: Q1.1 (E), Q2.1 (E), R5.2, R8.2
LED_A: D3.A, J2.1 (LED_A), R6.2
LED_BASE: Q1.2 (B), R4.2, R5.1
LED_K: D3.K, J2.2 (LED_K), Q1.3 (C)

Notes on the sheet:
Q1/Q2 pads E-B-C; verificar lote. LED A/K y D1 banda a +5V. Buzzer: 5V y <=20mA provisional.
