bitvalo34/trama3-ccviii/hardware/diseno-placas/esquematicos/04_SERVO.kicad_sch

## KiCad design hardware/diseno-placas/esquematicos/04_SERVO.kicad_sch (2026-11-09)

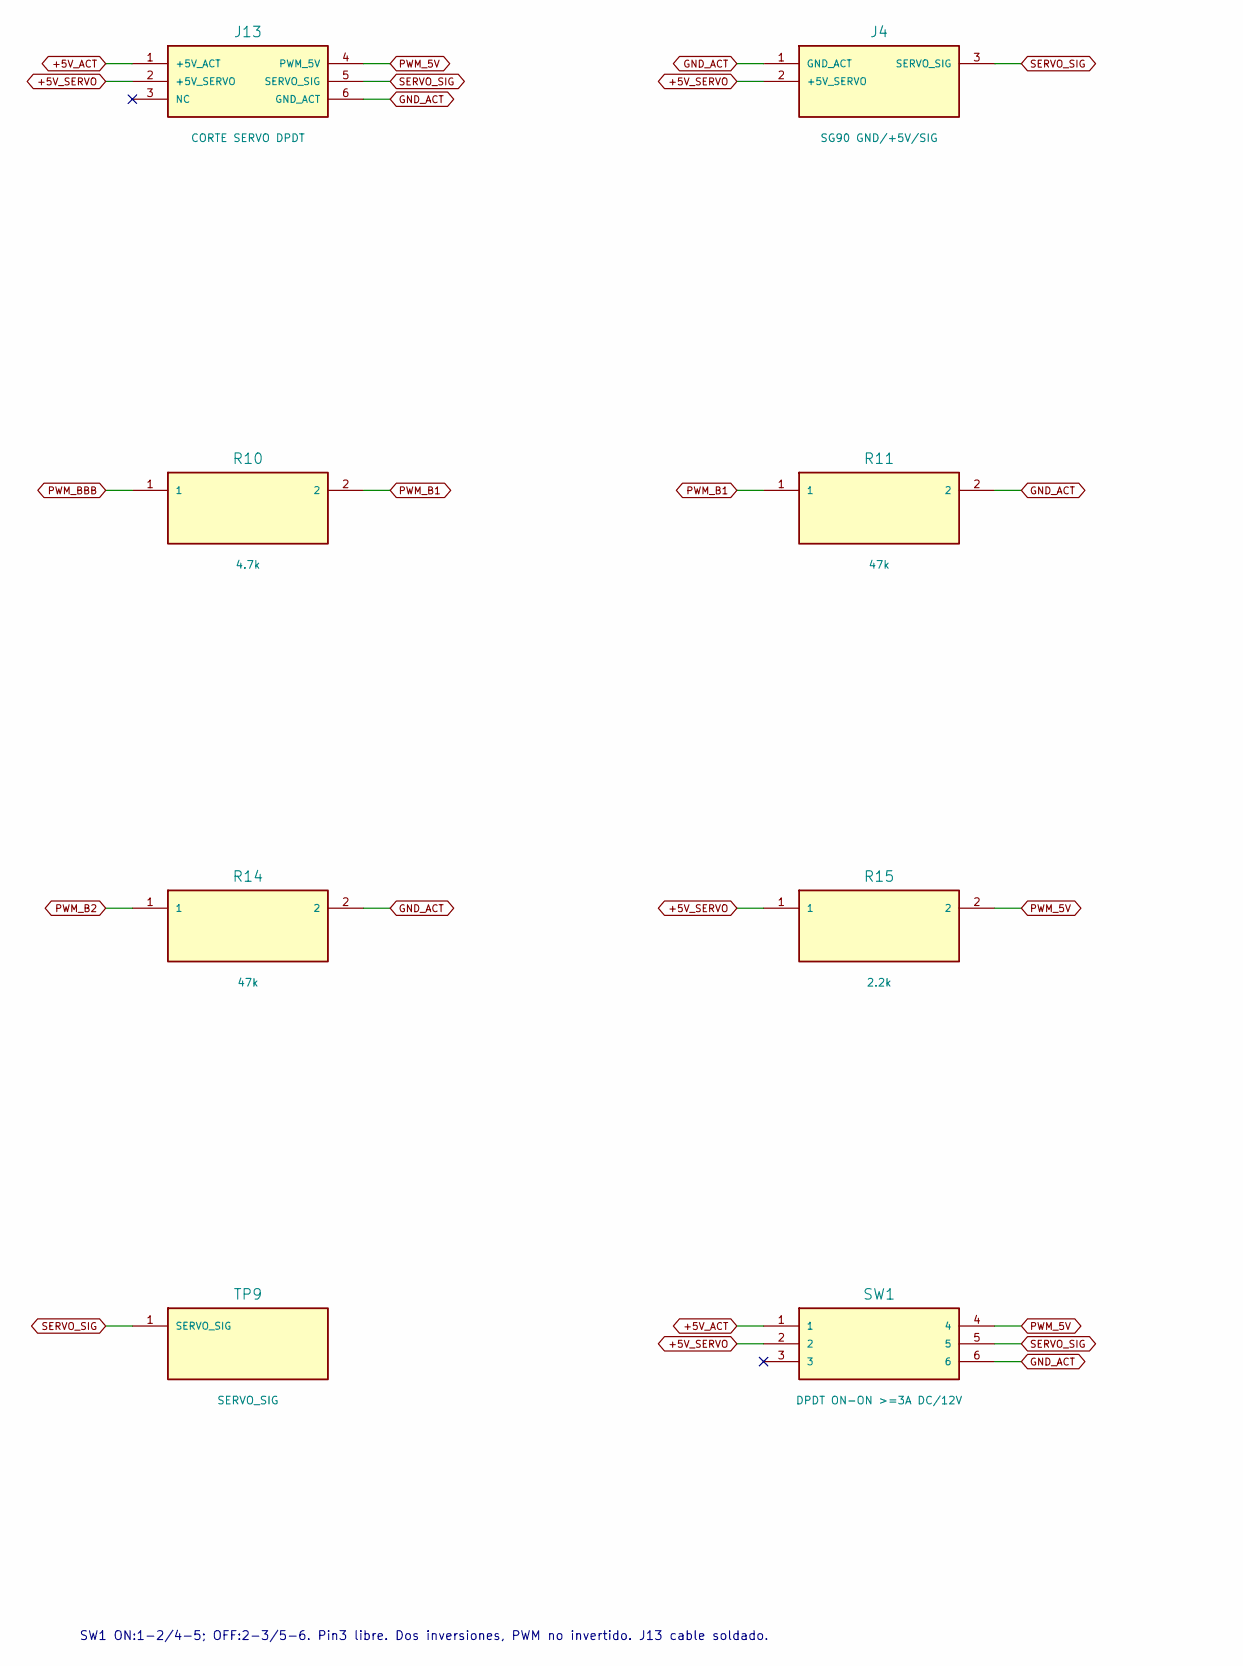
[picture p40: schematic 04_SERVO.kicad_sch, part in row 1, column 1]

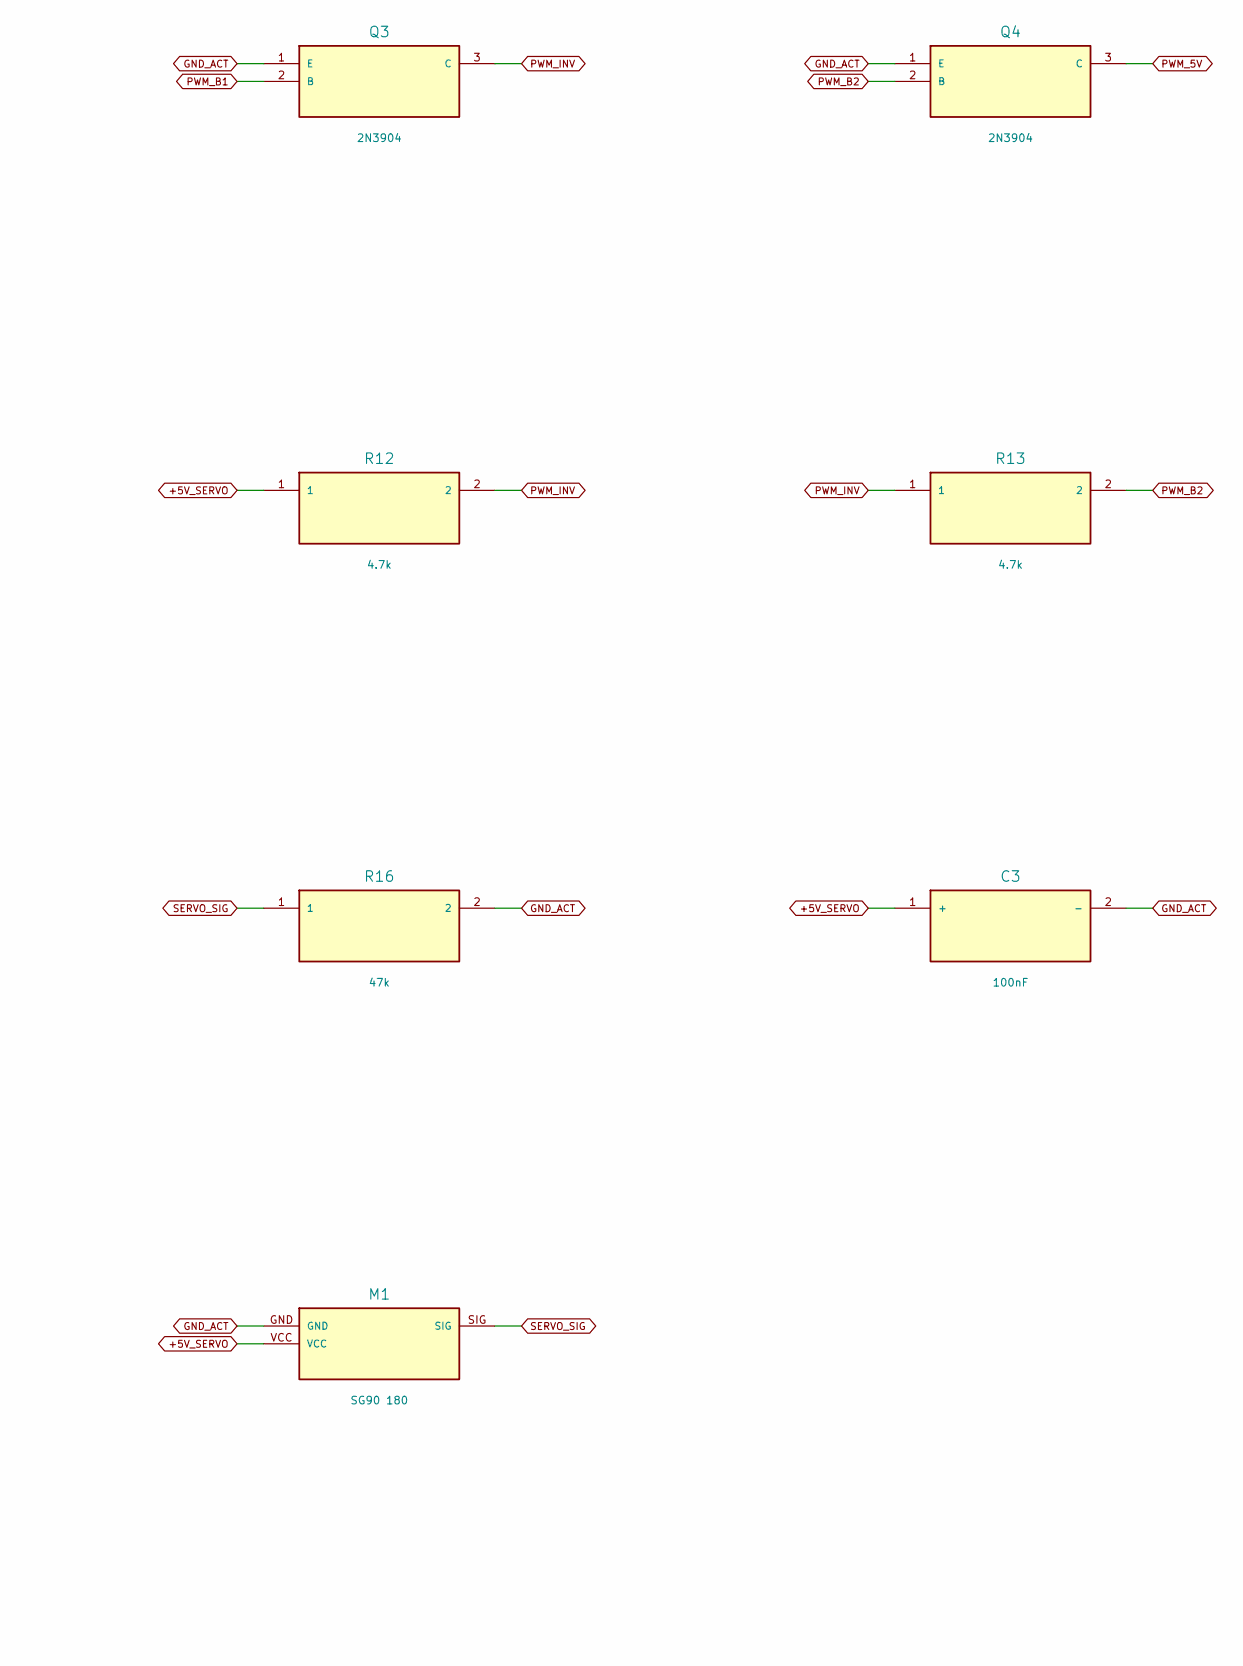
[picture p41: schematic 04_SERVO.kicad_sch, part in row 1, column 2]

Parts:
C3: 100nF
J4: SG90 GND/+5V/SIG
J13: CORTE SERVO DPDT
M1: SG90 180
Q3, Q4: 2N3904
R10, R12, R13: 4.7k
R11, R14, R16: 47k
R15: 2.2k
SW1: DPDT ON-ON >=3A DC/12V
TP9: SERVO_SIG

Connections:
+5V_ACT: J13.1 (+5V_ACT), SW1.1
+5V_SERVO: C3.1 (+), J4.2 (+5V_SERVO), J13.2 (+5V_SERVO), M1.VCC, R12.1, R15.1, SW1.2
GND_ACT: C3.2 (-), J4.1 (GND_ACT), J13.6 (GND_ACT), M1.GND, Q3.1 (E), Q4.1 (E), R11.2, R14.2, R16.2, SW1.6
PWM_5V: J13.4 (PWM_5V), Q4.3 (C), R15.2, SW1.4
PWM_B1: Q3.2 (B), R10.2, R11.1
PWM_B2: Q4.2 (B), R13.2, R14.1
PWM_BBB: R10.1
PWM_INV: Q3.3 (C), R12.2, R13.1
SERVO_SIG: J4.3 (SERVO_SIG), J13.5 (SERVO_SIG), M1.SIG, R16.1, SW1.5, TP9.1

Notes on the sheet:
SW1 ON:1-2/4-5; OFF:2-3/5-6. Pin3 libre. Dos inversiones, PWM no invertido. J13 cable soldado.
