bitvalo34/trama3-ccviii/hardware/diseno-placas/esquematicos/05_RX.kicad_sch

## KiCad design hardware/diseno-placas/esquematicos/05_RX.kicad_sch (2026-11-09)

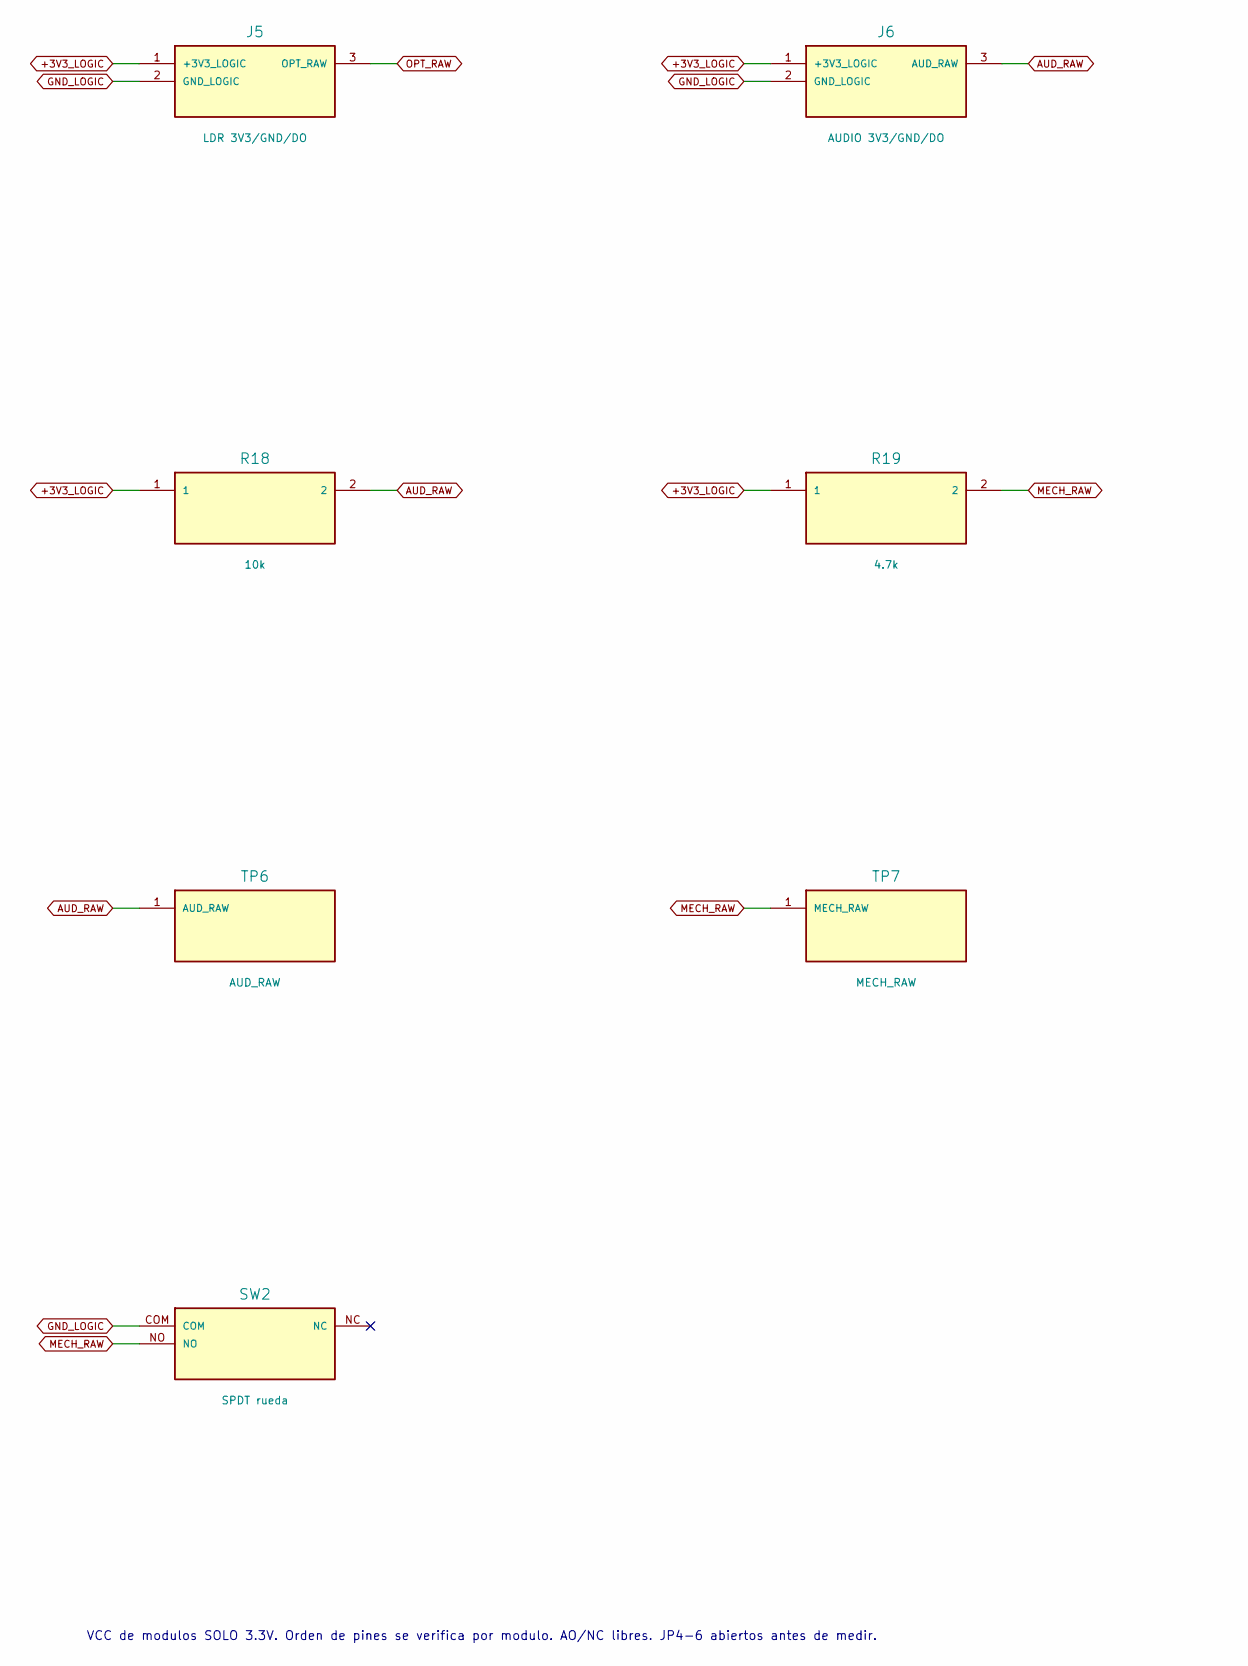
[picture p42: schematic 05_RX.kicad_sch, part in row 1, column 1]

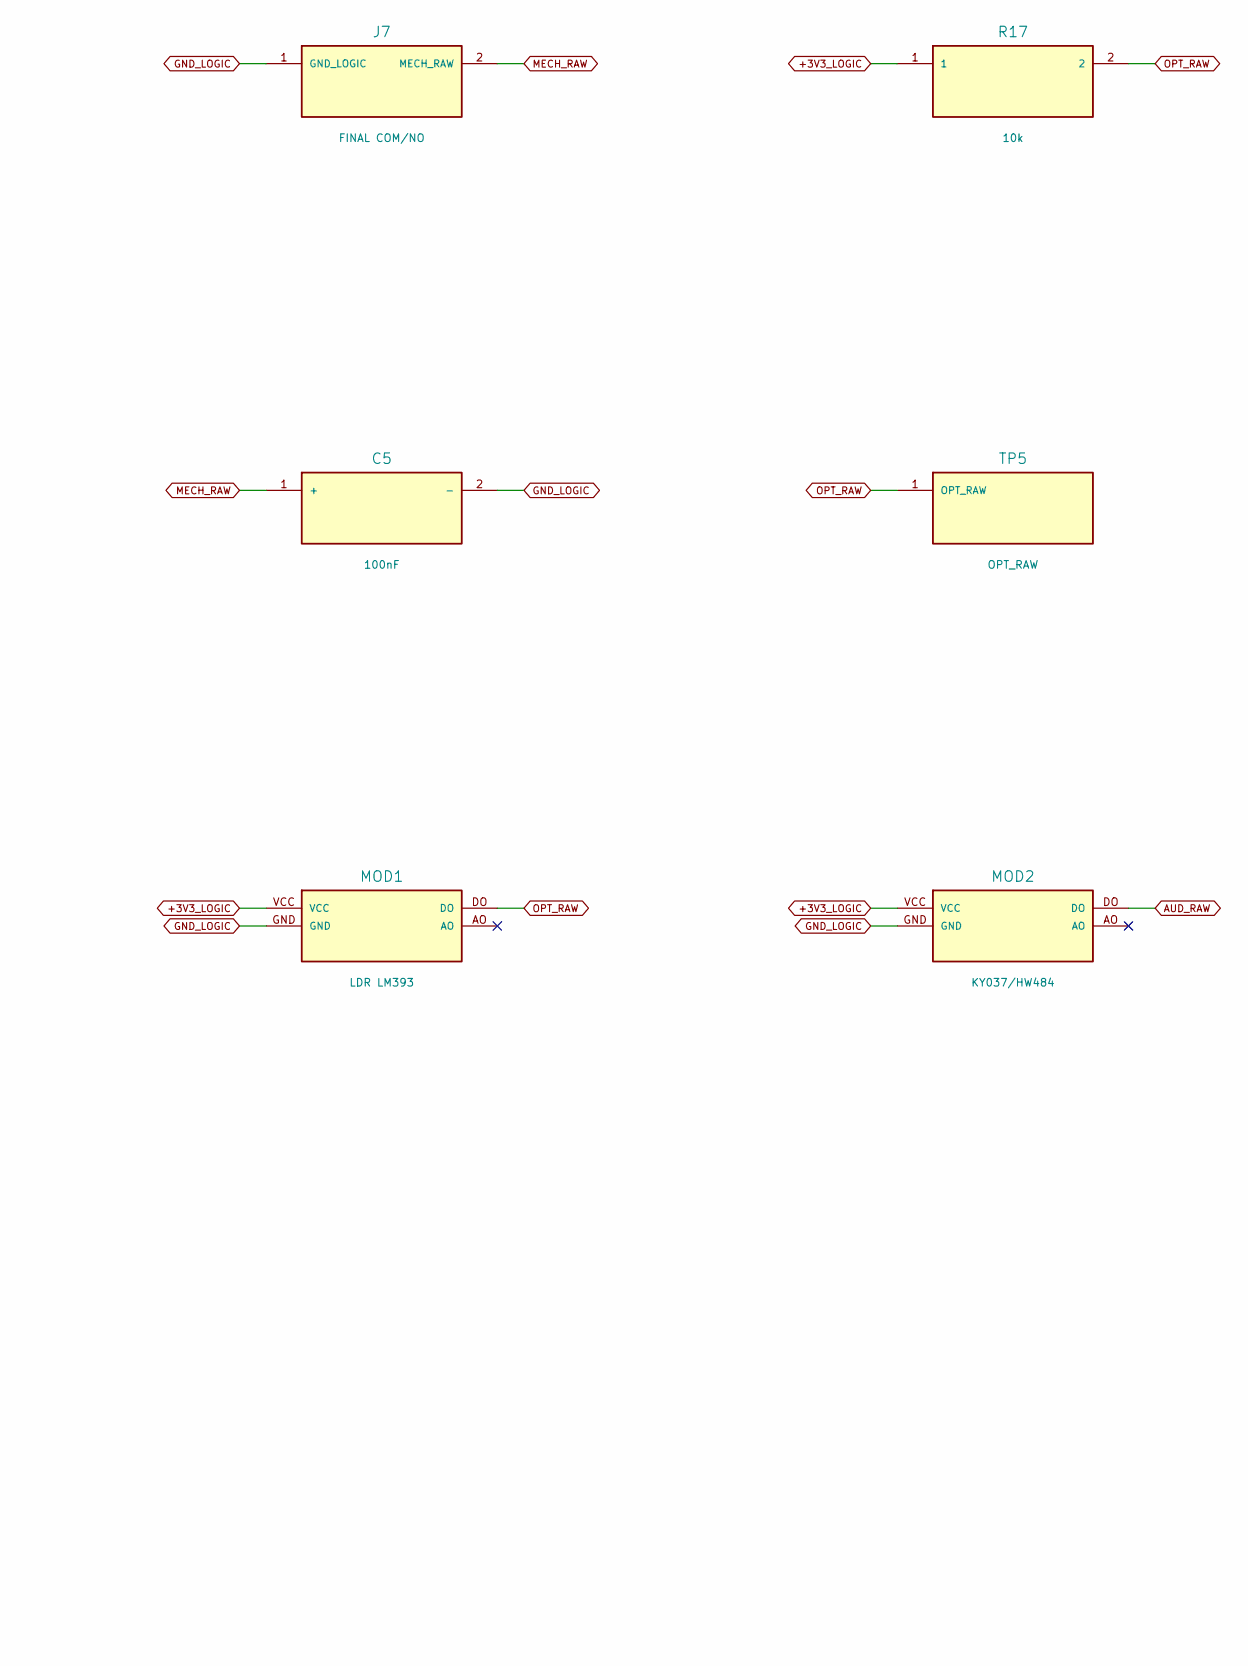
[picture p43: schematic 05_RX.kicad_sch, part in row 1, column 2]

Parts:
C5: 100nF
J5: LDR 3V3/GND/DO
J6: AUDIO 3V3/GND/DO
J7: FINAL COM/NO
MOD1: LDR LM393
MOD2: KY037/HW484
R17, R18: 10k
R19: 4.7k
SW2: SPDT rueda
TP5: OPT_RAW
TP6: AUD_RAW
TP7: MECH_RAW

Connections:
+3V3_LOGIC: J5.1 (+3V3_LOGIC), J6.1 (+3V3_LOGIC), MOD1.VCC, MOD2.VCC, R17.1, R18.1, R19.1
AUD_RAW: J6.3 (AUD_RAW), MOD2.DO, R18.2, TP6.1
GND_LOGIC: C5.2 (-), J5.2 (GND_LOGIC), J6.2 (GND_LOGIC), J7.1 (GND_LOGIC), MOD1.GND, MOD2.GND, SW2.COM
MECH_RAW: C5.1 (+), J7.2 (MECH_RAW), R19.2, SW2.NO, TP7.1
OPT_RAW: J5.3 (OPT_RAW), MOD1.DO, R17.2, TP5.1

Notes on the sheet:
VCC de modulos SOLO 3.3V. Orden de pines se verifica por modulo. AO/NC libres. JP4-6 abiertos antes de medir.
