bitvalo34/trama3-ccviii/hardware/diseno-placas/esquematicos/06_ENABLE.kicad_sch

## KiCad design hardware/diseno-placas/esquematicos/06_ENABLE.kicad_sch (2026-11-09)

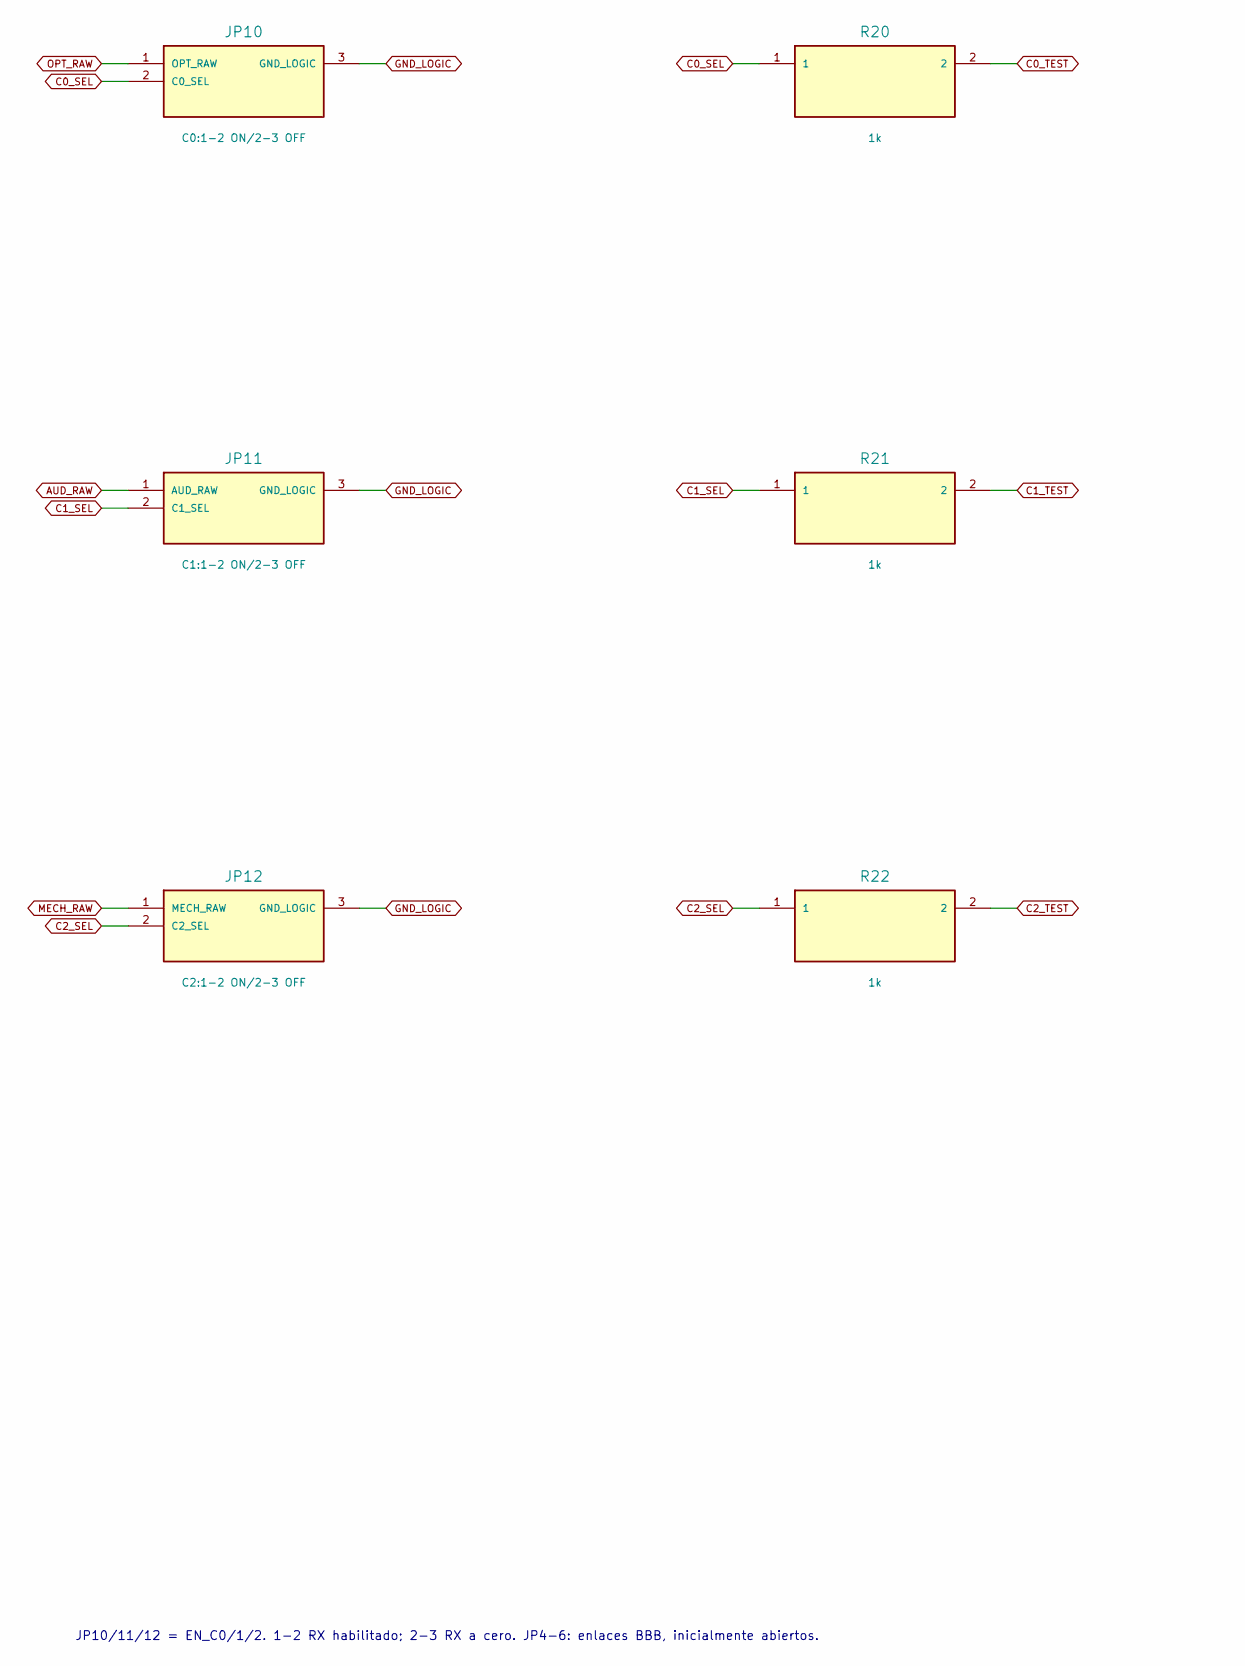
[picture p44: schematic 06_ENABLE.kicad_sch, part in row 1, column 1]

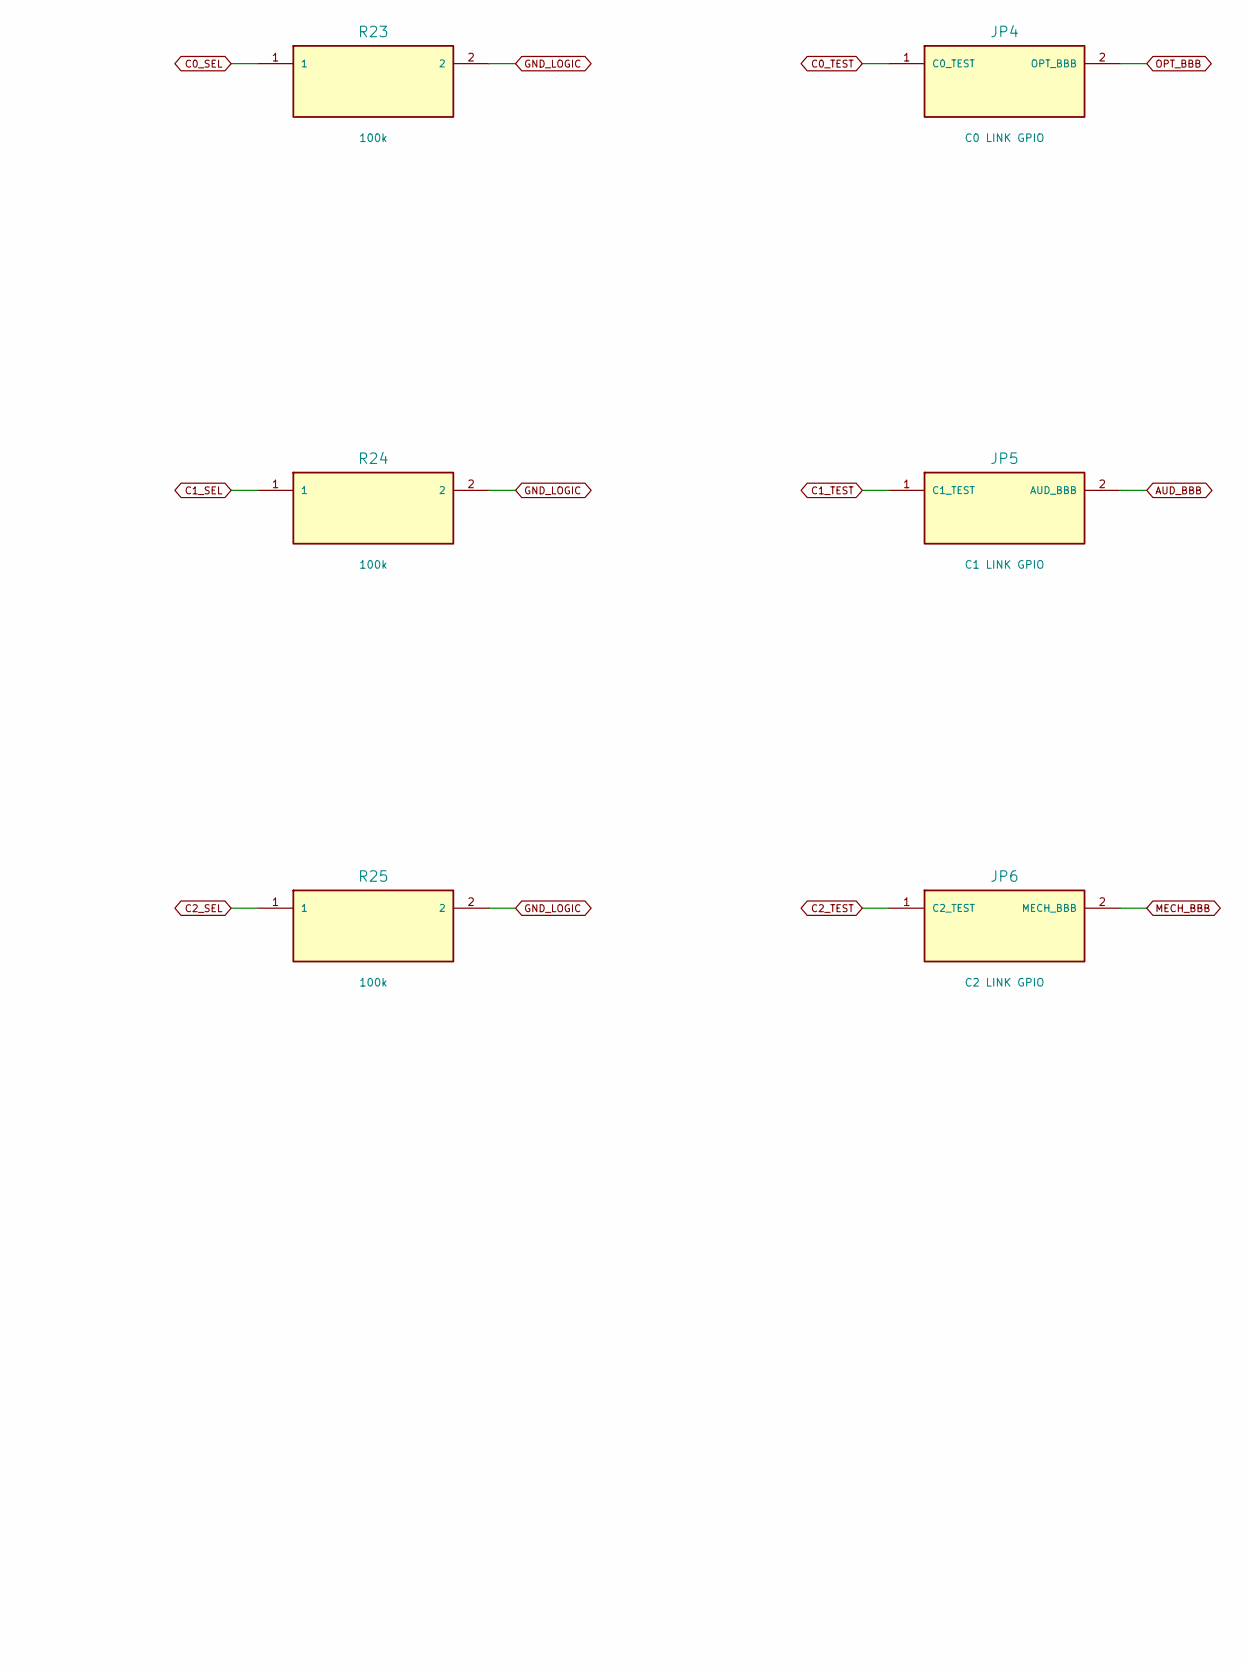
[picture p45: schematic 06_ENABLE.kicad_sch, part in row 1, column 2]

Parts:
JP4: C0 LINK GPIO
JP5: C1 LINK GPIO
JP6: C2 LINK GPIO
JP10: C0:1-2 ON/2-3 OFF
JP11: C1:1-2 ON/2-3 OFF
JP12: C2:1-2 ON/2-3 OFF
R20, R21, R22: 1k
R23, R24, R25: 100k

Connections:
AUD_BBB: JP5.2 (AUD_BBB)
AUD_RAW: JP11.1 (AUD_RAW)
C0_SEL: JP10.2 (C0_SEL), R20.1, R23.1
C0_TEST: JP4.1 (C0_TEST), R20.2
C1_SEL: JP11.2 (C1_SEL), R21.1, R24.1
C1_TEST: JP5.1 (C1_TEST), R21.2
C2_SEL: JP12.2 (C2_SEL), R22.1, R25.1
C2_TEST: JP6.1 (C2_TEST), R22.2
GND_LOGIC: JP10.3 (GND_LOGIC), JP11.3 (GND_LOGIC), JP12.3 (GND_LOGIC), R23.2, R24.2, R25.2
MECH_BBB: JP6.2 (MECH_BBB)
MECH_RAW: JP12.1 (MECH_RAW)
OPT_BBB: JP4.2 (OPT_BBB)
OPT_RAW: JP10.1 (OPT_RAW)

Notes on the sheet:
JP10/11/12 = EN_C0/1/2. 1-2 RX habilitado; 2-3 RX a cero. JP4-6: enlaces BBB, inicialmente abiertos.
