bitvalo34/trama3-ccviii/hardware/diseno-placas/esquematicos/07_CLOCK.kicad_sch

## KiCad design hardware/diseno-placas/esquematicos/07_CLOCK.kicad_sch (2026-11-09)

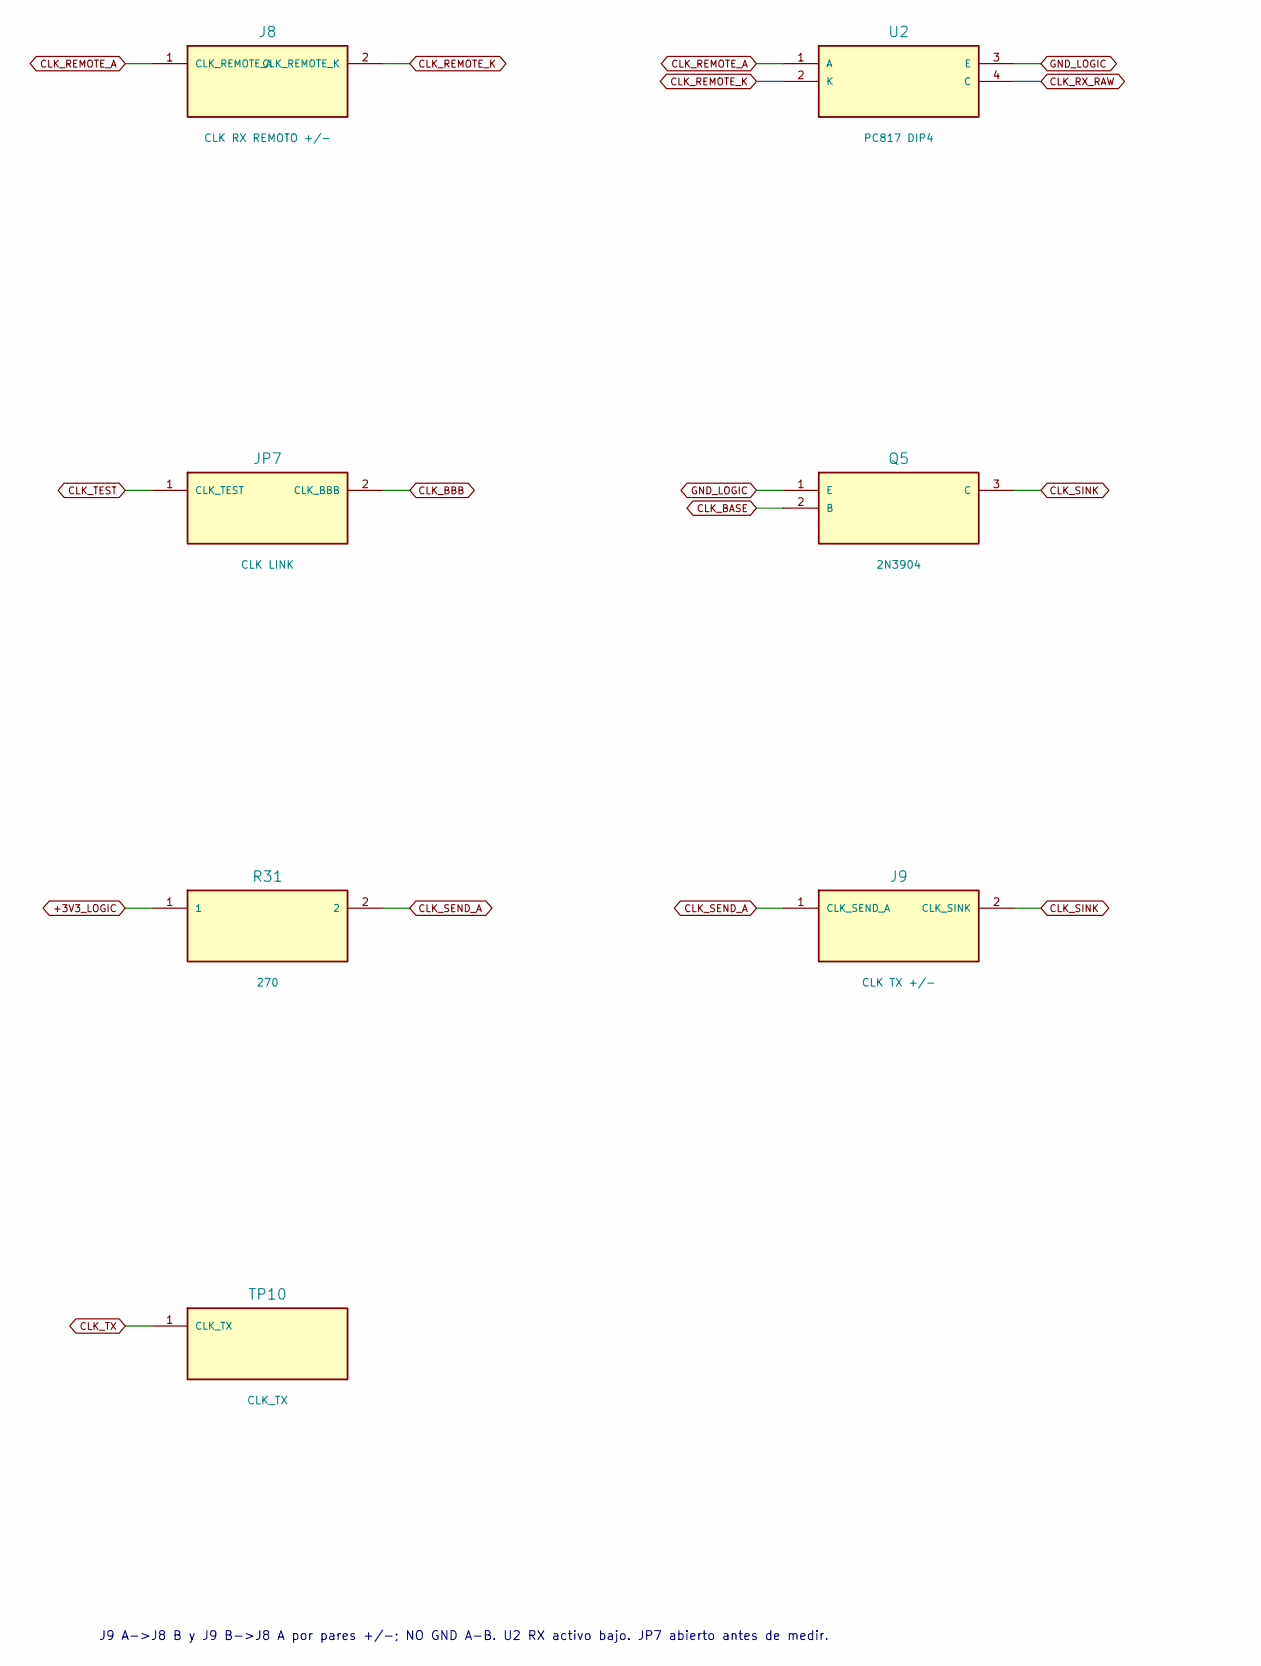
[picture p46: schematic 07_CLOCK.kicad_sch, part in row 1, column 1]

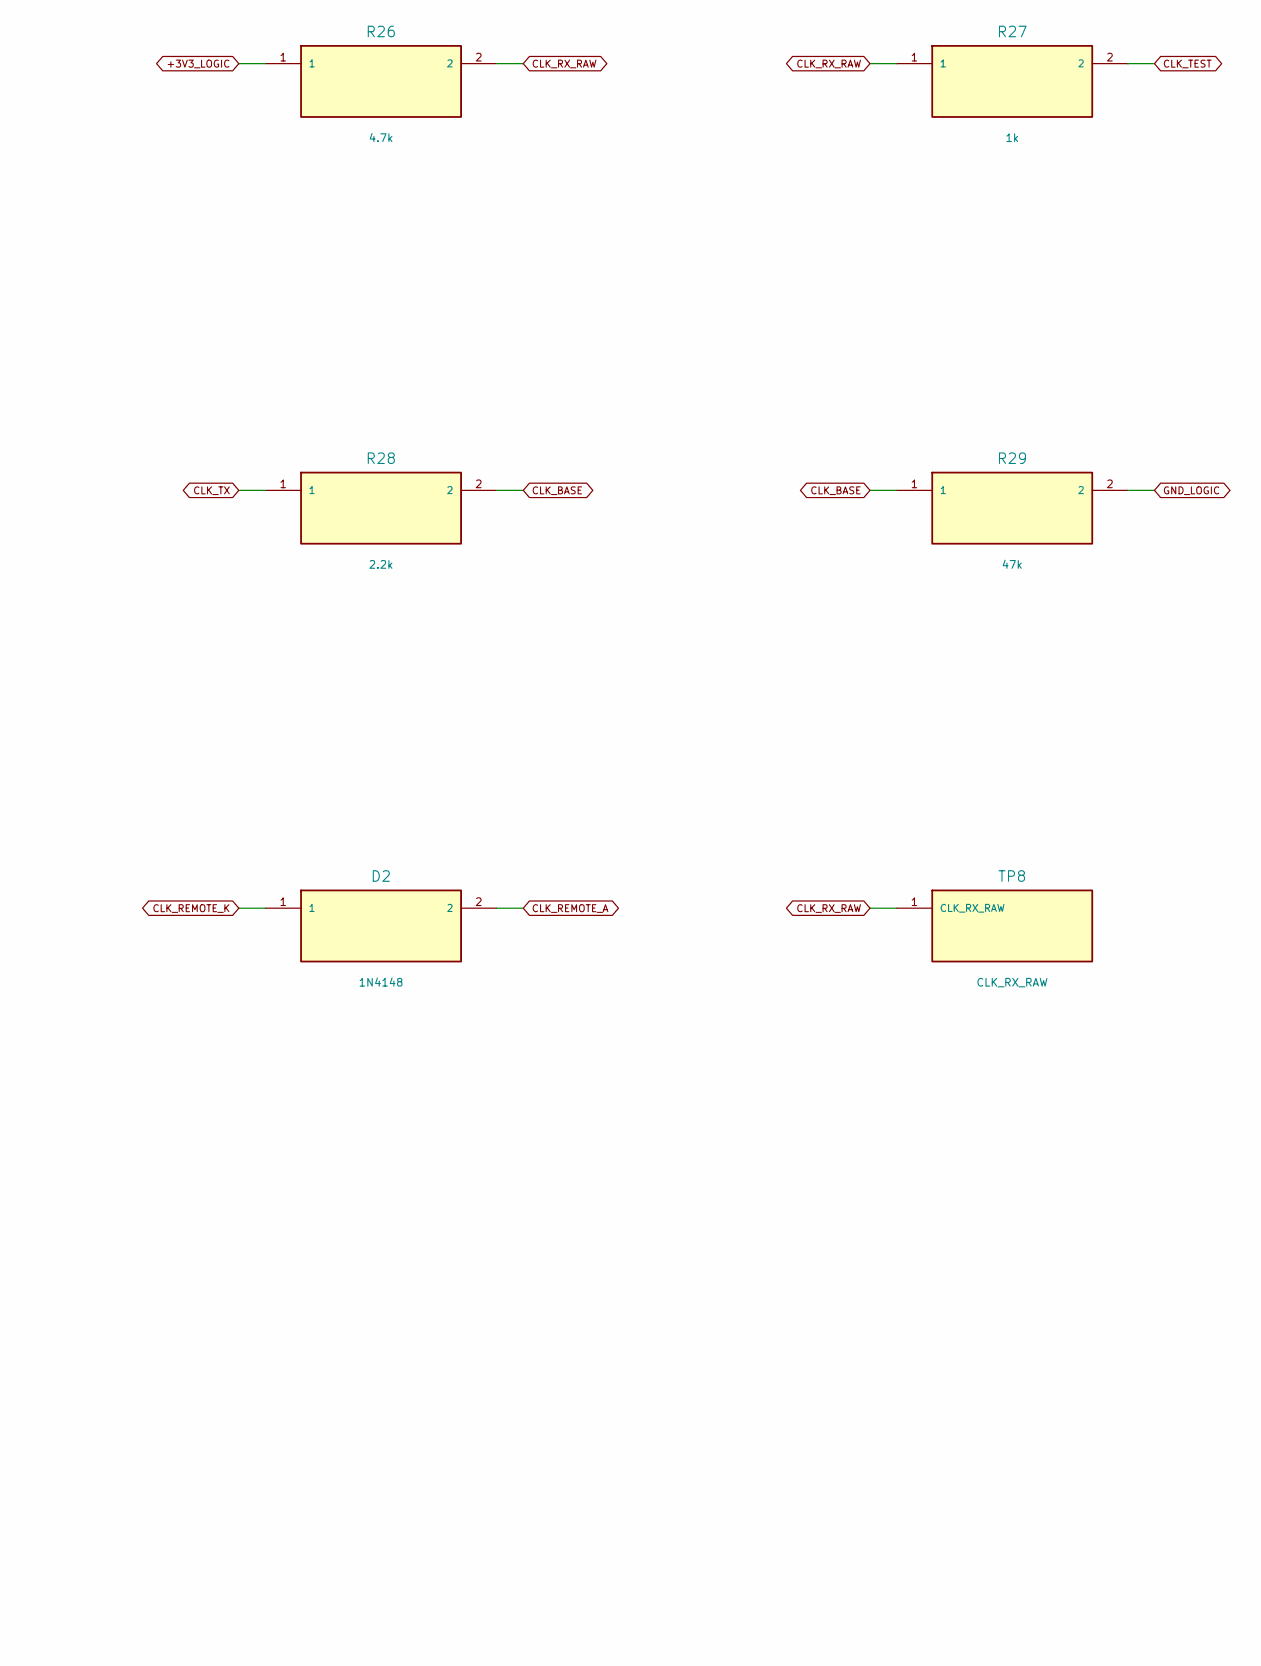
[picture p47: schematic 07_CLOCK.kicad_sch, part in row 1, column 2]

Parts:
D2: 1N4148
J8: CLK RX REMOTO +/-
J9: CLK TX +/-
JP7: CLK LINK
Q5: 2N3904
R26: 4.7k
R27: 1k
R28: 2.2k
R29: 47k
R31: 270
TP8: CLK_RX_RAW
TP10: CLK_TX
U2: PC817 DIP4

Connections:
+3V3_LOGIC: R26.1, R31.1
CLK_BASE: Q5.2 (B), R28.2, R29.1
CLK_BBB: JP7.2 (CLK_BBB)
CLK_REMOTE_A: D2.2, J8.1 (CLK_REMOTE_A), U2.1 (A)
CLK_REMOTE_K: D2.1, J8.2 (CLK_REMOTE_K), U2.2 (K)
CLK_RX_RAW: R26.2, R27.1, TP8.1, U2.4 (C)
CLK_SEND_A: J9.1 (CLK_SEND_A), R31.2
CLK_SINK: J9.2 (CLK_SINK), Q5.3 (C)
CLK_TEST: JP7.1 (CLK_TEST), R27.2
CLK_TX: R28.1, TP10.1
GND_LOGIC: Q5.1 (E), R29.2, U2.3 (E)

Notes on the sheet:
J9 A->J8 B y J9 B->J8 A por pares +/-; NO GND A-B. U2 RX activo bajo. JP7 abierto antes de medir.
