bitvalo34/trama3-ccviii/(commit log)

2026-10-27 docs: documentar T01 y aprobaciones de reloj y medios
2026-10-27 docs: registrar aceptacion de interpretacion acustica en BBB
2026-10-28 docs(t02): registrar deteccion USB inicial de BBB-A
2026-11-08 docs(t03): conciliar pedido y preparar inventario con recepcion pendiente
    [CCVIII_Materiales_y_Compras_T03.xlsx, T03-inventario.csv]
2026-11-08 docs(t03): registrar recepcion declarada y compras externas pendientes de conteo
    [CCVIII_Materiales_y_Compras_T03.xlsx, T03-inventario.csv]
2026-11-08 feat(t04): preparar auditoria y prueba reversible de pinmux con guia completa
2026-11-08 Documentar resultados reales y cierre tecnico de T04
2026-11-09 Integra sesiones matriciales 102 y cotiza pendientes de montaje
2026-11-09 Preparar interfaces T51 en KiCad y FreeCAD para revision T52
    [01_POWER.kicad_sch, 02_CORE.kicad_sch, 03_TX.kicad_sch, 04_SERVO.kicad_sch, 05_RX.kicad_sch, 06_ENABLE.kicad_sch, 07_CLOCK.kicad_sch, BOM-ensamble.csv]
2026-11-12 feat(t06): add finite PRU capture and guarded PWM hardware tests
2026-11-12 test(hardware): cover capture failures recovery and evidence acceptance
    [audit_t51.py, model.h, test_firmware.c, test_hardware.py, verify_pc.py]
